Randomperson123324/enviroment-monitor/README.md

# ENV//MONITOR

**ระบบเฝ้าระวังสภาพแวดล้อมภายในอาคารและประเมินความจดจ่อด้วยเทคโนโลยี AIoT**

*An AIoT System for Indoor Environmental Monitoring and Attention Assessment*

---

## 1. ที่มาและความสำคัญ

การเรียนและการทำงานส่วนใหญ่เกิดขึ้น**ภายในอาคาร** ซึ่งเป็นพื้นที่ปิดที่สภาพแวดล้อมเบี่ยงเบนจาก
ธรรมชาติได้มาก — คาร์บอนไดออกไซด์สะสมจากลมหายใจ อุณหภูมิถูกควบคุมด้วยเครื่องปรับอากาศ
ฝุ่นละอองลอดเข้ามาจากภายนอก และเสียงรบกวนจากคนรอบข้าง

งานวิจัยในช่วงสองทศวรรษที่ผ่านมาแสดงให้เห็นว่าปัจจัยเหล่านี้**ไม่ได้ส่งผลแค่ความสบาย** แต่กระทบถึง
สมรรถนะการคิดและความสามารถในการจดจ่ออย่างวัดได้ อย่างไรก็ตาม งานวิจัยส่วนใหญ่**ศึกษาทีละปัจจัย
ในห้องปฏิบัติการ** ขณะที่สภาพจริงปัจจัยเหล่านี้เกิดขึ้นพร้อมกัน

## 2. แนวคิดของระบบ

โครงงานนี้จึงสร้างระบบที่วัดปัจจัยแวดล้อม **หลายตัวพร้อมกันแบบต่อเนื่อง** ควบคู่กับ
**ตัวชี้วัดพฤติกรรมความจดจ่อจากกล้อง** เพื่อให้เห็นความสัมพันธ์ในสภาพการใช้งานจริง
แล้วแปลผลให้ผู้ใช้ที่ไม่ใช่ผู้เชี่ยวชาญอ่านเข้าใจได้ด้วยปัญญาประดิษฐ์

จุดที่ต่างจากเครื่องวัดอากาศทั่วไปคือ ระบบไม่ได้ตอบแค่ *"อากาศตอนนี้เป็นอย่างไร"*
แต่ตอบว่า ***"ห้องนี้กำลังส่งผลกับคนที่อยู่ในนั้นอย่างไร"***

> ที่มาของเกณฑ์เตือนทุกค่า พร้อมรายการอ้างอิง 16 รายการ อยู่ใน
> [`docs/devices/research-basis.md`](docs/devices/research-basis.md) — ใช้เป็นบทที่ 2 ของเล่มรายงาน

## 3. สถาปัตยกรรม

```
  ┌──────────── อุปกรณ์ตรวจวัด ────────────┐
  │  ESP32-S3  (esp32s3-station-01)        │
  │    SCD40   CO₂ / อุณหภูมิ / ความชื้น    │
  │    SGP30   TVOC / eCO₂                 │        ┌─────────────────┐
  │    BH1750  ความสว่าง (lux)              │───────▶│  POST           │
  │    PMS7003 PM1 / PM2.5 / PM10          │  HTTPS │  /api/ingest    │
  ├────────────────────────────────────────┤        └────────┬────────┘
  │  Raspberry Pi + กล้อง (pi-vision)       │                 │
  │    จำนวนคน · การหันหน้า · การขยับ       │─────────────────┤
  └────────────────────────────────────────┘                 ▼
                                                    ┌─────────────────┐
                                                    │    Supabase     │
                                                    │  environment    │
                                                    │  focus          │
                                                    └────────┬────────┘
                                                             ▼
                                              ┌──────────────────────────┐
                                              │  Next.js (Vercel)        │
                                              │  แดชบอร์ด · คะแนนห้อง     │
                                              │  · ผู้ช่วย AI             │
                                              └──────────────────────────┘
```

ระบบแบ่งเป็นสี่ส่วนที่ทำงานแยกกันได้ ต่อกันด้วยสัญญาข้อมูลเดียว (`POST /api/ingest`)

| ส่วน | หน้าที่ | เทคโนโลยี |
|---|---|---|
| **สถานีตรวจวัด** | อ่านเซนเซอร์ตามรอบของแต่ละตัว แล้วส่ง JSON ขึ้นเว็บ | ESP32-S3 (Arduino C++) |
| **กล้องวัดความจดจ่อ** | ประมวลผลภาพ *ในเครื่อง* ส่งออกเฉพาะตัวเลขสรุป ไม่ส่งภาพ | Raspberry Pi · Python · MediaPipe |
| **ฐานข้อมูล** | เก็บอนุกรมเวลาของทั้งสองแหล่ง | Supabase (PostgreSQL) |
| **เว็บแดชบอร์ด** | แสดงผล · ให้คะแนน · สรุปด้วย AI | Next.js · React · Chart.js |

## 4. สิ่งที่วัด

| ค่า | เซนเซอร์ | หน่วย |
|---|---|---|
| อุณหภูมิ · ความชื้น | SCD40 | °C · %RH |
| คาร์บอนไดออกไซด์ | SCD40 | ppm |
| eCO₂ · TVOC | SGP30 | ppm · ppb |
| ฝุ่นละออง PM1 / PM2.5 / PM10 | PMS7003 | µg/m³ |
| ความสว่าง | BH1750 | lux |

ทุกค่าถูกตัดสินระดับตามเกณฑ์ใน [`config/sensors.js`](config/sensors.js) แล้วหักคะแนนรวมเป็น
**คะแนนสุขภาพห้อง 0–100**

เกณฑ์ฝุ่นตัดสินจาก**ค่าเฉลี่ยย้อนหลัง** ไม่ใช่ค่าวินาทีเดียว เพราะมาตรฐานฝุ่นเป็นค่าเฉลี่ยรายวัน —
ฝุ่นหนึ่งนาทีจึงไม่ควรพลิกสถานะทั้งห้อง

## 5. หน้าจอ

| หน้า | เนื้อหา |
|---|---|
| **สภาพแวดล้อม** | ค่าปัจจุบันทุกตัวเป็นการ์ดพร้อมกราฟย่อ · กราฟย้อนหลังเต็ม · มาตร AQI · ตารางสถิติ min/avg/max · คะแนนห้องพร้อมบทสรุปจาก AI |
| **การจดจ่อ** | ข้อมูลจากกล้อง — จำนวนคนในห้อง การหันหน้า และการขยับ |
| **สุขภาพ** | ความเสี่ยงโรคที่มาจากสภาพแวดล้อมในห้อง — อุณหภูมิ ความชื้น และฝุ่น PM2.5 |

รองรับสองภาษา (ไทย/อังกฤษ) และธีมสว่าง/มืด

## 6. ปัญญาประดิษฐ์

ระบบเรียกผู้ให้บริการตามลำดับที่ตั้งไว้ จนกว่าจะมีตัวใดตอบ ถ้าล้มทั้งหมดจะตกไปที่**กลไกกฎในเครื่อง**
ซึ่งตอบได้เสมอ — แดชบอร์ดจึงไม่เคยค้างรอ AI

| ผู้ให้บริการ | ทำงานที่ไหน |
|---|---|
| เครื่องตัวเอง (llama.cpp · LM Studio · Ollama) | เครื่อง/เครือข่ายของผู้ใช้ |
| Google Gemini | คลาวด์ |
| WebLLM | ในเบราว์เซอร์ของผู้ใช้เอง ผ่าน WebGPU |

ผู้ช่วยได้รับ **เครื่องมือ** สำหรับไปอ่านข้อมูลเอง (เซนเซอร์ · ประวัติ · ระดับน้ำ · ความเสี่ยงโรค ·
ข้อมูลกล้อง · ค้นเว็บ) แทนการยัดข้อมูลทั้งก้อนลงใน prompt

> **ข้อมูลจากกล้องถูกกันไว้เป็นพิเศษ** — โมเดลในเครื่องเห็นชื่อจริง ส่วนโมเดลบนคลาวด์
> เห็นเป็น**ตัวแปร** (`{{NAME_1}}`) ชื่อคนและรหัสอุปกรณ์ถูกสลับก่อนส่งออกและสลับกลับก่อนแสดงผล
> ผู้ใช้จึงอ่านชื่อจริงตลอด ส่วนผู้ให้บริการไม่เคยเห็นสักชื่อ — สิ่งที่ออกไปคือพฤติกรรม ไม่ใช่ตัวตน
> ปิดการปิดบังตัวตนเมื่อไร คลาวด์ก็หมดสิทธิ์แตะข้อมูลกล้องทันที (`AI_FOCUS_VIA_ALIAS`)

## 7. ขอบเขตและสถานะปัจจุบัน

| หัวข้อ | สถานะ |
|---|---|
| สถานีตรวจวัด ESP32-S3 · แดชบอร์ด · คะแนนห้อง · ผู้ช่วย AI | ใช้งานได้ |
| การเชื่อมข้อมูลน้ำและข้อมูลราชการ | ใช้งานได้ |
| กล้องวัดความจดจ่อ | ใช้งานได้ — ดูโหมดและการเชื่อมต่อใน [`pi-vision/README.md`](pi-vision/README.md) |
| ระดับเสียง (dBA) | ออกแบบไว้ใน [`docs/`](docs/) แล้ว ยังไม่ได้ต่อเข้าระบบ |
| การย้ายสถานีจาก ESP32-S3 ไป Raspberry Pi 5 | เป็นเอกสารออกแบบ ยังไม่ได้ลงมือ |

## 8. โครงสร้างโค้ด

| ที่อยู่ | เนื้อหา |
|---|---|
| `app/` | หน้าเว็บและ API routes (`ingest` · `dashboard` · `history` · `disease` · `ai/*` …) |
| `components/` | ส่วนประกอบหน้าจอทั้งหมด |
| `config/` | เกณฑ์เซนเซอร์ · ค่าตั้งต้นฝั่งไคลเอนต์ · ข้อความสองภาษา |
| `lib/` | ตัวช่วยฝั่งข้อมูล — วิเคราะห์ · กราฟ · Supabase · AI |
| `hooks/` | React hooks (ดึงข้อมูล · ตั้งค่า · ธีม · ภาษา) |
| `multi_sensor_esp32s3/` | เฟิร์มแวร์สถานีตรวจวัด |
| `pi-vision/` | โปรแกรมกล้องฝั่ง Raspberry Pi |
| `docs/` | เอกสารฮาร์ดแวร์ทั้งชุด |

## 9. การติดตั้ง

ต้องมี **Node.js 20** ขึ้นไป

```bash
npm install
cp .env.example .env.local     # ใส่ SUPABASE_URL และ SUPABASE_ANON_KEY
npm run dev                    # http://localhost:3000
```

จำเป็นแค่สองค่าแรกก็รันได้ ที่เหลือมีค่าตั้งต้นอยู่แล้ว — คำอธิบายทุกตัวอยู่ใน [`.env.example`](.env.example)

ระบบดีพลอยบน Vercel โดยคอมมิตที่เข้า `main` จะขึ้น production อัตโนมัติ

## 10. เอกสารเพิ่มเติม

| เอกสาร | เนื้อหา |
|---|---|
| [`docs/README.md`](docs/README.md) | สารบัญเอกสารฮาร์ดแวร์ทั้งชุด |
| [`docs/01-architecture.md`](docs/01-architecture.md) | สถาปัตยกรรมและตารางสรุปเซนเซอร์ |
| [`docs/02-wiring.md`](docs/02-wiring.md) | pinout · I2C address map · ผังต่อสาย |
| [`docs/03-power-budget.md`](docs/03-power-budget.md) | งบกระแสและการเลือกแหล่งจ่ายไฟ |
| [`docs/04-calibration.md`](docs/04-calibration.md) | ขั้นตอนสอบเทียบทุกตัว |
| [`docs/05-data-schema.md`](docs/05-data-schema.md) | คอลัมน์ในฐานข้อมูลและ ingest contract |
| [`docs/06-ai-providers.md`](docs/06-ai-providers.md) | การตั้งค่าผู้ให้บริการ AI |
| [`docs/devices/research-basis.md`](docs/devices/research-basis.md) | ทบทวนวรรณกรรมและที่มาของเกณฑ์ |
| [`pi-vision/README.md`](pi-vision/README.md) | โหมดกล้อง · การวัดความจดจ่อ · การต่อกับแดชบอร์ด |
