Randomperson123324/enviroment-monitor/docs/03-power-budget.md

# 03 — งบกำลังไฟ

[← กลับสารบัญ](README.md)

---

## 1. สรุปสั้น

| ราง | โหลดเฉลี่ย | โหลดสูงสุด (peak) | เพียงพอไหม |
|---|---|---|---|
| ราง | โหลดเฉลี่ย | โหลดสูงสุด (peak) | สถานะ |
|---|---|---|---|
| **3V3** (จากหัวต่อ GPIO) | ~78 mA | ~270 mA | ⚠️ ต้องมี bulk capacitor — ดู [§2](#2-งบกระแสราง-3v3) |
| **5V** (จากหัวต่อ GPIO) | 250 mA | 330 mA | ✅ สบาย |
| **USB** (ไมค์ + webcam) | ~150–400 mA | ~600 mA | ⚠️ ต้องใช้ PSU 5V/5A ไม่งั้นถูกจำกัดที่ 600 mA รวม |
| **Pi 5 เอง** | ~1.0–1.5 A @5V | ~2.5 A @5V | — |
| **รวมทั้งระบบ** | ~9.3 W | ~17.5 W | ✅ ใช้ PSU 27W ทางการ |

**สรุป: ใช้ Raspberry Pi 27W USB-C Power Supply (5.1V / 5A) ของทางการ ไม่มีข้อยกเว้น**

---

## 2. งบกระแสราง 3V3

ทุกตัวจ่ายไฟจากขา 3V3 ของหัวต่อ GPIO

| อุปกรณ์ | กระแสเฉลี่ย | กระแสสูงสุด | ที่มา |
|---|---|---|---|
| SCD40 | 15–18 mA (รอบวัด 5 วินาที) | **175–205 mA** (พัลส์ตอนวัด) | datasheet ตาราง 4, VDD = 3.3V |
| SGP30 breakout | ~50–60 mA | ~65 mA | ตัวชิป 48.2 mA @1.8V + LDO บน breakout |
| BH1750 | 0.12 mA | 0.19 mA | โหมดวัดต่อเนื่อง |
| ADS1115 | 0.15 mA | 0.2 mA | โหมดแปลงต่อเนื่อง |
| **รวม** | **~78 mA** | **~270 mA** | |

### ⚠️ Raspberry Pi ไม่เคยประกาศเพดานกระแสของขา 3V3

Raspberry Pi Ltd **ไม่ได้ระบุค่าสูงสุดของขา 3V3 บนหัวต่อ GPIO ไว้ในเอกสารทางการ** เพราะ
ค่าที่ใช้ได้จริงคือ "สิ่งที่ PMIC จ่ายได้ ลบด้วยสิ่งที่ SoC และวงจรอื่นบนบอร์ดใช้ไป"
ซึ่งเปลี่ยนตามภาระงานของบอร์ด — จึงไม่มีตัวเลขรับประกัน

**สิ่งที่พูดได้อย่างมั่นใจ:**

- กระแสเฉลี่ย ~78 mA เป็นภาระที่ต่ำมาก — แทบไม่มีความเสี่ยง
- **พัลส์ 270 mA ของ SCD40 คือส่วนที่ต้องจัดการ** ไม่ใช่เพราะปริมาณ แต่เพราะเป็นการกระชากเร็ว
  ที่ทำให้แรงดันตกชั่วขณะบนสายและกวนอุปกรณ์ I2C ตัวอื่น
- **bulk capacitor คือทางแก้** — มันจ่ายพลังงานให้พัลส์แทนที่จะดึงจากรางโดยตรง

**ถ้าต้องการความมั่นใจสูงสุด** (เช่น จะเพิ่มเซนเซอร์อีกในอนาคต) ให้จ่ายไฟ 3.3V
ให้กลุ่มเซนเซอร์จาก **LDO แยก** ที่รับ 5V จากหัวต่อ GPIO แทนการดึงจากขา 3V3 โดยตรง
เช่น AMS1117-3.3 หรือ MCP1700-3302 — ราคาไม่กี่บาทและตัดปัญหาทั้งหมดทิ้ง
(อย่าลืมต่อกราวด์ร่วมกับ Pi และคง capacitor ทั้งหมดไว้ตามเดิม)

### ทำไมต้องมี bulk capacitor

SCD40 กินกระแสเป็น**พัลส์** — ตอนยิงแหล่งกำเนิด IR จะกระชากถึง 205 mA ในช่วงสั้น ๆ ทุก 5 วินาที
ถ้าสายไฟยาวหรือบาง แรงดันจะตกชั่วขณะ (droop) และไปกวนอุปกรณ์ I2C ตัวอื่นบนบัสเดียวกัน

datasheet ระบุชัดว่า **ripple ของแหล่งจ่ายต้องไม่เกิน 30 mV peak-to-peak** ไม่งั้นค่า CO₂ จะไม่นิ่ง

**สิ่งที่ต้องทำ:**

```
3V3 ──┬── 100 µF อิเล็กโทรไลต์/แทนทาลัม ──┬── GND     ← วางใกล้ SCD40 ที่สุด
      └── 100 nF เซรามิก ─────────────────┘            ← คร่อม VDD-GND ของแต่ละบอร์ด
```

- **100 µF** วางที่ปลายสายฝั่งเซนเซอร์ (ไม่ใช่ฝั่ง Pi) รับพัลส์ของ SCD40
- **100 nF** หนึ่งตัวต่อหนึ่งบอร์ด คร่อมขา VDD–GND ให้ใกล้ที่สุด (SGP30 datasheet บังคับข้อนี้)
- ใช้สายเบอร์ใหญ่ขึ้น (AWG 24 แทน AWG 28) สำหรับราง 3V3 ถ้าสายยาวเกิน 20 cm

---

## 3. งบกระแสราง 5V

| อุปกรณ์ | กระแสเฉลี่ย | กระแสสูงสุด | ที่มา |
|---|---|---|---|
| PMS7003 (พัดลม + เลเซอร์) | ≤100 mA | ~150 mA ตอนสตาร์ทพัดลม | datasheet: active ≤100 mA · standby ≤200 µA |
| MQ-2 (ฮีตเตอร์) *ถ้าใช้* | ~150 mA | ~180 mA | ฮีตเตอร์ ~800 mW ต่อเนื่อง |
| **รวม** | **250 mA** | **330 mA** | |

### กระแสกระชากตอนสตาร์ทพัดลม PMS7003

มอเตอร์พัดลมกินกระแสสูงกว่าปกติในช่วง ~100 ms แรกตอนเริ่มหมุน ถ้าใช้โหมด sleep/wake บ่อย ๆ
(ผ่านขา SET) จะเกิดพัลส์แบบนี้ทุกครั้ง

**ทางแก้:** วาง capacitor **220 µF** คร่อม VCC–GND ที่ขั้วต่อ PMS7003 และ**อย่าใช้โหมด sleep/wake
ในการทำงานปกติ** — ปล่อยให้พัดลมหมุนต่อเนื่องนิ่งกว่า แถม datasheet ยังบอกว่าต้องรอ 30 วินาที
หลังตื่นถึงจะได้ค่าที่เชื่อถือได้ ซึ่งทำให้แทบไม่ประหยัดไฟเลยถ้ารอบอัปโหลดคือ 5 วินาที

> โหมด sleep มีประโยชน์เฉพาะกรณีใช้แบตเตอรี่และวัดแบบนาน ๆ ครั้ง (เช่นทุก 10 นาที) เท่านั้น

---

## 4. งบกระแส USB — ประเด็นสำคัญ

Raspberry Pi 5 **จำกัดกระแสรวมของพอร์ต USB ทั้งสี่ไว้ที่ 600 mA** เป็นค่าเริ่มต้น
และจะปลดล็อกเป็น **1.6 A ก็ต่อเมื่อตรวจพบ PSU ที่จ่าย 5V/5A ผ่าน USB Power Delivery**

| อุปกรณ์ USB | กระแส |
|---|---|
| USB microphone (UAC ธรรมดา) | ~50–100 mA |
| USB webcam 720p | ~150–250 mA |
| USB webcam 1080p (เช่น C920) | ~250–400 mA |

**สถานการณ์:**

| PSU ที่ใช้ | เพดาน USB | ไมค์อย่างเดียว | ไมค์ + webcam 1080p |
|---|---|---|---|
| อะแดปเตอร์ 5V/3A ทั่วไป | 600 mA | ✅ ผ่าน | ⚠️ เสี่ยงเกิน — ภาพกระตุก/หลุด |
| **Raspberry Pi 27W ทางการ (5V/5A)** | 1.6 A | ✅ ผ่าน | ✅ ผ่านสบาย |

> ถ้าจำเป็นต้องใช้ PSU ที่ไม่ใช่ตัวทางการ สามารถบังคับปลดล็อกได้ด้วย
> `usb_max_current_enable=1` ใน `/boot/firmware/config.txt`
> **แต่ต้องแน่ใจว่า PSU จ่ายได้จริง 5A** ไม่งั้นแรงดันจะตกจนบอร์ดรีบูตเอง หรือ SD card เสียหาย

**ทางเลือกที่ปลอดภัยกว่า** สำหรับกล้อง: ใช้ **Camera Module 3 ผ่าน CSI-2** แทน USB webcam
เพราะไม่กินโควตา USB เลย → ดู [devices/camera.md](devices/camera.md)

---

## 5. งบกำลังไฟรวมทั้งระบบ

| ส่วน | กำลัง (เฉลี่ย) | กำลัง (สูงสุด) |
|---|---|---|
| Raspberry Pi 5 (ไม่มีโหลด CPU หนัก) | ~5.0 W | ~9 W |
| Pi 5 ตอนประมวลผลภาพ (face detection) | +2.0 W | +4 W |
| เซนเซอร์ราง 3V3 | 0.26 W | 0.89 W |
| เซนเซอร์ราง 5V | 1.25 W | 1.65 W |
| USB (ไมค์ + webcam) | 0.75 W | 2.00 W |
| **รวม** | **~9.3 W** | **~17.5 W** |
| **PSU 27W ทางการ** | | **เหลือหัว ~35%** ✅ |

> ตัวเลข "สูงสุด" คือกรณีที่ทุกอย่างกินกระแสสูงสุดพร้อมกัน ซึ่งในทางปฏิบัติแทบไม่เกิดขึ้น
> (SCD40 กระชากเป็นพัลส์สั้น ๆ ทุก 5 วินาที ไม่ตรงกับจังหวะพัดลม PMS7003 สตาร์ท)
> จึงเป็นการประเมินแบบอนุรักษ์นิยม — ปลอดภัยสำหรับการเลือก PSU

---

## 6. Checklist ก่อนเสียบไฟครั้งแรก

- [ ] ใช้ Raspberry Pi 27W USB-C PSU ของทางการ (หรือ PSU ที่รับรอง 5V/5A จริง)
- [ ] SCD40 อยู่ราง **3V3** ไม่ใช่ 5V — ตรวจซ้ำด้วยมัลติมิเตอร์ก่อนเสียบไฟ
- [ ] PMS7003 อยู่ราง **5V** และต่อครบทั้งขา 1+2 (VCC) และ 3+4 (GND)
- [ ] มี 100 nF คร่อม VDD–GND ของทุกบอร์ด I2C
- [ ] มี 100 µF ที่ปลายสาย 3V3 ฝั่งเซนเซอร์
- [ ] มี 220 µF ที่ขั้ว VCC ของ PMS7003
- [ ] กราวด์ทุกตัวต่อร่วมกับ Pi
- [ ] สาย I2C ยาวไม่เกิน 30 cm
- [ ] ขา 6 และ 8 ของ PMS7003 (NC) ไม่ได้ต่ออะไร

## 7. อาการเมื่อไฟไม่พอ และวิธีวินิจฉัย

| อาการ | สาเหตุที่น่าจะเป็น | วิธีตรวจ |
|---|---|---|
| ค่า CO₂ กระโดดขึ้นลงเป็นฟันเลื่อย | ripple ราง 3V3 เกิน 30 mV | เพิ่ม bulk cap · ใช้สายหนาขึ้น · วัด ripple ด้วยออสซิลโลสโคป |
| `i2cdetect` เจออุปกรณ์ไม่ครบเป็นบางครั้ง | แรงดันตกตอน SCD40 ยิงพัลส์ | เพิ่ม 100 µF ใกล้ SCD40 |
| Pi รีบูตเองตอนพัดลม PMS7003 สตาร์ท | กระแสกระชากเกินที่ PSU จ่ายไหว | เพิ่ม 220 µF · เปลี่ยน PSU |
| ไอคอนสายฟ้าขึ้นบนหน้าจอ / `Undervoltage detected` ใน `dmesg` | PSU ไม่พอหรือสาย USB-C คุณภาพต่ำ | `vcgencmd get_throttled` — ควรได้ `0x0` |
| webcam หลุดเป็นระยะ | เกินโควตา USB 600 mA | ใช้ PSU 5A · หรือย้ายไปใช้ CSI camera |

ตรวจสถานะไฟด้วย:

```bash
vcgencmd get_throttled        # 0x0 = ปกติ · bit 0 = under-voltage ตอนนี้ · bit 16 = เคยเกิด
vcgencmd measure_volts core
dmesg | grep -iE 'voltage|usb.*current|over-?current'
```

---

[← ก่อนหน้า: การต่อสาย](02-wiring.md) · [ถัดไป: การ calibrate →](04-calibration.md)
