Randomperson123324/enviroment-monitor/docs/devices/scd40.md

# SCD40 — เซนเซอร์ CO₂ / อุณหภูมิ / ความชื้น

[← กลับสารบัญ](../README.md) · [ผู้ผลิต: Sensirion](https://sensirion.com/media/documents/48C4B7FB/67FE0194/CD_DS_SCD4x_Datasheet_D1.pdf)

> **บทบาทในระบบนี้:** SCD40 เป็น**แหล่งข้อมูลหลัก**ของทั้ง CO₂, อุณหภูมิ และความชื้น
> มาแทน DHT22 เดิมทั้งหมด — แม่นกว่า, มี CRC, และไม่มีปัญหา timing ที่ DHT มี

---

## 1. สเปกจาก datasheet (v1.7, เมษายน 2025)

### การวัด CO₂

| รายการ | ค่า |
|---|---|
| หลักการทำงาน | Photoacoustic NDIR |
| ช่วงค่าที่ส่งออก | 0–40,000 ppm |
| ความแม่นยำ | **±(50 ppm + 5% ของค่าที่อ่าน)** ที่ 400–2,000 ppm |
| ความสามารถทำซ้ำ | ±10 ppm |
| เวลาตอบสนอง (τ63%) | 60 วินาที (เปลี่ยนจาก 400 → 2,000 ppm) |
| การ drift หลังปีที่ 5 | ±(5 ppm + 0.5% ของค่าที่อ่าน) ต่อปี |

### การวัดความชื้น

| รายการ | ค่า |
|---|---|
| ช่วงวัด | 0–100 %RH |
| ความแม่นยำ | ±6 %RH (ที่ 15–35 °C, 20–65 %RH) · ±9 %RH (ที่ −10–60 °C, 0–100 %RH) |
| ความสามารถทำซ้ำ | ±0.4 %RH |
| เวลาตอบสนอง (τ63%) | 90 วินาที |
| การ drift | < 0.25 %RH/ปี |

### การวัดอุณหภูมิ

| รายการ | ค่า |
|---|---|
| ช่วงวัด | −10 ถึง 60 °C |
| ความแม่นยำ | ±0.8 °C (ที่ 15–35 °C) · ±1.5 °C (ที่ −10–60 °C) |
| ความสามารถทำซ้ำ | ±0.1 °C |
| เวลาตอบสนอง (τ63%) | 120 วินาที |
| การ drift | < 0.03 °C/ปี |

### ไฟฟ้า

| รายการ | ค่า |
|---|---|
| แรงดันไฟเลี้ยง | 2.4 – 5.5V (ปกติ 3.3V หรือ 5.0V) |
| **Ripple ที่ยอมรับได้** | **≤ 30 mV peak-to-peak** ⚠️ |
| กระแสสูงสุด (peak) | 175 mA ปกติ / **205 mA สูงสุด** ที่ VDD = 3.3V |
| กระแสเฉลี่ย (รอบ 5 วินาที) | 15 mA ปกติ / 18 mA สูงสุด ที่ VDD = 3.3V |
| กระแสเฉลี่ย (โหมดประหยัด รอบ 30 วินาที) | 3.2 mA ปกติ / 3.5 mA สูงสุด |
| แรงดัน input HIGH | ≥ 0.65 × VDD |
| แรงดัน input LOW | ≤ 0.3 × VDD |
| เวลาบูตหลังจ่ายไฟ | 30 ms |
| ความถี่ SCL | 0 – 400 kHz |
| ที่อยู่ I2C | **`0x62`** (ตายตัว เปลี่ยนไม่ได้) |
| อายุการใช้งาน | > 10 ปี |
| ความชื้นที่ทำงานได้ | 0–95 %RH (ไม่ควบแน่น) |

---

## 2. ⚠️ คำเตือนเรื่องแรงดัน

**SCD40 ในระบบนี้ต้องจ่ายไฟ 3.3V เท่านั้น**

datasheet ระบุว่ารับไฟได้ 2.4–5.5V ซึ่งถูกต้อง — แต่ระดับลอจิกของขา SDA/SCL **อ้างอิงกับ VDD**:

| VDD | V<sub>IH</sub> (ต้องการอย่างน้อย) | ระดับสัญญาณที่เซนเซอร์ปล่อยออกมาบนบัส |
|---|---|---|
| 3.3V | 2.15V | 0 – 3.3V ✅ ปลอดภัยกับ Pi |
| 5.0V | 3.25V | 0 – 5.0V ❌ **ทำ GPIO ของ Pi พัง** |

Raspberry Pi ทนได้สูงสุด 3.3V บนขา GPIO **การจ่ายไฟ 5V ให้ SCD40 จะทำให้ pull-up ภายในเซนเซอร์
ดึงบัส I2C ขึ้นไป 5V และทำลาย GPIO ของ Pi อย่างถาวร**

> ✅ ต่อ VDD ของ SCD40 เข้าขา 1 (3V3) ของ Pi
> ❌ **ห้าม**ต่อเข้าขา 2 หรือ 4 (5V) เด็ดขาด
> 🔍 วัดด้วยมัลติมิเตอร์ยืนยันก่อนเสียบไฟครั้งแรก

**ผลข้างเคียงที่ต้องยอมรับ:** ที่ 3.3V เซนเซอร์กินกระแส peak สูงกว่า (205 mA เทียบกับ 137 mA ที่ 5V)
จึงต้องมี bulk capacitor → ดู [03-power-budget.md](../03-power-budget.md#ทำไมต้องมี-bulk-capacitor)

---

## 3. การต่อสาย

| SCD40 | หน้าที่ | → Pi 5 (ขา) |
|---|---|---|
| VDD | ไฟเลี้ยง | **ขา 1 (3V3)** |
| VDDH | ไฟเลี้ยงแหล่ง IR | ต่อร่วมกับ VDD (บอร์ด breakout ต่อให้แล้ว) |
| GND | กราวด์ | ขา 20 (GND) |
| SDA | ข้อมูล I2C | ขา 3 (GPIO2) |
| SCL | นาฬิกา I2C | ขา 5 (GPIO3) |
| DNC | ห้ามต่อ | — |

พร้อม capacitor 100 nF คร่อม VDD–GND และ 100 µF ที่ปลายสายฝั่งเซนเซอร์

---

## 4. คำสั่ง I2C ที่ใช้

ทุกคำสั่งเป็นรหัส 16 บิต · ข้อมูลทุก word (2 ไบต์) ตามด้วย **CRC-8 หนึ่งไบต์**
(polynomial `0x31`, init `0xFF`, ไม่ reflect, final XOR `0x00` — เหมือนกับ SGP30)

| คำสั่ง | รหัส | ใช้ตอนไหน |
|---|---|---|
| `start_periodic_measurement` | `0x21B1` | เริ่มวัดต่อเนื่อง (อัปเดตทุก 5 วินาที) |
| `read_measurement` | `0xEC05` | อ่านค่า CO₂ + T + RH (9 ไบต์) |
| `stop_periodic_measurement` | `0x3F86` | หยุดก่อนส่งคำสั่งตั้งค่า |
| `set_temperature_offset` | `0x241D` | ชดเชยความร้อนจากบอร์ด 🔑 |
| `set_sensor_altitude` | `0x2427` | ตั้งความสูงจากระดับน้ำทะเล (เมตร) |
| `set_ambient_pressure` | `0xE000` | ตั้งความดันบรรยากาศ (Pa) — แม่นกว่า altitude |
| `perform_forced_recalibration` | `0x362F` | calibrate แบบบังคับ (FRC) |
| `set_automatic_self_calibration_enabled` | `0x2416` | เปิด/ปิด ASC |
| `get_data_ready_status` | `0xE4B8` | เช็คว่ามีค่าใหม่พร้อมหรือยัง |
| `get_serial_number` | `0x3682` | ตรวจว่าเซนเซอร์ตอบสนอง |
| `persist_settings` | `0x3615` | บันทึกค่าตั้งลง EEPROM ⚠️ ใช้ให้น้อยที่สุด |
| `reinit` | `0x3646` | โหลดค่าจาก EEPROM ใหม่ |

### รูปแบบข้อมูลที่อ่านได้ (`read_measurement`)

ตอบกลับ 9 ไบต์:

```
[CO2_MSB][CO2_LSB][CRC]  [T_MSB][T_LSB][CRC]  [RH_MSB][RH_LSB][CRC]
```

**สูตรแปลงค่า:**

```
CO₂ (ppm)  = ค่าดิบ                              (ใช้ได้ตรง ๆ)
T  (°C)    = −45 + 175 × (ค่าดิบ / 2¹⁶)
RH (%)     = 100 × (ค่าดิบ / 2¹⁶)
```

### ลำดับการทำงานที่ถูกต้อง

```
1. รอ 30 ms หลังจ่ายไฟ (power-up time)
2. stop_periodic_measurement      ← เผื่อค้างจากรอบก่อน · รอ 500 ms
3. get_serial_number              ← ยืนยันว่าเซนเซอร์ตอบสนอง
4. set_temperature_offset(ค่าจาก config)
5. set_sensor_altitude(ค่าจาก config)  หรือ  set_ambient_pressure()
6. set_automatic_self_calibration_enabled(ค่าจาก config)
7. start_periodic_measurement
8. วนลูป: ทุก 5 วินาที → get_data_ready_status → read_measurement
```

> ⚠️ **ระหว่างที่ periodic measurement ทำงานอยู่ ห้ามส่งคำสั่งอื่น**
> ยกเว้น `read_measurement`, `get_data_ready_status`, `stop_periodic_measurement`
> และ `set_ambient_pressure` เท่านั้น

> ⚠️ **`persist_settings` เขียน EEPROM ซึ่งมีจำนวนรอบจำกัด**
> เรียกเฉพาะตอนตั้งค่าครั้งแรกหรือหลัง calibrate เท่านั้น **ห้ามเรียกทุกครั้งที่บูต**

---

## 5. ไลบรารี Python

```bash
pip install sensirion-i2c-scd4x sensirion-i2c-driver
# หรือ
pip install adafruit-circuitpython-scd4x
```

| ไลบรารี | ข้อดี | ข้อเสีย |
|---|---|---|
| `sensirion-i2c-scd4x` | ทางการจากผู้ผลิต · ครบทุกคำสั่ง | เอกสารน้อยกว่า |
| `adafruit-circuitpython-scd4x` | ใช้ง่าย · ตัวอย่างเยอะ | ต้องพึ่ง Blinka |

> **แนะนำ `sensirion-i2c-scd4x`** เพราะเป็นของผู้ผลิตโดยตรง จึงตามการเปลี่ยนแปลงของ datasheet ทัน
> และรองรับคำสั่ง FRC/ASC ครบถ้วนซึ่งจำเป็นสำหรับโปรเจกต์นี้

---

## 6. 🔑 Temperature offset — ขั้นตอนที่สำคัญที่สุด

SCD40 วัดอุณหภูมิที่ตัวชิปเอง ซึ่ง**ร้อนกว่าอากาศจริงเสมอ** เพราะ:

1. ความร้อนที่ตัวเซนเซอร์สร้างเอง (self-heating)
2. ความร้อนจาก SoC ของ Pi 5 ที่แผ่มาตามแผ่น PCB และอากาศ

**ค่านี้ไม่กระทบแค่อุณหภูมิ** — เซนเซอร์ใช้ค่าอุณหภูมิไปคำนวณความชื้นสัมพัทธ์ด้วย
ดังนั้น offset ที่ผิดจะทำให้ **RH ผิดตามไปด้วย** และ datasheet ระบุว่า
ค่าความแม่นยำที่โฆษณาไว้ทั้งหมดจะเป็นจริง**ก็ต่อเมื่อตั้ง temperature offset ถูกต้อง**

**ค่าเริ่มต้นจากโรงงานคือ 4 °C** ซึ่งเหมาะกับการติดตั้งบน PCB เล็ก ๆ ไม่ใช่กรณีนี้

### วิธีหาค่า offset ที่ถูกต้อง

```
1. ประกอบระบบให้เสร็จสมบูรณ์ในกล่อง/ตำแหน่งจริงที่จะใช้งาน
2. เปิดระบบทิ้งไว้ให้อุณหภูมิเข้าสู่สมดุล  ≥ 30 นาที  (ไม่ใช่ 5 นาที)
3. วางเทอร์โมมิเตอร์อ้างอิงที่แม่นยำไว้ข้าง ๆ ตัวเซนเซอร์
4. offset ใหม่ = offset ปัจจุบัน + (T ที่ SCD40 อ่าน − T อ้างอิง)
5. set_temperature_offset(offset ใหม่)
6. persist_settings()      ← เรียกครั้งเดียวเท่านั้น
7. รออีก 30 นาที แล้วตรวจซ้ำ
```

ค่าที่พบบ่อยเมื่อวางใกล้ Pi 5: **6–10 °C** (สูงกว่าค่าเริ่มต้น 4 °C มาก)

> **วิธีที่ดีกว่าการปรับ offset สูง ๆ คือย้ายเซนเซอร์ให้ห่างจากแหล่งความร้อน**
> ต่อ SCD40 ผ่านสาย I2C ยาว 10–20 cm ออกไปนอกกล่อง แล้ว offset จะเหลือแค่ 1–3 °C
> ซึ่งแม่นยำกว่ามาก เพราะการชดเชยด้วยตัวเลขคงที่จะไม่แม่นเมื่อโหลด CPU เปลี่ยน

---

## 7. การชดเชยความดันบรรยากาศ

การวัด CO₂ แบบ NDIR ขึ้นกับความหนาแน่นของอากาศ จึงต้องบอกความสูงหรือความดันให้เซนเซอร์ทราบ

| วิธี | คำสั่ง | ความแม่นยำ | หมายเหตุ |
|---|---|---|---|
| ตั้งความสูง (คงที่) | `set_sensor_altitude` (เมตร) | พอใช้ | ตั้งครั้งเดียว · ต้อง persist |
| ตั้งความดัน (แบบไดนามิก) | `set_ambient_pressure` (Pa) | **แม่นกว่า** | ส่งใหม่ได้ตลอดขณะวัด · ไม่ต้อง persist |

ค่าความสูงคร่าว ๆ ในไทย: กรุงเทพฯ ~2 m · เชียงใหม่ ~310 m · เชียงราย ~400 m · นครราชสีมา ~180 m

> ที่ระดับความสูงต่ำอย่างกรุงเทพฯ ผลกระทบแทบไม่มีนัยสำคัญ (< 1%)
> แต่ควรตั้งไว้เพื่อความถูกต้อง และ**จำเป็น**ถ้าติดตั้งบนภาคเหนือ

**ทางเลือกขั้นสูง:** ถ้าอยากส่งค่าความดันจริงเข้า `set_ambient_pressure` แบบไดนามิก
ต้องหาแหล่งข้อมูลความกดอากาศเอง — โปรเจกต์นี้เคยดึงฟีดกรมอุตุฯ (TMD) ผ่าน `lib/gov.js`
แต่ถอดออกแล้ว เหลือเฉพาะข้อมูลน้ำ (ThaiWater · กรมชลประทาน) — และเป็นงาน optimization
ที่ทำทีหลังได้ ไม่ต้องรีบ

---

## 8. การ calibrate CO₂ — ASC เทียบกับ FRC

รายละเอียดเต็มอยู่ใน [04-calibration.md](../04-calibration.md#scd40--co₂) — สรุปตรงนี้:

| | **ASC** (Automatic Self-Calibration) | **FRC** (Forced Recalibration) |
|---|---|---|
| หลักการ | สมมติว่าค่าต่ำสุดที่เจอในรอบ ~7 วันคืออากาศบริสุทธิ์ (400 ppm) | บอกเซนเซอร์ตรง ๆ ว่าตอนนี้คือกี่ ppm |
| ต้องการอะไร | ต้องได้สัมผัสอากาศ ~400 ppm **สัปดาห์ละครั้ง** | ต้องพาไปที่อากาศบริสุทธิ์ครั้งเดียว |
| ข้อดี | ตั้งแล้วลืมได้ | แม่นทันที ควบคุมได้ |
| ข้อเสีย | **ห้องที่ปิดตลอดจะทำให้ค่าเพี้ยนสะสม** | ต้องทำเอง |
| ค่าเริ่มต้น | เปิดอยู่ | — |

### ⚠️ ประเด็นสำคัญสำหรับห้องปรับอากาศในไทย

ห้องแอร์ที่ปิดตลอดเวลามักไม่เคยลงถึง 400 ppm เลย (มักอยู่ที่ 600–1,200 ppm)
ASC จะเข้าใจผิดว่าค่าต่ำสุดที่เจอ (เช่น 650 ppm) คือ 400 ppm แล้ว**ลบทุกค่าลงไป 250 ppm**
ทำให้ค่าที่แสดงต่ำกว่าความจริงอย่างเป็นระบบ

**แนวทางที่แนะนำ:**

| สถานการณ์ | ทำอย่างไร |
|---|---|
| ห้องเปิดหน้าต่าง/ระบายอากาศทุกสัปดาห์ | เปิด ASC ไว้ (ค่าเริ่มต้น) |
| **ห้องแอร์ปิดตลอด** | **ปิด ASC** แล้วทำ FRC ทุก 6–12 เดือน |
| ไม่แน่ใจ | ปิด ASC + ทำ FRC — ปลอดภัยกว่า |

> datasheet ระบุว่าควรทำ FRC **หลังประกอบเสร็จอย่างน้อย 5 วัน** ไม่ใช่ทันที
> เพราะสารระเหยจากบัดกรีและกาวยังรบกวนค่าอยู่

---

## 9. เกณฑ์ค่า CO₂ ที่แนะนำสำหรับแดชบอร์ด

| ระดับ | ช่วง (ppm) | ความหมาย |
|---|---|---|
| อากาศภายนอก | 400–450 | ค่าอ้างอิงอากาศบริสุทธิ์ |
| ดี | < 800 | การระบายอากาศเพียงพอ |
| ปานกลาง | 800–1,000 | เริ่มควรระบายอากาศ |
| แย่ | 1,000–1,500 | เริ่มมีผลต่อสมาธิและความง่วง |
| แย่มาก | 1,500–2,500 | ปวดหัว เหนื่อย สมาธิลดลงชัดเจน |
| อันตราย | > 2,500 | ต้องระบายอากาศทันที |

> 1,000 ppm เป็นเกณฑ์ที่ใช้กันแพร่หลายในมาตรฐานคุณภาพอากาศภายในอาคาร
> และเหมาะกับโปรเจกต์นี้เป็นพิเศษเพราะเชื่อมโยงโดยตรงกับ **Focus feature** —
> CO₂ สูงสัมพันธ์กับสมาธิที่ลดลงและความง่วง ซึ่งเป็นสิ่งที่ webcam EAR detection วัดอยู่แล้ว

ค่าเหล่านี้ต้องอยู่ใน `config/sensors.js → THRESHOLDS.co2` เท่านั้น

---

## 10. การแก้ปัญหา

| อาการ | สาเหตุที่น่าจะเป็น | วิธีแก้ |
|---|---|---|
| `i2cdetect` ไม่เจอ `0x62` | ไฟไม่ถึง · SDA/SCL สลับ · กราวด์ไม่ร่วม | ตรวจ 3.3V ที่ VDD · ตรวจสาย |
| อุณหภูมิสูงกว่าจริง 5–10 °C | temperature offset ผิด | ทำตาม [§6](#6--temperature-offset--ขั้นตอนที่สำคัญที่สุด) |
| ความชื้นต่ำกว่าจริงตลอด | เป็นผลพวงจาก offset ผิด | แก้ offset แล้ว RH จะถูกตาม |
| CO₂ กระโดดเป็นฟันเลื่อย | ripple ราง 3V3 เกิน 30 mV | เพิ่ม bulk capacitor 100 µF |
| CO₂ ต่ำกว่าจริง ~200–300 ppm | ASC เพี้ยนเพราะห้องปิดตลอด | ปิด ASC + ทำ FRC |
| CO₂ ค้างที่ค่าเดิม | อ่านเร็วกว่ารอบ 5 วินาที | เช็ค `get_data_ready_status` ก่อนอ่าน |
| CO₂ กระโดดขึ้นเป็นพัน ๆ เป็นครั้งคราว | มีคนหายใจใส่เซนเซอร์โดยตรง | ย้ายตำแหน่งติดตั้ง |
| CRC ผิดบ่อย | บัส I2C ไม่นิ่ง | ลดความเร็วเป็น 50 kHz · สายสั้นลง |
| คำสั่งตั้งค่าไม่มีผล | ยังอยู่ใน periodic measurement mode | `stop_periodic_measurement` ก่อน แล้วรอ 500 ms |

---

[← กลับสารบัญ](../README.md)
