Randomperson123324/enviroment-monitor/docs/devices/bh1750.md

# BH1750 — เซนเซอร์วัดความสว่าง (lux)

[← กลับสารบัญ](../README.md) · [ผู้ผลิต: ROHM](https://www.handsontec.com/dataspecs/sensor/BH1750%20Light%20Sensor.pdf)

> **ทำไมถึงเลือกตัวนี้แทน LDR:** BH1750 ส่งค่าเป็น **lux โดยตรง** ไม่ต้องแปลงจากแรงดัน
> ไม่ต้องใช้ ADC (ซึ่ง Pi 5 ไม่มี) และการตอบสนองต่อสเปกตรัมใกล้เคียงสายตามนุษย์
> LDR ให้แค่ความต้านทานที่ไม่เป็นเชิงเส้น ต้องปรับเทียบเอง และเพี้ยนตามอุณหภูมิ

---

## 1. สเปกจาก datasheet

| รายการ | ค่า |
|---|---|
| ชื่อชิปเต็ม | BH1750FVI |
| ช่วงวัด | **1 – 65,535 lx** |
| ความแม่นยำ | ±20% ทั่วไป (ค่าสัมประสิทธิ์การวัด 0.96 – 1.44) |
| การตอบสนองสเปกตรัม | ใกล้เคียงการมองเห็นของมนุษย์ (peak ~560 nm) |
| อิทธิพลจากแสงอินฟราเรด | ต่ำมาก |
| แรงดันไฟเลี้ยง (ตัวชิป) | 2.4 – 3.6V |
| แรงดันไฟเลี้ยง (โมดูล GY-302) | 3.3 – 5V (มี regulator บนบอร์ด) |
| กระแสตอนทำงาน | ~120 µA ทั่วไป |
| กระแสตอน power-down | ~0.01 µA |
| **แรงดันสูงสุดของขา ADDR** | **3.6V** ⚠️ |
| ที่อยู่ I2C | **`0x23`** (ค่าเริ่มต้น) หรือ `0x5C` |
| ความถี่ SCL | สูงสุด 400 kHz |
| อุณหภูมิใช้งาน | −40 ถึง +85 °C |

---

## 2. ที่อยู่ I2C

| สถานะขา ADDR | ที่อยู่ |
|---|---|
| ต่อลง GND หรือ **ปล่อยลอย** | **`0x23`** ← ใช้ตัวนี้ |
| ดึงขึ้น HIGH (> 0.7 × VCC) | `0x5C` |

โมดูล GY-302 ส่วนใหญ่มี pull-down บนขา ADDR อยู่แล้ว **ปล่อยลอยได้เลย ไม่ต้องต่ออะไร**

> ⚠️ ถ้าจะดึง ADDR ขึ้น HIGH ต้องใช้ **3.3V ไม่ใช่ 5V** เพราะขานี้ทนได้สูงสุด 3.6V

---

## 3. การต่อสาย

| BH1750 / GY-302 | → Pi 5 (ขา) |
|---|---|
| VCC | ขา 1 (3V3) |
| GND | ขา 14 (GND) |
| SDA | ขา 3 (GPIO2) |
| SCL | ขา 5 (GPIO3) |
| ADDR | ปล่อยลอย |

> แม้โมดูลจะรับ 5V ได้ แต่**ให้ใช้ 3.3V** เพื่อให้ระดับลอจิกบนบัสตรงกับอุปกรณ์ตัวอื่นทั้งหมด
> และลดโอกาสที่ level shifter บนบอร์ดจะทำงานผิดพลาด

---

## 4. คำสั่งและโหมดการวัด

| คำสั่ง | รหัส | ความละเอียด | เวลาวัด |
|---|---|---|---|
| Power Down | `0x00` | — | — |
| Power On | `0x01` | — | — |
| Reset | `0x07` | — | — |
| **Continuous High Res Mode** | `0x10` | **1 lx** | **120 ms** ← แนะนำ |
| Continuous High Res Mode 2 | `0x11` | 0.5 lx | 120 ms |
| Continuous Low Res Mode | `0x13` | 4 lx | 16 ms |
| One Time High Res Mode | `0x20` | 1 lx | 120 ms |
| One Time High Res Mode 2 | `0x21` | 0.5 lx | 120 ms |
| One Time Low Res Mode | `0x23` | 4 lx | 16 ms |

### โหมดที่แนะนำ: Continuous High Resolution Mode (`0x10`)

| เหตุผล | รายละเอียด |
|---|---|
| ความละเอียด 1 lx เพียงพอ | ห้องทำงานทั่วไปอยู่ที่ 300–750 lx — ความละเอียด 0.5 lx ไม่ได้ให้ประโยชน์เพิ่ม |
| ไม่ต้องส่งคำสั่งซ้ำ | ต่างจาก One Time mode ที่เซนเซอร์กลับไป power-down หลังวัดเสร็จ |
| กระแสที่ใช้ต่างกันน้อยมาก | 120 µA เทียบกับ ~0 µA — ไม่คุ้มกับความซับซ้อนที่เพิ่มขึ้น |

> **High Res Mode 2 (`0x11`) มีประโยชน์เฉพาะกรณีวัดแสงสลัวมาก** (< 10 lx) เช่นตรวจว่าไฟในห้องปิดหรือยัง
> ถ้าโปรเจกต์ต้องการแยกแยะระดับแสงกลางคืนละเอียด ๆ ค่อยพิจารณาสลับโหมด

### การอ่านค่า

เซนเซอร์คืน **2 ไบต์ big-endian** แปลงด้วย:

```
lux = ค่าดิบ / 1.2
```

ตัวหาร 1.2 คือค่าคงที่จาก datasheet (measurement accuracy typ.) **ไม่ใช่ค่าที่ตั้งเอง**
สำหรับ High Res Mode 2 ต้องหารเพิ่มอีก 2 (รวมเป็น `/2.4`)

**ลำดับที่ถูกต้อง:**

```
1. เขียน 0x01 (Power On)
2. เขียน 0x10 (Continuous High Res Mode)
3. รอ ≥ 180 ms  ← เผื่อจากเวลาวัด 120 ms
4. วนลูป: อ่าน 2 ไบต์ → หาร 1.2 → ได้ lux
```

---

## 5. ไลบรารี Python

```bash
pip install smbus2
```

โปรโตคอลง่ายมาก (เขียนคำสั่ง 1 ไบต์ · อ่าน 2 ไบต์) **ไม่ต้องใช้ไลบรารีเฉพาะทาง**
เขียนเองด้วย `smbus2` ราว 20 บรรทัดก็ครบ และควบคุมโหมดกับ timing ได้ชัดเจนกว่า

ถ้าต้องการไลบรารีสำเร็จรูป: `pip install adafruit-circuitpython-bh1750`

---

## 6. การ calibrate

BH1750 ปรับเทียบมาจากโรงงานแล้ว **สิ่งที่ต้อง calibrate คือการชดเชยฝาครอบ ไม่ใช่ตัวเซนเซอร์**

### ปัจจัยการส่งผ่านแสงของฝาครอบ (transmission factor)

ถ้าติดตั้งหลังกระจก อะคริลิก หรือฝาครอบใด ๆ แสงจะถูกลดทอนลง:

| วัสดุ | การส่งผ่านโดยประมาณ |
|---|---|
| ไม่มีฝาครอบ | 1.00 |
| อะคริลิกใส 2–3 mm | 0.90 – 0.92 |
| กระจกใส | 0.88 – 0.92 |
| อะคริลิกฝ้า | 0.40 – 0.70 |
| ฟิล์มกรองแสง | 0.20 – 0.50 |

**วิธีหาค่าจริง:**

```
1. วัด lux โดยไม่มีฝาครอบ ในแสงคงที่          → L_open
2. ใส่ฝาครอบ วัดซ้ำในแสงเดิม                  → L_covered
3. transmission = L_covered / L_open
4. lux ที่ถูกต้อง = ค่าที่อ่านได้ / transmission
```

**หรือถ้ามีเครื่องวัดแสงอ้างอิง** (หรือแอปวัดแสงบนมือถือที่แม่นพอสมควร):

```
factor = lux อ้างอิง / lux ที่ BH1750 อ่านได้
```

> ค่า `transmission` หรือ `factor` นี้ **ต้องอยู่ในไฟล์ config** ไม่ใช่คูณตรง ๆ ในโค้ด
> เช่น `BH1750_TRANSMISSION_FACTOR=0.91`

### สิ่งที่ต้องระวังตอนวัด

- อย่าให้เงาของสาย ฝาครอบ หรือชิ้นส่วนอื่นทับหน้าเซนเซอร์
- อย่าวางหันหน้าเข้าหาหลอดไฟโดยตรง — จะได้ค่าที่ไม่ได้สะท้อนแสงในห้องจริง
- ถ้าใช้หลอด LED ที่มี PWM dimming ค่าอาจกระพริบ → ใช้ค่าเฉลี่ยเคลื่อนที่ 3–5 ตัวอย่าง

---

## 7. เกณฑ์ค่าความสว่างที่แนะนำ

อ้างอิงแนวทางความสว่างสำหรับพื้นที่ทำงาน (มาตรฐานสากลด้านการส่องสว่างในสำนักงานอยู่ที่ 300–500 lx)

| ระดับ | lux | สภาพ | เหมาะกับ |
|---|---|---|---|
| มืด | < 50 | มืดมาก | นอนหลับ |
| สลัว | 50–150 | ไฟห้องนอนตอนกลางคืน | พักผ่อน · ดูหนัง |
| **พอดี** | **300–500** | **ไฟห้องทำงาน/ห้องเรียน** | **อ่านหนังสือ · ทำงาน** ✅ |
| สว่าง | 500–1,000 | ห้องที่แสงธรรมชาติเข้าเยอะ | งานที่ต้องการรายละเอียด |
| สว่างมาก | > 1,000 | ใกล้หน้าต่างตอนกลางวัน | อาจแสบตาถ้าจ้องจอ |

**ค่าอ้างอิงเพิ่มเติม:** แสงเทียน ~10 lx · ห้องนั่งเล่นตอนกลางคืน ~150 lx ·
วันมีเมฆกลางแจ้ง ~1,000–10,000 lx · แดดจัดกลางแจ้ง ~100,000 lx (**เกินช่วงวัดของ BH1750**)

> 💡 **เชื่อมโยงกับ Focus feature:** แสงต่ำกว่า 300 lx สัมพันธ์กับความล้าของสายตาและความง่วง
> ซึ่งเป็นสิ่งที่ EAR detection จากกล้องวัดอยู่แล้ว
> การมีทั้งสองค่าทำให้แดชบอร์ดบอกได้ว่า "ง่วงเพราะแสงน้อย" ไม่ใช่แค่ "ง่วง"

---

## 8. การแก้ปัญหา

| อาการ | สาเหตุที่น่าจะเป็น | วิธีแก้ |
|---|---|---|
| `i2cdetect` ไม่เจอ `0x23` | ไฟไม่ถึง · ADDR ถูกดึง HIGH โดยไม่ตั้งใจ | ลองสแกนหา `0x5C` ด้วย · วัดแรงดัน VCC |
| อ่านได้ `0` ตลอด | ยังไม่ได้ส่งคำสั่ง Power On + เลือกโหมด | ส่ง `0x01` แล้วตามด้วย `0x10` |
| อ่านได้ `65535` ตลอด | ค่าล้นช่วงวัด (แสงจ้าเกิน) | ย้ายออกจากแสงแดดตรง |
| ค่าเปลี่ยนกระตุกตลอดเวลา | หลอด LED มี PWM dimming | ใช้ค่าเฉลี่ยเคลื่อนที่ 3–5 ตัวอย่าง |
| ค่าต่ำกว่าที่ควรเป็นเสมอ | ฝาครอบลดทอนแสง · หน้าเซนเซอร์สกปรก | ตั้ง transmission factor · เช็ดหน้าเซนเซอร์ |
| ค่าอ่านได้ช้า/ค้าง | อ่านถี่กว่าเวลาวัด 120 ms | เว้นช่วงอย่างน้อย 180 ms ระหว่างการอ่าน |

---

[← กลับสารบัญ](../README.md)
