Randomperson123324/enviroment-monitor/docs/devices/budget.md

# งบประมาณ

> **สำคัญ: ตัวเลขในหน้านี้ใช้อ้างอิงเพื่อวางแผนเท่านั้น ไม่ใช่ใบเสนอราคา**
> ราคาชิ้นส่วนอิเล็กทรอนิกส์เปลี่ยนบ่อยมาก **ต้องเช็คราคาจริงก่อนสั่งซื้อทุกครั้ง**
> ราคาที่ทำเครื่องหมาย **[ยืนยันแล้ว]** ตรวจสอบจากหน้าเว็บร้านเมื่อ 31 กรกฎาคม 2569
> ที่เหลือเป็น **[ประมาณการ]** จากช่วงราคาตลาดทั่วไป — อาจคลาดเคลื่อนได้มาก

---

## 1. ขอบเขตของงบนี้

**ชุด Raspberry Pi 5 มีอยู่แล้ว — ไม่นับรวมในงบ**

| มีอยู่แล้ว (ไม่ต้องซื้อ) | มูลค่าโดยประมาณ |
|---|---|
| Raspberry Pi 5 Model B · PSU 27W · Active Cooler · microSD · เคส | ~6,200–7,000 บาท |

งบในหน้านี้จึงครอบคลุมเฉพาะ **เซนเซอร์ · กล้อง · อุปกรณ์ประกอบ** ที่ยังต้องซื้อเพิ่ม

> 📝 มูลค่าชุดที่มีอยู่แล้วยังมีประโยชน์ตอนทำรายงานโครงงาน — ใช้ระบุ "มูลค่ารวมของระบบ"
> ได้ที่ราว **9,600–12,500 บาท** แม้จ่ายจริงน้อยกว่านั้นมาก

### ⚠️ ปัจจัยที่ทำให้ราคาแกว่งมากที่สุด

**ของแท้เทียบกับโมดูลจีน** — SCD40 และ SGP30 ต่างกันได้เกินเท่าตัว

| | โมดูลจีน (AliExpress/Shopee) | ของแท้ (Adafruit / Sparkfun / Seeed) |
|---|---|---|
| ราคา | ปลายล่างของช่วงในตาราง | ปลายบนของช่วง |
| ความเสี่ยง | ⚠️ **SGP30 บางล็อตไม่มี LDO** ต่อ 3.3V แล้วชิปพังทันที | มีวงจรครบตามที่ระบุ |
| เอกสาร | มักไม่มี · schematic ไม่เปิด | มี schematic + ไลบรารีที่ดูแลต่อเนื่อง |
| คุ้มไหม | คุ้มสำหรับ BH1750 (วงจรง่าย) | **คุ้มสำหรับ SGP30** เพราะพังแล้วกู้ไม่ได้ |

**ข้อสรุป:** ประหยัดได้กับ BH1750 และ PMS7003 · **อย่าเสี่ยงกับ SGP30**
ถ้าจะซื้อโมดูลจีน ต้องวัดแรงดันที่ขา VDD ของชิปให้ได้ ~1.8V ก่อนเสียบใช้จริง

---

## 2. รายการที่ต้องซื้อ

### 2.1 เซนเซอร์

| รายการ | จำเป็น | ราคา (บาท) | สถานะราคา | หมายเหตุ |
|---|---|---|---|---|
| PMS7003 (PM1.0/2.5/10) | ✅ | **706** | **[ยืนยันแล้ว]** ArtronShop | ราคารวม VAT · ควรได้ adapter board มาด้วย |
| SCD40 breakout (CO₂/T/RH) | ✅ | ~700–1,300 | [ประมาณการ] | แทน DHT22 ทั้งหมด — วัดได้ 3 ค่าในตัวเดียว |
| SGP30 breakout (TVOC/eCO₂) | ✅ | ~350–650 | [ประมาณการ] | **ต้องเป็น breakout ที่มี LDO** ไม่ใช่ชิปเปล่า |
| BH1750 GY-302 (lux) | ✅ | **74** | **[ยืนยันแล้ว]** ArtronShop | ถูกที่สุดในชุด |
| ไมโครโฟน USB (mini, UAC) | ✅ | ~150–400 | [ประมาณการ] | ต้องปิด AGC ได้ · แบบเสียบตรงเพียงพอ |
| **รวมหมวดนี้** | | **~1,980–3,130** | | |

### 2.2 กล้อง (Focus feature)

| รายการ | ราคา (บาท) | สถานะราคา | หมายเหตุ |
|---|---|---|---|
| **Camera Module 3 (Standard)** ← แนะนำ | ~1,000–1,500 | [ประมาณการ] | **ไม่กินโควตากระแส USB** |
| สายแปลง CSI 15→22 ขา | ~100–250 | [ประมาณการ] | **Pi 5 ใช้ขั้ว 22 ขา — สายที่แถมมากับกล้องเป็น 15 ขา** |
| *ทางเลือก:* Logitech C270 (USB, 720p) | ~700–900 | [ประมาณการ] | ถูกกว่า แต่กินโควตา USB และทำให้เลข ALSA ของไมค์เปลี่ยน |
| *ทางเลือก:* Logitech C920 (USB, 1080p) | ~2,000–2,800 | [ประมาณการ] | เกินความจำเป็นสำหรับงานนี้ |
| **รวมหมวดนี้ (Camera Module 3)** | **~1,100–1,750** | | |

> ⚠️ **อย่าลืมสายแปลง 15→22 ขา** — เป็นของที่คนลืมสั่งบ่อยที่สุด
> กล้องมาถึงแล้วเสียบกับ Pi 5 ไม่ได้ ต้องรออีกรอบ

### 2.3 อุปกรณ์ประกอบ

| รายการ | ราคา (บาท) | หมายเหตุ |
|---|---|---|
| สายจัมเปอร์ female-female | ~60–120 | สำหรับ I2C และ UART |
| ตัวเก็บประจุ 100 nF × 5 · 100 µF × 1 · 220 µF × 1 | ~50–100 | **จำเป็น** ไม่ใช่ของเสริม — SCD40 กระชากถึง 205 mA เป็นพัลส์ |
| แผ่นปริ้นอเนกประสงค์ / เบรดบอร์ด | ~60–150 | |
| สาย I2C ยาว (สำหรับย้าย SCD40 ออกห่าง Pi) | ~50–150 | ทำให้ temperature offset เหลือ 1–3 °C แทน 6–10 °C |
| น็อต/standoff | ~50–100 | **ห้ามใช้กาวซิลิโคน** ใกล้ SGP30 — ทำให้เซนเซอร์เสื่อมถาวร |
| **รวมหมวดนี้** | **~270–620** | |

---

## 3. สรุปงบตามชุดที่เลือก

| ชุด | องค์ประกอบ | ช่วงราคา (บาท) |
|---|---|---|
| **A — ประหยัด** | เซนเซอร์โมดูลจีน · USB webcam C270 แทน CSI | **~2,950–4,650** |
| **B — แนะนำ** | เซนเซอร์ · **Camera Module 3** + สายแปลง | **~3,350–5,500** |
| **+ อัปเกรดภายหลัง** | NVMe SSD 256GB + M.2 HAT | +1,300–2,100 |

**ทำไมชุด B ถึงแนะนำ:** ต่างจากชุด A แค่ราว 400–850 บาท แต่ได้กล้อง CSI ที่**ไม่กินโควตากระแส USB**
Pi 5 จำกัดพอร์ต USB ทั้งสี่รวมกันไว้ที่ 1.6 A (เมื่อใช้ PSU 5A) — เมื่อมีไมค์ USB อยู่แล้ว
การเพิ่ม USB webcam เข้าไปทำให้เบียดโควตาและอาจหลุดเป็นระยะ

**NVMe คุ้มเมื่อไหร่:** ถ้าจะรันต่อเนื่อง 24/7 เป็นปี ๆ — microSD จะเสื่อมจากการเขียนซ้ำ
(baseline ของ SGP30 เขียนทุกชั่วโมง + log ระบบ) ถ้าเป็นโปรเจกต์ระยะสั้น **ไม่จำเป็น**

---

## 4. สิ่งที่ตัดออกไปแล้วและประหยัดได้

| รายการที่ตัด | ประหยัด (บาท) | เหตุผล |
|---|---|---|
| MQ-2 | ~80–150 | PMS7003 + SGP30 ครอบคลุมกว่าและแม่นกว่า |
| ADS1115 | ~150–350 | ไม่ต้องใช้แล้วเมื่อไม่มีเซนเซอร์ analog |
| ตัวต้านทาน 1% สำหรับ voltage divider | ~20–50 | ไม่ต้องใช้แล้ว |
| DHT22 | ~150–250 | SCD40 วัดอุณหภูมิและความชื้นได้แม่นกว่า |
| **รวมที่ประหยัดได้** | **~400–800** | และลดกระแสราง 5V ลง 150 mA · ลดความร้อนในกล่อง |

---

## 5. ค่าใช้จ่ายต่อเนื่อง

| รายการ | ค่าใช้จ่าย | หมายเหตุ |
|---|---|---|
| **ค่าไฟ** | ~26 บาท/เดือน | ที่ ~9 W ต่อเนื่อง 24/7 · คิดที่ ~4 บาท/kWh |
| Supabase | 0 บาท | Free tier เพียงพอสำหรับข้อมูลทุก 5 วินาที จาก 1 อุปกรณ์ |
| Vercel | 0 บาท | Hobby plan |
| Gemini API | 0 บาท | Free tier มีโควตาจำกัดต่อวัน — พอสำหรับใช้ส่วนตัว |
| **เปลี่ยน PMS7003** | ~706 บาท / 3 ปี | MTTF ตาม datasheet คือ ≥3 ปี |
| **เปลี่ยน microSD** | ~300 บาท / 1–2 ปี | ถ้าไม่ได้บูตจาก NVMe |

**คำนวณค่าไฟ:** 9 W × 24 ชม. × 30 วัน = 6.48 kWh/เดือน → ที่ 4 บาท/kWh ≈ **26 บาท/เดือน**
(ค่าไฟจริงขึ้นกับอัตราก้าวหน้าของการไฟฟ้าและปริมาณใช้รวมของบ้าน — ตัวเลขนี้เป็นการประมาณคร่าว ๆ)

---

## 6. ร้านค้าที่ตรวจสอบราคา

| ร้าน | เว็บไซต์ | หมายเหตุ |
|---|---|---|
| ArtronShop | artronshop.co.th | ราคาที่แสดงรวม VAT แล้ว · มีสินค้าที่ยืนยันราคาในหน้านี้ 2 รายการ |
| Arduitronics | arduitronics.com | |
| ThaiEasyElec | thaieasyelec.com | |
| Cytron Thailand | th.cytron.io | |
| Global Byte | globalbyteshop.com | |

> 💡 **เทียบราคาก่อนซื้อ:** BigGo (biggo.co.th) และ Priceza (priceza.com) รวบรวมราคาจากหลายร้าน
> · โมดูล SCD40/SGP30 ถูกกว่ามากบน Lazada/Shopee แต่ต้องยอมรับความเสี่ยงเรื่องคุณภาพ
> ตามที่อธิบายในหัวข้อ 1

---

## 7. ลำดับการซื้อที่แนะนำ

ไม่ต้องซื้อทุกอย่างพร้อมกัน — ระบบออกแบบให้เพิ่มเซนเซอร์ทีละตัวได้
โค้ดฝั่ง Pi เพิ่มเซนเซอร์ = สร้างไฟล์ใหม่ใน `sensors/` แล้วลงทะเบียนใน config ไม่ต้องรื้อของเดิม

| ลำดับ | ซื้ออะไร | ทำอะไรได้ | งบก้อนนี้ |
|---|---|---|---|
| **1** | SCD40 + BH1750 + สายจัมเปอร์ + คาปาซิเตอร์ | ได้ CO₂ · อุณหภูมิ · ความชื้น · แสง — **ครบพอให้แดชบอร์ดมีความหมายแล้ว** | ~880–1,600 |
| **2** | PMS7003 | เพิ่ม PM1.0/2.5/10 — สำคัญมากในไทยช่วงฤดูฝุ่น | ~706 |
| **3** | กล้อง + สายแปลง 15→22 ขา | เปิดใช้ Focus feature (ตรวจจับใบหน้า/สมาธิ) | ~1,100–1,750 |
| **4** | SGP30 + ไมโครโฟน USB | เพิ่ม TVOC และระดับเสียง | ~500–1,050 |

> **เริ่มจากขั้นที่ 1 ก่อน** ด้วยงบไม่ถึง 1,600 บาท ก็ได้ระบบที่ใช้งานได้จริงแล้ว
> เพราะ SCD40 ตัวเดียวให้ทั้ง CO₂ อุณหภูมิ และความชื้น ซึ่งเป็นสามค่าหลักของแดชบอร์ด
>
> ขั้นที่ 1 + 2 รวม **~1,590–2,300 บาท** ได้ครบทุกค่าด้านคุณภาพอากาศ
