Randomperson123324/enviroment-monitor/docs/devices/camera.md

# กล้อง — สำหรับ Focus feature (face / EAR / motion)

[← กลับสารบัญ](../README.md)

> **บทบาทในระบบนี้:** ป้อนข้อมูลให้ `webcam_json` ในตาราง `environment` และแท็บ Focus บนแดชบอร์ด
> โดยตรวจจับใบหน้า, คำนวณ Eye Aspect Ratio (EAR) เพื่อดูความง่วง, และนับการขยับตัว
> เกณฑ์ที่ใช้อยู่แล้วในโปรเจกต์: `WEBCAM.drowsyEarBelow = 0.18` และ `blinkNormal = [8, 21]` ครั้ง/นาที
> (ดู `config/sensors.js`)

---

## 1. สรุปคำแนะนำ

| อันดับ | ตัวเลือก | ราคาโดยประมาณ | เหมาะกับ |
|---|---|---|---|
| 🥇 | **Raspberry Pi Camera Module 3 (Standard)** | ~1,000–1,300 บาท | ✅ **ตัวเลือกที่ดีที่สุดสำหรับโปรเจกต์นี้** |
| 🥈 | Raspberry Pi Camera Module 3 **Wide** | ~1,200–1,500 บาท | ถ้ากล้องต้องอยู่ใกล้หน้า (< 40 cm) |
| 🥉 | Logitech C270 (USB, 720p) | ~700–900 บาท | ถ้าต้องการวางกล้องห่างจาก Pi มาก |
| — | Logitech C920 (USB, 1080p) | ~2,000–2,800 บาท | เกินความจำเป็นสำหรับงานนี้ |
| ⚠️ | Camera Module 3 **NoIR** | ~1,000–1,300 บาท | เฉพาะกรณีต้องทำงานในความมืดสนิท (ต้องมีไฟ IR เพิ่ม) |

---

## 2. ทำไม Camera Module 3 ถึงเหมาะกว่า USB webcam

| ประเด็น | Camera Module 3 (CSI-2) | USB webcam |
|---|---|---|
| **โควตากระแส USB** | ✅ **ไม่กินเลย** — ใช้ขั้วต่อ CSI แยก | ❌ กิน 150–400 mA จากเพดาน 600 mA / 1.6 A |
| ความเข้ากันได้กับไมค์ USB | ✅ ไม่แย่งอะไรกัน | ⚠️ มีการ์ดเสียงในตัว ทำให้เลข ALSA card ของไมค์เปลี่ยน |
| Autofocus | ✅ Phase Detection AF (เร็ว) | C270 ไม่มี · C920 มี AF แบบ contrast (ช้ากว่า) |
| ประสิทธิภาพในแสงน้อย | ✅ ดี — พิกเซล 1.4 µm · F1.8 · back-illuminated | ปานกลาง |
| การควบคุมจากซอฟต์แวร์ | ✅ `libcamera` / `picamera2` ควบคุม exposure/AF ได้ละเอียด | จำกัดตามที่ V4L2 เปิดให้ |
| ภาระ CPU | ✅ ต่ำกว่า — ISP ในตัว Pi 5 ช่วยประมวลผล | ต้อง decode MJPEG ด้วย CPU |
| ความยาวสายที่ทำได้ | สาย FPC 200 mm (ต่อยาวได้แต่มีข้อจำกัด) | สาย USB ยาวได้ 3–5 m |
| ราคา | ปานกลาง | C270 ถูกกว่า |

> 🔑 **เหตุผลชี้ขาดคือโควตา USB** — โปรเจกต์นี้มีไมค์ USB อยู่แล้ว
> ถ้าเพิ่ม USB webcam 1080p เข้าไปด้วย จะใช้ไปราว 500 mA ซึ่งเกินเพดาน 600 mA
> ของ PSU ที่ไม่ใช่ 5A ทำให้ภาพกระตุกหรืออุปกรณ์หลุด
> การใช้ CSI camera ทำให้ปัญหานี้หายไปทั้งหมด

---

## 3. สเปก Raspberry Pi Camera Module 3

จาก [product brief ทางการ (มิถุนายน 2024)](https://datasheets.raspberrypi.com/camera/camera-module-3-product-brief.pdf)

| รายการ | ค่า |
|---|---|
| เซนเซอร์ | Sony IMX708 (back-illuminated, stacked CMOS) |
| ความละเอียด | 11.9 ล้านพิกเซล (4608 × 2592) |
| ขนาดพิกเซล | 1.4 × 1.4 µm |
| ขนาดเซนเซอร์ | เส้นทแยงมุม 7.4 mm |
| โหมดวิดีโอที่ใช้บ่อย | 1080p50 · 720p100 · 480p120 |
| ระบบโฟกัส | **Phase Detection Autofocus (PDAF)** |
| HDR | รองรับ (สูงสุด 3 ล้านพิกเซล) |
| อินเทอร์เฟซ | CSI-2 (Pi 5 ใช้ขั้วต่อ 22 ขา) |
| ความยาวสายริบบอน | 200 mm |
| อุณหภูมิใช้งาน | 0 – 50 °C |
| ผลิตถึงอย่างน้อย | มกราคม 2030 |

### เปรียบเทียบรุ่นย่อย

| | Standard | Wide | NoIR | Wide NoIR |
|---|---|---|---|---|
| ระยะโฟกัส | 10 cm – ∞ | **5 cm – ∞** | 10 cm – ∞ | 5 cm – ∞ |
| ความยาวโฟกัส | 4.74 mm | 2.75 mm | 4.74 mm | 2.75 mm |
| มุมรับภาพ (แนวนอน) | **66°** | **102°** | 66° | 102° |
| มุมรับภาพ (แนวทแยง) | 75° | 120° | 75° | 120° |
| รูรับแสง | **F1.8** | F2.2 | F1.8 | F2.2 |
| ฟิลเตอร์ตัด IR | ✅ มี | ✅ มี | ❌ ไม่มี | ❌ ไม่มี |
| ขนาด | 25 × 24 × 11.5 mm | 25 × 24 × 12.4 mm | เท่ากัน | เท่ากัน |

### เลือกรุ่นไหนดี

| ระยะจากกล้องถึงใบหน้า | รุ่นที่แนะนำ | เหตุผล |
|---|---|---|
| 50 cm – 1.5 m (บนโต๊ะทำงานทั่วไป) | **Standard** ✅ | มุม 66° ครอบคลุมพอ · F1.8 รับแสงได้ดีกว่า |
| 30 – 50 cm (ติดขอบจอ) | **Wide** | มุม 102° เก็บใบหน้าได้ครบแม้อยู่ใกล้ |
| ต้องทำงานในห้องมืดสนิท | NoIR + ไฟ IR 850nm | ⚠️ ดูข้อควรระวังด้านล่าง |

> ⚠️ **NoIR ไม่ใช่ "กล้องมองกลางคืน" ในตัวเอง** — มันแค่ไม่มีฟิลเตอร์ตัด IR
> จึงต้องมี**ไฟ IR ส่องเพิ่ม**ถึงจะเห็นภาพในความมืด และเมื่อใช้ในเวลากลางวันสีจะเพี้ยน
> สำหรับโปรเจกต์นี้ที่วัด **แสง (BH1750) ควบคู่ไปด้วย** การใช้ NoIR จะทำให้ตีความยากขึ้น
> **แนะนำ Standard** แล้วให้ระบบรายงานว่า "แสงน้อยเกินไปสำหรับการตรวจจับ" แทน

---

## 4. การติดตั้ง Camera Module 3

### การต่อสาย

Raspberry Pi 5 ใช้ขั้วต่อ **CSI 22 ขา** (เล็กกว่า Pi รุ่นก่อนที่ใช้ 15 ขา)
Camera Module 3 มาพร้อมสาย 15 ขา → **ต้องซื้อสายแปลง 15-to-22 pin เพิ่ม**
(Pi 5 บางชุดแถมมาให้แล้ว — ตรวจในกล่องก่อนสั่งซื้อ)

Pi 5 มีขั้วต่อ CSI/DSI สองช่อง (`CAM/DISP 0` และ `CAM/DISP 1`) ใช้ช่องไหนก็ได้

```
⚠️ ปิดเครื่องและถอดสายไฟก่อนเสียบสายกล้องทุกครั้ง
   ดึงตัวล็อกขึ้น → เสียบสายให้หน้าสัมผัสโลหะหันถูกด้าน → กดตัวล็อกลง
```

### ตรวจสอบ

```bash
rpicam-hello --list-cameras          # ต้องเห็น imx708
rpicam-hello -t 5000                 # แสดงภาพพรีวิว 5 วินาที
```

> Pi 5 กับ Raspberry Pi OS Bookworm ขึ้นไป **ตรวจจับกล้องอัตโนมัติ**
> ไม่ต้องใส่ `dtoverlay` หรือเปิดอะไรใน `raspi-config` เหมือนรุ่นเก่า

---

## 5. ซอฟต์แวร์

### ไลบรารีที่แนะนำ

```bash
sudo apt install -y python3-picamera2      # ✅ ทางการ · มากับ Raspberry Pi OS อยู่แล้ว
pip install opencv-python mediapipe        # ประมวลผลภาพ
```

| ไลบรารี | ใช้ทำอะไร |
|---|---|
| **picamera2** | เข้าถึงกล้อง CSI · ควบคุม AF/exposure · ดึงเฟรมเป็น numpy array |
| **OpenCV** | แปลงสี · ปรับขนาด · วาดผลลัพธ์ |
| **MediaPipe Face Mesh** | หา landmark 468 จุดบนใบหน้า → คำนวณ EAR |

> ถ้าใช้ USB webcam แทน ให้ใช้ `cv2.VideoCapture()` ธรรมดา — โค้ดส่วนประมวลผลเหมือนกันทั้งหมด
> **ออกแบบให้สลับแหล่งภาพได้ผ่าน config** (`CAMERA_SOURCE=csi` หรือ `usb`) จะดีที่สุด

### การคำนวณ EAR (Eye Aspect Ratio)

```
        p2      p3
         •      •
    p1 •          • p4          EAR = (|p2−p6| + |p3−p5|) / (2 × |p1−p4|)
         •      •
        p6      p5
```

- ตาเปิดปกติ: EAR ≈ 0.25 – 0.35
- **ตาปิด/ง่วง: EAR < 0.18** ← ตรงกับ `WEBCAM.drowsyEarBelow` ใน `config/sensors.js`
- นับการกะพริบ: EAR ตกลงต่ำกว่าเกณฑ์แล้วกลับขึ้นภายใน ~100–400 ms
- อัตราการกะพริบปกติ: **8–21 ครั้ง/นาที** ← ตรงกับ `WEBCAM.blinkNormal`

> ค่าเกณฑ์เหล่านี้**มีอยู่ใน `config/sensors.js` แล้ว** — โค้ดฝั่ง Pi ต้องอ่านค่าจาก config ของตัวเอง
> ที่ตั้งให้ตรงกัน **ห้ามเขียนตัวเลข 0.18 ซ้ำในโค้ด**

### การตั้งค่าที่แนะนำ

| พารามิเตอร์ | ค่าที่แนะนำ | เหตุผล |
|---|---|---|
| ความละเอียดที่ประมวลผล | **640 × 480** | MediaPipe ไม่ต้องการภาพใหญ่ · ประหยัด CPU มาก |
| เฟรมเรต | **10 – 15 fps** | เพียงพอสำหรับนับการกะพริบ (การกะพริบกินเวลา ~100–400 ms) |
| Autofocus | `Continuous` หรือ ล็อกไว้ที่ระยะโต๊ะทำงาน | ถ้าคนนั่งอยู่กับที่ ล็อกไว้จะนิ่งกว่าและประหยัด CPU |
| รอบส่งสรุปขึ้น API | ทุก 5 วินาที (พร้อมข้อมูลเซนเซอร์อื่น) | ไม่ต้องส่งทุกเฟรม — สรุปเป็นค่าเฉลี่ยในหน้าต่างนั้น |

> ⚠️ **อย่าประมวลผลที่ 1080p 30fps** — จะกิน CPU ของ Pi 5 เกือบเต็ม ทำให้ thread ของ SGP30
> พลาดจังหวะ 1 Hz และค่า TVOC เพี้ยน (ดู [sgp30.md § 5](sgp30.md#5--ข้อบังคับ-ต้องอ่านทุก-1-วินาทีเป๊ะ-ๆ))

---

## 6. 🔒 ความเป็นส่วนตัว — สำคัญมาก

โปรเจกต์นี้ติดกล้องในพื้นที่ส่วนตัว จึงต้องออกแบบให้ปลอดภัยตั้งแต่แรก

| หลักการ | ปฏิบัติอย่างไร |
|---|---|
| **ห้ามส่งภาพออกนอกเครื่อง** | ประมวลผลบน Pi ทั้งหมด · ส่งขึ้น API เฉพาะ**ตัวเลขสรุป** (EAR, จำนวนกะพริบ, มี/ไม่มีคน) |
| **ห้ามบันทึกภาพลงดิสก์** | ไม่เขียนไฟล์ภาพหรือวิดีโอเลย นอกจากตอน debug ที่เปิดด้วย flag ชัดเจน |
| **ห้ามเก็บ face embedding** | ใช้ landmark เพื่อคำนวณ EAR แล้วทิ้งทันที ไม่เก็บข้อมูลที่ระบุตัวตนได้ |
| **มีสวิตช์ปิดกล้อง** | ให้ปิดกล้องได้จาก config หรือสวิตช์จริง โดยระบบส่วนอื่นยังทำงานต่อ |
| **มีไฟแสดงสถานะ** | LED ที่บอกชัดเจนว่ากล้องกำลังทำงาน |
| **แจ้งทุกคนในพื้นที่** | บอกให้ทุกคนที่เข้ามาในห้องทราบว่ามีกล้อง |

> ⚖️ **ถ้าติดตั้งในพื้นที่ที่มีคนอื่นนอกจากตัวเอง** (ห้องเรียน · ออฟฟิศ · พื้นที่ส่วนกลาง)
> ควรขอความยินยอมจากทุกคนก่อน — และในหลายบริบทถือเป็นข้อกำหนดทางกฎหมาย
> ไม่ใช่แค่มารยาท ประเทศไทยมี พ.ร.บ. คุ้มครองข้อมูลส่วนบุคคล (PDPA) ที่ครอบคลุมข้อมูลชีวมิติ
> **หากเป็นโครงการที่ใช้จริงกับผู้อื่น ควรปรึกษาผู้รู้ด้านกฎหมายก่อน** — เอกสารนี้ไม่ใช่คำแนะนำทางกฎหมาย

---

## 7. ผลกระทบต่องบไฟและ CPU

| | Camera Module 3 | USB webcam 1080p |
|---|---|---|
| กระแส | ~250 mA @3.3V (จากบอร์ด ไม่ใช่โควตา USB) | 250–400 mA จากโควตา USB |
| CPU ตอนประมวลผล 640×480 @15fps | ~25–35% ของหนึ่งคอร์ | ~35–45% (ต้อง decode MJPEG เพิ่ม) |
| กำลังไฟรวมที่เพิ่ม | ~2 W | ~2.5 W |

ทั้งสองแบบอยู่ในงบของ PSU 27W → ดู [03-power-budget.md](../03-power-budget.md)

---

## 8. การแก้ปัญหา

| อาการ | สาเหตุที่น่าจะเป็น | วิธีแก้ |
|---|---|---|
| `--list-cameras` ไม่เจอกล้อง | สายเสียบกลับด้าน · ใช้สาย 15 ขากับ Pi 5 โดยไม่มีตัวแปลง | ตรวจทิศหน้าสัมผัส · ใช้สายแปลง 15→22 ขา |
| ภาพเบลอตลอด | AF ล็อกไว้ผิดระยะ | ตั้งเป็น continuous AF หรือล็อกใหม่ที่ระยะโต๊ะ |
| ตรวจจับใบหน้าไม่เจอในที่แสงน้อย | แสงต่ำกว่า ~100 lx | ใช้ค่าจาก BH1750 เตือนผู้ใช้ให้เปิดไฟ |
| เฟรมเรตตก / ระบบหน่วง | ประมวลผลความละเอียดสูงเกินไป | ลดเป็น 640×480 · ลดเป็น 10 fps |
| ค่า TVOC เริ่มเพี้ยนหลังเปิดกล้อง | CPU เต็มจน thread SGP30 พลาดจังหวะ 1 Hz | ลดภาระกล้อง · เพิ่ม priority ให้ thread SGP30 |
| USB webcam ทำให้ไมค์หาย | เลข ALSA card เปลี่ยน | ตั้ง udev rule ([microphone-usb.md § 3](microphone-usb.md#-ทำให้ชื่ออุปกรณ์คงที่)) |
| USB webcam หลุดเป็นระยะ | เกินโควตากระแส USB | ใช้ PSU 5A · หรือเปลี่ยนไปใช้ CSI camera |
| กล้องร้อนจนภาพมี noise | อยู่ในกล่องปิดใกล้ Pi | ระบายอากาศ · ย้ายออกห่างจากบอร์ด |

---

[← กลับสารบัญ](../README.md)
