Randomperson123324/enviroment-monitor/docs/devices/microphone-usb.md

# ไมโครโฟน USB — วัดระดับเสียง (dBA)

[← กลับสารบัญ](../README.md)

> **ยืนยันแล้ว: ใช้ไมค์ USB ร่วมกับ BH1750 ได้ ไม่มีปัญหาใด ๆ**
> ทั้งสองใช้บัสคนละเส้นโดยสิ้นเชิง — ไมค์อยู่บน USB, BH1750 อยู่บน I2C
> ไม่แย่งขา GPIO ไม่แย่งที่อยู่ I2C และไม่แย่ง bandwidth กัน

---

## 1. ทำไมเลือก USB แทน I2S หรือ analog

| ทางเลือก | ข้อดี | ข้อเสีย | สรุป |
|---|---|---|---|
| **USB (UAC)** | เสียบใช้ได้ทันที · ไม่กิน GPIO · ALSA รองรับในตัว · หาซื้อง่าย | กินโควตากระแส USB · latency สูงกว่าเล็กน้อย (ไม่สำคัญกับงานนี้) | ✅ **เลือกตัวนี้** |
| I2S (เช่น INMP441) | คุณภาพดี · กินไฟน้อย · ไม่กินโควตา USB | ต้องใช้ GPIO 3 ขา · ต้องตั้ง device tree overlay · ต่อสายยุ่งกว่า | ทางเลือกสำรอง |
| Analog (เช่น MAX9814) | ถูกที่สุด | **Pi 5 ไม่มี ADC** ต้องเพิ่ม ADS1115 · ADS1115 เร็วสุด 860 SPS ซึ่ง**ช้าเกินไปสำหรับเสียง** | ❌ ไม่แนะนำ |

> **เหตุผลหลักที่ตัด analog ออก:** การวัด dB ที่ถูกต้องต้องสุ่มสัญญาณเสียงที่ ≥8 kHz
> ADS1115 ทำได้แค่ 860 ตัวอย่างต่อวินาที ซึ่งวัดได้แค่ "แรงดันเฉลี่ยของ envelope" ไม่ใช่ระดับเสียงจริง
> ผลคือค่าที่ได้จะบอกได้แค่ "ดัง/เบา" คร่าว ๆ ไม่ใช่ dBA ที่มีความหมาย

---

## 2. การเลือกไมโครโฟน

**ข้อกำหนดขั้นต่ำ:**

| รายการ | ค่าที่ต้องการ |
|---|---|
| มาตรฐาน | **USB Audio Class 1.0 หรือ 2.0 (UAC)** — ต้องไม่ต้องลงไดรเวอร์ |
| Sample rate | รองรับ 44.1 kHz หรือ 48 kHz |
| ความละเอียด | 16 บิตขึ้นไป |
| กระแส | ≤ 100 mA |
| ทิศทางรับเสียง | Omnidirectional (รอบทิศ) — เพราะวัดเสียงห้อง ไม่ใช่บันทึกเสียงพูด |

**ประเภทที่แนะนำ:**

| แบบ | เหมาะกับ | หมายเหตุ |
|---|---|---|
| **Mini USB mic (แบบเสียบตรง)** | ✅ แนะนำสำหรับโปรเจกต์นี้ | ราคาถูก · เล็ก · omnidirectional · เพียงพอสำหรับวัดระดับเสียง |
| USB conference mic | ห้องใหญ่ | แพงกว่าโดยไม่จำเป็น |
| USB sound card + ไมค์ 3.5mm | ต้องการเลือกไมค์เอง | ยืดหยุ่นแต่ยุ่งกว่า |
| USB condenser mic (ขาตั้ง) | ❌ ไม่แนะนำ | ออกแบบมาสำหรับบันทึกเสียง มักมี AGC ที่ทำให้วัดระดับไม่ได้ |

### ⚠️ AGC — ศัตรูตัวจริงของการวัดระดับเสียง

**AGC (Automatic Gain Control)** ปรับความดังขึ้นเองอัตโนมัติเมื่อเสียงเบา
ซึ่งทำให้ค่าที่วัดได้**ไร้ความหมายโดยสิ้นเชิง** — ห้องเงียบก็จะถูกขยายจนดูเหมือนดัง

ไมค์สำหรับประชุม/สตรีมมักเปิด AGC มาเป็นค่าเริ่มต้น **ต้องปิดให้ได้**

```bash
# ตรวจว่ามี control อะไรบ้าง
amixer -c 1 scontrols

# ปิด AGC / auto gain ถ้ามี
amixer -c 1 sset 'Auto Gain Control' off

# ตั้ง capture gain ให้คงที่แล้วจดค่าไว้ (ห้ามเปลี่ยนอีกหลัง calibrate)
amixer -c 1 sset 'Mic' 50%
```

> 🔑 **หลัง calibrate เสร็จแล้ว ห้ามเปลี่ยนค่า gain อีกเด็ดขาด** — ค่า dB offset ที่หาไว้จะใช้ไม่ได้ทันที
> ค่า gain ที่ตั้งไว้ควรบันทึกไว้ในไฟล์ config และตั้งกลับอัตโนมัติทุกครั้งที่บูต

---

## 3. การตั้งค่าบน Raspberry Pi OS

```bash
# ตรวจว่าระบบเห็นไมค์
arecord -l
# ตัวอย่างผลลัพธ์:
#   card 1: Device [USB PnP Sound Device], device 0: USB Audio [USB Audio]

lsusb                     # ยืนยันว่าเป็น UAC device

# ทดสอบอัดเสียง 5 วินาที
arecord -D plughw:1,0 -f S16_LE -r 48000 -c 1 -d 5 /tmp/test.wav
aplay /tmp/test.wav       # ถ้ามีลำโพงต่ออยู่
```

**สิ่งที่ต้องบันทึกไว้ใน config:**

| ค่า | ตัวอย่าง | หมายเหตุ |
|---|---|---|
| ชื่ออุปกรณ์ | `plughw:1,0` | ⚠️ หมายเลข card **เปลี่ยนได้**เมื่อเสียบ USB ต่างพอร์ต |
| Sample rate | `48000` | |
| จำนวนช่อง | `1` (mono) | |
| รูปแบบ | `S16_LE` | |
| ขนาดหน้าต่าง RMS | `1.0` วินาที | |

### 🔑 ทำให้ชื่ออุปกรณ์คงที่

หมายเลข card ของ ALSA เปลี่ยนได้ตามลำดับการ enumerate ของ USB ทำให้ `plughw:1,0` กลายเป็น `plughw:2,0`
หลังรีบูตหรือเสียบ webcam เพิ่ม (เพราะ webcam ก็มีอุปกรณ์เสียงในตัว)

**วิธีแก้ที่ถูกต้อง — ผูกชื่อกับ USB ID:**

```bash
# หา vendor:product id
lsusb        # เช่น  Bus 001 Device 005: ID 0d8c:0134 C-Media ...
```

สร้าง `/etc/udev/rules.d/85-env-monitor-mic.rules`:

```
SUBSYSTEM=="sound", ATTRS{idVendor}=="0d8c", ATTRS{idProduct}=="0134", ATTR{id}="envmic"
```

จากนั้นอ้างถึงด้วย `plughw:CARD=envmic,DEV=0` ซึ่งจะคงที่เสมอ

> วิธีนี้จำเป็นมากถ้าใช้ USB webcam ร่วมด้วย เพราะจะมีการ์ดเสียงสองใบในระบบ

---

## 4. การคำนวณ dB

### สูตรพื้นฐาน

```
dB = 20 × log₁₀(RMS / REF) + OFFSET
```

โดย:

- **RMS** = รากที่สองของค่าเฉลี่ยกำลังสองของตัวอย่างเสียงในหน้าต่าง 1 วินาที
- **REF** = ค่าอ้างอิง full-scale (สำหรับ 16 บิต = 32768)
- **OFFSET** = ค่าคงที่จากการ calibrate เทียบกับเครื่องวัดจริง (**ต้องอยู่ใน config**)

### ขั้นตอนการคำนวณ

```
1. อ่านบล็อกเสียงจาก ALSA  (48000 ตัวอย่าง = 1 วินาที)
2. แปลงเป็น float แล้วหารด้วย 32768   → ช่วง -1.0 ถึง 1.0
3. ลบค่า DC offset ออก  (ลบค่าเฉลี่ยของบล็อก)
4. (ทางเลือก) กรอง A-weighting
5. RMS = sqrt(mean(x²))
6. dB = 20 × log10(max(RMS, ค่าเล็กสุดกันหาร 0)) + OFFSET
7. จำกัดค่าให้อยู่ในช่วงที่สมเหตุสมผล (เช่น 25–120 dB)
```

**สิ่งที่ต้องระวังในโค้ด:**

| ประเด็น | ทำอย่างไร |
|---|---|
| RMS = 0 (ห้องเงียบสนิท) | ใช้ `max(rms, 1e-10)` กัน `log10(0)` = −∞ |
| DC offset | ไมค์ราคาถูกมักมี DC bias — ต้องลบค่าเฉลี่ยออกก่อนคำนวณ RMS |
| Buffer overrun | ถ้า thread อื่นทำงานหนัก ALSA อาจ drop ข้อมูล — จับ error แล้ว restart stream |
| ค่าคงที่ทั้งหมด | `REF`, `OFFSET`, ช่วง clamp, ขนาดหน้าต่าง — **ทุกตัวต้องมาจาก config** |

### A-weighting — จำเป็นแค่ไหน

**A-weighting** คือฟิลเตอร์ที่ลดน้ำหนักความถี่ต่ำและสูงมาก ให้ใกล้เคียงกับการได้ยินของมนุษย์
เป็นสิ่งที่ทำให้ตัวเลขเรียกว่า "dBA" ได้อย่างถูกต้อง

| แนวทาง | ความแม่นยำ | ความซับซ้อน | เหมาะกับ |
|---|---|---|---|
| **ไม่กรองเลย (dBFS + offset)** | พอใช้ — เปรียบเทียบกันเองได้ | ต่ำมาก | ✅ **เริ่มด้วยแบบนี้** |
| A-weighting ด้วย IIR filter | ดี | ปานกลาง — `scipy.signal` | ถ้าต้องการเรียกว่า dBA จริง ๆ |
| ใช้เครื่องวัด SPL แยกต่างหาก | แม่นที่สุด | สูง (ค่าอุปกรณ์) | งานที่ต้องอ้างอิงมาตรฐาน |

> **คำแนะนำ:** เริ่มจากแบบไม่กรองก่อน ทำให้ระบบทำงานได้ครบวงจร แล้วค่อยเพิ่ม A-weighting ทีหลัง
> ถ้ายังไม่ได้กรอง A-weighting **ควรกำกับบนแดชบอร์ดว่าเป็น "ระดับเสียงสัมพัทธ์" ไม่ใช่ "dBA"**
> เพื่อไม่ให้เข้าใจผิดว่าเป็นค่าที่เทียบกับมาตรฐานได้

---

## 5. การ calibrate

รายละเอียดเต็มอยู่ใน [04-calibration.md](../04-calibration.md#ไมโครโฟน-usb) — สรุปตรงนี้:

```
1. ติดตั้งไมค์ในตำแหน่งจริง ตั้ง gain แล้วจดค่าไว้
2. หาเครื่องอ้างอิง — เครื่องวัด SPL หรือแอปวัดเสียงบนมือถือ (แม่นราว ±3 dB)
3. วางเครื่องอ้างอิงข้างไมค์ ห่างไม่เกิน 10 cm
4. สร้างเสียงคงที่ระดับปานกลาง (เช่น เปิดเพลง หรือ white noise)
5. อ่านค่าพร้อมกันทั้งสองตัว
6. OFFSET = dB จากเครื่องอ้างอิง − dB ที่คำนวณได้จากไมค์
7. ตรวจซ้ำที่ระดับเสียงอื่นอีก 2 ระดับ (เงียบ / ดัง)
8. บันทึก OFFSET ลงไฟล์ config
```

**ข้อจำกัดที่ต้องยอมรับ:** ไมค์ USB ราคาถูกไม่ใช่เครื่องมือวัดมาตรฐาน

- การตอบสนองความถี่ไม่แบน (โดยเฉพาะความถี่ต่ำ)
- ช่วงที่เป็นเชิงเส้นจำกัด — ค่าจะเพี้ยนที่ระดับเงียบมากหรือดังมาก
- ความแม่นยำที่คาดหวังตามจริง: **±5 dB** ในช่วงกลาง (40–85 dB)

> ✅ **ค่านี้เหมาะกับการดูแนวโน้มและเปรียบเทียบกับตัวเอง** — "วันนี้เสียงดังกว่าเมื่อวาน" ใช้ได้
> ❌ **ไม่เหมาะกับการอ้างอิงทางกฎหมายหรือมาตรฐานความปลอดภัย**
> ควรระบุข้อจำกัดนี้ไว้บนแดชบอร์ดด้วย

---

## 6. เกณฑ์ระดับเสียงที่แนะนำ

อ้างอิงแนวทางระดับเสียงในสภาพแวดล้อมทั่วไป

| ระดับ | dBA | เทียบเคียง | ผลต่อสมาธิ |
|---|---|---|---|
| เงียบมาก | < 30 | ห้องสมุดตอนกลางคืน | — |
| **เงียบ** | **30–45** | **ห้องนอน · ห้องทำงานเงียบ** | ✅ เหมาะกับงานที่ต้องใช้สมาธิสูง |
| **ปกติ** | **45–60** | **สำนักงานทั่วไป · การสนทนา** | ✅ ยอมรับได้ |
| ดัง | 60–75 | ร้านอาหาร · การจราจร | ⚠️ เริ่มรบกวนสมาธิ |
| ดังมาก | 75–85 | ถนนพลุกพล่าน · เครื่องดูดฝุ่น | ⚠️ รบกวนชัดเจน |
| อันตราย | > 85 | เสี่ยงต่อการได้ยินถ้าสัมผัสนาน | 🔴 ควรใส่อุปกรณ์ป้องกัน |

> 💡 **เชื่อมโยงกับ Focus feature:** เสียงเกิน 60 dBA สัมพันธ์กับสมาธิที่ลดลง
> เมื่อรวมกับข้อมูล EAR/blink จากกล้อง แดชบอร์ดจะอธิบายได้ว่า
> "สมาธิลดลงเพราะเสียงรบกวน" ไม่ใช่แค่รายงานว่าสมาธิลด

---

## 7. ผลกระทบต่องบไฟและ USB

| รายการ | ค่า |
|---|---|
| กระแสที่ไมค์ใช้ | ~50–100 mA |
| เพดาน USB รวมของ Pi 5 (PSU ธรรมดา) | 600 mA |
| เพดาน USB รวมของ Pi 5 (PSU 5V/5A) | 1.6 A |

**ไมค์อย่างเดียวไม่มีปัญหาแน่นอน** แต่ถ้าจะเพิ่ม USB webcam ด้วย ต้องดู
[03-power-budget.md § งบกระแส USB](../03-power-budget.md#4-งบกระแส-usb--ประเด็นสำคัญ)

---

## 8. การแก้ปัญหา

| อาการ | สาเหตุที่น่าจะเป็น | วิธีแก้ |
|---|---|---|
| `arecord -l` ไม่เจออุปกรณ์ | ไมค์ไม่ใช่ UAC · พอร์ต USB มีปัญหา | `lsusb` ตรวจว่าระบบเห็นไหม · ลองพอร์ตอื่น |
| `Permission denied` | ผู้ใช้ไม่อยู่ในกลุ่ม `audio` | `sudo usermod -aG audio $USER` แล้ว logout/login |
| ค่า dB นิ่งไม่เปลี่ยนเลย | AGC ทำงานอยู่ | ปิด AGC ด้วย `amixer` |
| ค่า dB สูงตลอดแม้ห้องเงียบ | gain สูงเกิน · พัดลม PMS7003/Pi อยู่ใกล้ | ลด gain แล้ว calibrate ใหม่ · ย้ายไมค์ห่างพัดลม ≥30 cm |
| ค่ากระโดดขึ้นลงรุนแรง | หน้าต่าง RMS สั้นเกินไป | เพิ่มเป็น 1 วินาที · เพิ่ม smoothing |
| ค่าเปลี่ยนไปเฉย ๆ หลังรีบูต | หมายเลข card ของ ALSA เปลี่ยน | ตั้ง udev rule ผูกชื่อกับ USB ID |
| `Device or resource busy` | มีโปรเซสอื่นถือไมค์อยู่ | `fuser -v /dev/snd/*` หาตัวที่ถืออยู่ |
| เสียง drop เป็นระยะ (overrun) | CPU ถูกใช้หนักจาก thread อื่น | เพิ่มขนาด ALSA buffer · ลดความสำคัญของงานอื่น |

---

[← กลับสารบัญ](../README.md)
