Randomperson123324/enviroment-monitor/docs/devices/pms7003.md

# PMS7003 — เซนเซอร์ฝุ่นละออง PM1.0 / PM2.5 / PM10

[← กลับสารบัญ](../README.md) · [ผู้ผลิต: Plantower](https://download.kamami.pl/p564008-PMS7003%20series%20data%20manua_English_V2.5.pdf)

---

## 1. สเปกจาก datasheet (V2.5, 2016-06-01)

| รายการ | ค่า |
|---|---|
| หลักการทำงาน | Laser scattering (MIE theory) |
| ขนาดอนุภาคเล็กสุดที่แยกแยะได้ | 0.3 µm |
| ช่วงวัด (PM2.5 มาตรฐาน) | 0–500 µg/m³ (สูงสุด ≥1000 µg/m³) |
| ความละเอียด | 1 µg/m³ |
| ประสิทธิภาพการนับ | 50% @ 0.3 µm · 98% @ ≥0.5 µm |
| ความคลาดเคลื่อนสูงสุด | ±10 µg/m³ @ 0–100 · ±10% @ 100–500 µg/m³ |
| ปริมาตรมาตรฐาน | 0.1 ลิตร |
| เวลาตอบสนอง (ครั้งเดียว) | < 1 วินาที |
| เวลาตอบสนองรวม | ≤ 10 วินาที |
| ไฟเลี้ยง | 5.0V (ต่ำสุด 4.5V · สูงสุด 5.5V) |
| กระแสตอนทำงาน | ≤ 100 mA |
| กระแสตอน standby | ≤ 200 µA |
| ระดับลอจิก | **3.3V** (L < 0.8V · H > 2.7V) |
| อุณหภูมิใช้งาน | −10 ถึง +60 °C |
| ความชื้นใช้งาน | 0–99 %RH |
| MTTF | ≥ 3 ปี |
| ขนาด | 48 × 37 × 12 mm |

---

## 2. ขาสัญญาณ

| ขา | ชื่อ | หน้าที่ | ต่อไปที่ Pi 5 |
|---|---|---|---|
| 1 | VCC | +5V | ขา 4 (5V) |
| 2 | VCC | +5V | ขา 4 (5V) — **ต่อทั้งสองขา** |
| 3 | GND | กราวด์ | ขา 9 (GND) |
| 4 | GND | กราวด์ | ขา 9 (GND) — **ต่อทั้งสองขา** |
| 5 | RESET | รีเซ็ตโมดูล (active low, 3.3V) | GPIO27 (ขา 13) — *ทางเลือก* |
| 6 | NC | — | ❌ **ห้ามต่อ** |
| 7 | RX | รับข้อมูล (3.3V) | GPIO14 / TXD (ขา 8) |
| 8 | NC | — | ❌ **ห้ามต่อ** |
| 9 | TX | ส่งข้อมูล (3.3V) | GPIO15 / RXD (ขา 10) |
| 10 | SET | HIGH/ลอย = ทำงาน · LOW = sleep | GPIO17 (ขา 11) — *ทางเลือก* |

> ขา RESET และ SET มี pull-up ภายในอยู่แล้ว **ถ้าไม่ใช้ให้ปล่อยลอยไว้ ห้ามต่อลง GND**

### ทำไมไม่ต้องใช้ level shifter

ลอจิกของ PMS7003 คือ 3.3V ตรงกับ Pi พอดี:

- Pi TXD ส่งออก 3.3V → PMS7003 ต้องการ H > 2.7V ✅
- PMS7003 TX ส่งออก 3.3V → Pi รับได้สูงสุด 3.3V ✅

datasheet ระบุว่า level shifter จำเป็น**เฉพาะเมื่อ MCU ฝั่งโฮสต์ใช้ไฟ 5V** ซึ่งไม่ใช่กรณีของ Pi 5

---

## 3. โปรโตคอล UART

**พารามิเตอร์พอร์ต:** 9600 bps · 8 data bits · **ไม่มี parity** · 1 stop bit · ไม่มี flow control

### โหมดการทำงาน

| โหมด | พฤติกรรม | ค่าเริ่มต้น |
|---|---|---|
| **Active** | เซนเซอร์ push เฟรมออกมาเอง ไม่ต้องร้องขอ | ✅ ค่าเริ่มต้นหลังจ่ายไฟ |
| Passive | ต้องส่งคำสั่ง `0xE2` ถึงจะตอบกลับ | ต้องสั่งเปลี่ยนโหมดเอง |

โหมด Active แบ่งย่อยอีกสองแบบ ซึ่งเซนเซอร์สลับให้เอง:

- **Stable** — ค่าเปลี่ยนแปลงน้อย → ส่งเฟรมทุก **2.3 วินาที**
- **Fast** — ค่าเปลี่ยนแปลงมาก → ส่งเฟรมทุก **200–800 ms** (ยิ่งฝุ่นเยอะยิ่งถี่)

> **แนะนำให้ใช้โหมด Active ตามค่าเริ่มต้น** อ่านแบบ event-driven จาก UART buffer
> ไม่ต้องเขียนโค้ดสลับโหมดเอง เรียบง่ายและตรงกับที่ผู้ผลิตออกแบบมา

### โครงสร้างเฟรม 32 ไบต์

```
byte:  0    1    2  3    4  5    6  7    8  9   ...  28 29   30 31
      +----+----+-----+-----+-----+-----+-----+-----+-----+--------+
      |0x42|0x4D| len |Data1|Data2|Data3|Data4|Data5| ... |checksum|
      +----+----+-----+-----+-----+-----+-----+-----+-----+--------+
       header     28   PM1.0 PM2.5 PM10  PM1.0 PM2.5       sum of
                       (CF=1)(CF=1)(CF=1)(atmospheric)     byte 0-29
```

| ตำแหน่ง | ฟิลด์ | ความหมาย | ใช้ไหม |
|---|---|---|---|
| 0–1 | หัวเฟรม | `0x42 0x4D` คงที่ | ใช้หาจุดเริ่มเฟรม |
| 2–3 | ความยาว | = 28 (`2×13 + 2`) | ตรวจความถูกต้อง |
| 4–5 | Data1 | PM1.0 (CF=1, particle มาตรฐาน) | ❌ |
| 6–7 | Data2 | PM2.5 (CF=1, particle มาตรฐาน) | ❌ |
| 8–9 | Data3 | PM10 (CF=1, particle มาตรฐาน) | ❌ |
| 10–11 | **Data4** | **PM1.0 (สภาพบรรยากาศ)** | ✅ **ใช้ตัวนี้** |
| 12–13 | **Data5** | **PM2.5 (สภาพบรรยากาศ)** | ✅ **ใช้ตัวนี้** |
| 14–15 | **Data6** | **PM10 (สภาพบรรยากาศ)** | ✅ **ใช้ตัวนี้** |
| 16–17 | Data7 | จำนวนอนุภาค > 0.3 µm ต่อ 0.1 L | ทางเลือก |
| 18–19 | Data8 | จำนวนอนุภาค > 0.5 µm ต่อ 0.1 L | ทางเลือก |
| 20–21 | Data9 | จำนวนอนุภาค > 1.0 µm ต่อ 0.1 L | ทางเลือก |
| 22–23 | Data10 | จำนวนอนุภาค > 2.5 µm ต่อ 0.1 L | ทางเลือก |
| 24–25 | Data11 | จำนวนอนุภาค > 5.0 µm ต่อ 0.1 L | ทางเลือก |
| 26–27 | Data12 | จำนวนอนุภาค > 10 µm ต่อ 0.1 L | ทางเลือก |
| 28–29 | Data13 | สงวนไว้ | ❌ |
| 30–31 | Checksum | ผลรวมของไบต์ 0–29 | ✅ **ต้องตรวจทุกเฟรม** |

ทุกค่าเป็น **unsigned 16-bit big-endian** (ไบต์สูงมาก่อน)

### 🔑 CF=1 กับ "สภาพบรรยากาศ" ต่างกันอย่างไร

- **CF=1 (Data1–3)** — ค่าที่คำนวณโดยใช้ค่าคงที่ปรับเทียบสำหรับ**ฝุ่นในโรงงาน** datasheet ระบุตรง ๆ ว่า
  *"CF=1 should be used in the factory environment"*
- **สภาพบรรยากาศ (Data4–6)** — ค่าที่ปรับเทียบสำหรับ**อากาศทั่วไป** ซึ่งเป็นกรณีใช้งานของโปรเจกต์นี้

> ❗ **ใช้ Data4/5/6 เท่านั้น** เป็นข้อผิดพลาดที่พบบ่อยมากที่ไลบรารีสำเร็จรูปหลายตัวอ่าน Data1–3 มาให้
> ที่ความเข้มข้นต่ำสองชุดนี้มักให้ค่าใกล้เคียงกัน แต่จะแยกออกจากกันชัดเจนเมื่อฝุ่นสูง

### การตรวจ checksum

```
checksum = ผลรวมของไบต์ที่ 0 ถึง 29 (รวมหัวเฟรม 0x42 และ 0x4D ด้วย)
```

เทียบกับค่า 16-bit ที่ไบต์ 30–31 **ถ้าไม่ตรงให้ทิ้งเฟรมนั้นทั้งเฟรม** แล้วหาหัวเฟรมใหม่
อย่าพยายามซ่อมข้อมูล — เฟรมถัดไปมาในไม่กี่วินาทีอยู่แล้ว

### คำสั่งโหมด Passive (ถ้าจำเป็นต้องใช้)

โครงสร้าง 7 ไบต์: `0x42 0x4D <CMD> <DATAH> <DATAL> <LRCH> <LRCL>`

| CMD | DATAL | ความหมาย |
|---|---|---|
| `0xE2` | — | อ่านค่าครั้งเดียว (ตอบกลับ 32 ไบต์เหมือนโหมด active) |
| `0xE1` | `0x00` / `0x01` | เปลี่ยนโหมด: passive / active |
| `0xE4` | `0x00` / `0x01` | sleep / wake |

Verify bytes = ผลรวมของทุกไบต์ยกเว้นสองไบต์สุดท้าย

---

## 4. การอ่านค่าใน Python

ไลบรารีที่แนะนำ: **ไม่ต้องใช้เลย** — โปรโตคอลง่ายพอที่จะเขียนเองด้วย `pyserial`
ซึ่งดีกว่าเพราะควบคุมการตรวจ checksum และการเลือก Data4–6 ได้เอง

```bash
pip install pyserial
```

**โครงสร้าง parser ที่ถูกต้อง** (pseudo-code — ค่าคงที่ทุกตัวต้องมาจาก config):

```
1. เปิดพอร์ตด้วย timeout สั้น ๆ
2. อ่านทีละไบต์จนเจอ 0x42 ตามด้วย 0x4D          ← sync หาหัวเฟรม
3. อ่านอีก 30 ไบต์
4. ตรวจว่า frame_length == 28                     ← ถ้าไม่ใช่ กลับไปข้อ 2
5. คำนวณ checksum ของ 30 ไบต์แรก เทียบกับไบต์ 30-31
6. ถ้าไม่ตรง → ทิ้ง กลับไปข้อ 2
7. แกะ Data4, Data5, Data6 เป็น big-endian uint16
8. ถ้ายังไม่ครบ 30 วินาทีนับจากเปิดพัดลม → ทำเครื่องหมายว่ายัง warming up
```

**สิ่งที่ต้องระวังในโค้ด:**

- **ล้าง input buffer ก่อนอ่าน** ถ้าเว้นช่วงนาน — ไม่งั้นจะได้เฟรมเก่าค้างในบัฟเฟอร์
- **ตั้ง timeout เสมอ** ไม่งั้น thread ค้างถาวรเมื่อสายหลุด
- อย่าเปิด/ปิดพอร์ตซ้ำ ๆ ทุกครั้งที่อ่าน — เปิดครั้งเดียวตอนเริ่ม thread

---

## 5. การ calibrate

**ไม่มีขั้นตอน calibrate สำหรับผู้ใช้** — PMS7003 ปรับเทียบมาจากโรงงานและ datasheet ระบุชัดว่า
*"the sensor should not be checked with any third party equipment"*

สิ่งที่ต้องทำมีแค่:

| รายการ | รายละเอียด |
|---|---|
| **Warm-up** | รอ **30 วินาที** หลังจ่ายไฟหรือปลุกจาก sleep ก่อนเชื่อค่าใด ๆ |
| **ทำความสะอาด** | เป่าลมแรงดันต่ำผ่านช่องลมทุก 6–12 เดือน · **ห้ามใช้ของเหลว** |
| **อายุการใช้งาน** | MTTF ≥ 3 ปี — หลังจากนั้นค่าจะ drift และควรเปลี่ยนตัวใหม่ |

---

## 6. ข้อจำกัดการใช้งานตาม datasheet

datasheet ระบุว่าเซนเซอร์นี้ออกแบบมาสำหรับ**สภาพในร่มทั่วไป** และต้องเพิ่มการป้องกันถ้าใช้ใน:

- สภาพที่ความเข้มข้น ≥300 µg/m³ นานเกิน 50% ของปี หรือ ≥500 µg/m³ นานเกิน 20% ของปี
- **ห้องครัว** (ไอมันเคลือบเลนส์)
- **ห้องน้ำ / ที่มีละอองน้ำ** (ควบแน่นบนออปติก)
- **กลางแจ้ง**

> ⚠️ ในบริบทประเทศไทย ช่วงฤดูฝุ่น (ธ.ค.–มี.ค.) ค่า PM2.5 กลางแจ้งอาจเกิน 300 µg/m³ ได้
> ถ้าติดตั้งในห้องที่ไม่มีเครื่องฟอกอากาศและเปิดหน้าต่าง อายุเซนเซอร์จะสั้นกว่าที่ระบุ

### ข้อกำหนดการติดตั้ง

1. ติดตั้งให้ระนาบช่องลมเข้า-ออกแนบกับผนังเครื่อง หรือมีแผงกั้นระหว่างช่องเข้ากับช่องออก **เพื่อไม่ให้อากาศวนกลับ**
2. ช่องเจาะบนฝาครอบต้อง**ไม่เล็กกว่า**ช่องลมเข้าของเซนเซอร์
3. ติดตั้ง**สูงจากพื้นอย่างน้อย 20 cm** เพื่อไม่ให้ฝุ่นหยาบและขนสัตว์อุดตัน
4. **ห้ามวางในทางลมของเครื่องฟอกอากาศ** — ต้องมีโครงสร้างกำบัง
5. เปลือกโลหะต่อกับ GND — ระวังไม่ให้ไปแตะวงจรส่วนอื่น
6. **ห้ามแกะเซนเซอร์**

---

## 7. เกณฑ์ค่าที่แนะนำสำหรับแดชบอร์ด

อ้างอิงมาตรฐานฝุ่น PM2.5 ในบรรยากาศทั่วไปของไทย (ประกาศคณะกรรมการสิ่งแวดล้อมแห่งชาติ
มีผลบังคับใช้ 1 มิถุนายน 2566) และแนวทางองค์การอนามัยโลก (WHO AQG 2021)

### PM2.5 (µg/m³)

| ระดับ | ช่วง | ที่มา |
|---|---|---|
| ดีมาก | 0–15 | WHO AQG 2021 ค่าเฉลี่ย 24 ชม. |
| ดี | 15–25 | WHO interim target 4 |
| ปานกลาง | 25–37.5 | **37.5 = มาตรฐานไทย 24 ชม. (พ.ศ. 2566)** |
| เริ่มมีผลต่อสุขภาพ | 37.5–75 | WHO interim target 1 |
| มีผลต่อสุขภาพ | > 75 | |

### PM10 (µg/m³)

| ระดับ | ช่วง |
|---|---|
| ดี | 0–45 |
| ปานกลาง | 45–120 |
| เริ่มมีผลต่อสุขภาพ | 120–180 |
| มีผลต่อสุขภาพ | > 180 |

> ⚠️ มาตรฐานเหล่านี้เป็น**ค่าเฉลี่ย 24 ชั่วโมงในบรรยากาศทั่วไป** ไม่ใช่ค่าชั่วขณะในอาคาร
> การเอาค่าอ่านทุก 5 วินาทีมาเทียบตรง ๆ จะทำให้เตือนบ่อยเกินจริง
> **แนะนำ:** แสดงค่าปัจจุบันบนแดชบอร์ด แต่ใช้ค่าเฉลี่ยเคลื่อนที่ (rolling average) 1 ชั่วโมงในการตัดสินระดับเตือน

ค่าเกณฑ์เหล่านี้ต้องไปอยู่ใน `config/sensors.js → THRESHOLDS` เท่านั้น
ห้ามเขียนตัวเลขซ้ำในคอมโพเนนต์ UI → ดู [05-data-schema.md](../05-data-schema.md)

---

## 8. การแก้ปัญหา

| อาการ | สาเหตุที่น่าจะเป็น | วิธีแก้ |
|---|---|---|
| อ่านได้แต่ค่าเป็นขยะ | baud rate ผิด หรือ TX/RX ไม่ได้ไขว้ | ยืนยัน 9600 8N1 · สลับสาย TX ↔ RX |
| ไม่มีข้อมูลเลย | serial console ยังยึด `/dev/ttyAMA0` อยู่ | `sudo raspi-config nonint do_serial_cons 1` แล้วรีบูต |
| ไม่มีข้อมูลเลย + พัดลมไม่หมุน | ไฟไม่ถึง 5V หรือขา SET ถูกดึงลง LOW | วัดแรงดันที่ขา 1 · ปล่อยขา SET ลอย |
| ค่า PM ต่ำผิดปกติเสมอ (~0) | ยังไม่ครบ warm-up 30 วินาที · ช่องลมถูกบัง | รอให้ครบ · ตรวจสิ่งกีดขวางช่องลม |
| checksum ผิดบ่อย | สายยาวเกินไป หรือกราวด์ไม่ร่วม | สายสั้นลง · ตรวจ GND · ลอง `dtoverlay=disable-bt` |
| ค่าสูงผิดปกติต่อเนื่อง | ควันบุหรี่/ธูป/การทำอาหารใกล้เคียง หรือเลนส์สกปรก | ย้ายตำแหน่ง · เป่าลมทำความสะอาด |
| พัดลมมีเสียงครวญ | ตลับลูกปืนเสื่อม (ใกล้หมดอายุ) | เตรียมเปลี่ยนตัวใหม่ |

---

[← กลับสารบัญ](../README.md)
