Randomperson123324/enviroment-monitor/docs/devices/sgp30.md

# SGP30 — เซนเซอร์ TVOC / eCO₂

[← กลับสารบัญ](../README.md) · [ผู้ผลิต: Sensirion](https://files.seeedstudio.com/wiki/Grove-VOC_and_eCO2_Gas_Sensor-SGP30/res/Sensirion_Gas_Sensors_SGP30_Datasheet_EN.pdf)

> **บทบาทในระบบนี้:** ตรวจจับสารอินทรีย์ระเหยง่าย (VOC) — กลิ่น น้ำยาทำความสะอาด สี ควัน
> **ไม่ใช่**เซนเซอร์ CO₂ แม้จะมีค่า "eCO₂" ให้ก็ตาม → ใช้ SCD40 สำหรับ CO₂ จริง

---

## 1. สเปกจาก datasheet (v0.9, สิงหาคม 2017)

### สัญญาณคุณภาพอากาศ

| รายการ | TVOC | eCO₂ (CO₂eq) |
|---|---|---|
| ช่วงค่าที่ส่งออก | 0 – 60,000 ppb | 400 – 60,000 ppm |
| ความละเอียด | 1 ppb (0–2,008) · 6 ppb (2,008–11,110) · 32 ppb (11,110–60,000) | 1 ppm (400–1,479) · 3 ppm (1,479–5,144) · 9 ppm (5,144–17,597) · 31 ppm (17,597–60,000) |
| **อัตราการสุ่ม** | **1 Hz** 🔴 | **1 Hz** 🔴 |

### สัญญาณดิบ (ที่มาของค่าข้างบน)

| รายการ | ค่า |
|---|---|
| สัญญาณ Ethanol | 0–1,000 ppm (ระบุสเปกที่ 0.3–30 ppm) · ความแม่นยำ ~15% ของค่าที่วัด |
| สัญญาณ H₂ | 0–1,000 ppm (ระบุสเปกที่ 0.5–10 ppm) · ความแม่นยำ ~10% ของค่าที่วัด |
| การ drift ระยะยาว | ~1.3% ของค่าที่วัด ต่อปี |

### ไฟฟ้า

| รายการ | ค่า |
|---|---|
| **แรงดันไฟเลี้ยง (ตัวชิป)** | **1.62 – 1.98V (ปกติ 1.8V)** ⚠️ |
| กระแสตอนวัด | 48.2 mA |
| กระแสตอน sleep | 2 µA (สูงสุด 10 µA) |
| เวลาบูตหลังจ่ายไฟ | 0.4 ms (สูงสุด 0.6 ms) |
| ความถี่ SCL | 0 – 400 kHz (รองรับ I2C fast mode) |
| ที่อยู่ I2C | **`0x58`** (ตายตัว เปลี่ยนไม่ได้) |
| ช่วงอุณหภูมิที่แนะนำ | 5 – 55 °C |
| ความชื้นสัมบูรณ์ที่แนะนำ | 4 – 20 g/m³ |
| ขนาด | 2.45 × 2.45 × 0.9 mm (DFN 6 ขา) |

---

## 2. ⚠️ คำเตือนเรื่องแรงดัน

**ตัวชิป SGP30 ทำงานที่ 1.8V เท่านั้น — แรงดันสูงสุดที่ทนได้คือ 2.16V**

หมายความว่า **การต่อชิปเปล่าเข้ากับราง 3.3V ของ Pi จะทำให้ชิปพังทันที**

> ✅ **ต้องซื้อเป็นบอร์ด breakout** ที่มี LDO regulator ลด 3.3V/5V → 1.8V
> พร้อม level shifter สำหรับบัส I2C มาให้เรียบร้อย

บอร์ดที่ใช้ได้และตรวจสอบแล้วว่ามีวงจรครบ:

| บอร์ด | ไฟเข้า | หมายเหตุ |
|---|---|---|
| Adafruit SGP30 Breakout (#3709) | 3.3V หรือ 5V | มี STEMMA QT/Qwiic · เอกสารดีที่สุด |
| Grove VOC and eCO2 Gas Sensor (Seeed) | 3.3V หรือ 5V | ใช้สาย Grove |
| โมดูล SGP30 ทั่วไปจากจีน | มักระบุ 3.3–5V | ⚠️ **ต้องตรวจว่ามี LDO จริง**ก่อนต่อไฟ |

**วิธีตรวจโมดูลที่ไม่แน่ใจ:** มองหาชิป 5–6 ขาขนาดเล็กใกล้ขา VIN (คือ LDO)
ถ้าเห็นแค่ตัวชิป SGP30 กับตัวต้านทานสองสามตัว **อย่าเสี่ยง** — วัดแรงดันที่ขา VDD ของชิป
ด้วยมัลติมิเตอร์ขณะจ่ายไฟ 3.3V เข้า VIN ต้องอ่านได้ ~1.8V

---

## 3. การต่อสาย

| SGP30 breakout | → Pi 5 (ขา) |
|---|---|
| VIN / VCC | ขา 2 (5V) หรือ ขา 1 (3V3) — บอร์ดจัดการเอง |
| GND | ขา 14 (GND) |
| SDA | ขา 3 (GPIO2) |
| SCL | ขา 5 (GPIO3) |

พร้อม capacitor **100 nF** คร่อม VDD–GND ให้ใกล้ที่สุด (datasheet บังคับข้อนี้)

---

## 4. คำสั่ง I2C

| คำสั่ง | รหัส | พารามิเตอร์ (ไบต์) | ตอบกลับ (ไบต์) | เวลาปกติ / สูงสุด (ms) |
|---|---|---|---|---|
| `Init_air_quality` | `0x2003` | — | — | 2 / 10 |
| `Measure_air_quality` | `0x2008` | — | 6 | 10 / 12 |
| `Get_baseline` | `0x2015` | — | 6 | 10 / 10 |
| `Set_baseline` | `0x201E` | 6 | — | 10 / 10 |
| `Set_humidity` | `0x2061` | 3 | — | 1 / 10 |
| `Measure_test` | `0x2032` | — | 3 | 200 / 220 |
| `Get_feature_set_version` | `0x202F` | — | 3 | 1 / 2 |
| `Measure_raw_signals` | `0x2050` | — | 6 | 20 / 25 |
| `Get_Serial_ID` | `0x3682` | — | 9 | — |
| Soft reset (General Call) | `0x0006` | — | — | 0.4 / 0.6 |

**CRC-8:** polynomial `0x31` (x⁸+x⁵+x⁴+1) · init `0xFF` · ไม่ reflect · final XOR `0x00`
ตัวอย่าง: `CRC(0xBEEF) = 0x92`

### รูปแบบข้อมูล `Measure_air_quality`

ตอบกลับ 6 ไบต์ **เรียงลำดับ eCO₂ ก่อน TVOC**:

```
[eCO2_MSB][eCO2_LSB][CRC]  [TVOC_MSB][TVOC_LSB][CRC]
```

ค่าใช้ได้ตรง ๆ ไม่ต้องแปลง (eCO₂ = ppm · TVOC = ppb)

> ⚠️ **แต่ `Set_baseline` รับพารามิเตอร์เรียงกลับกัน คือ (TVOC, eCO₂)**
> ขณะที่ `Get_baseline` คืนค่าเรียง (eCO₂, TVOC) — datasheet ระบุไว้ชัดเจน
> **นี่คือจุดที่โค้ดมักผิดโดยไม่รู้ตัว** เพราะไม่มี error ให้เห็น แค่ค่า drift เพี้ยนไปเรื่อย ๆ

### ⚠️ ห้ามใช้ `Measure_test` ในการทำงานปกติ

datasheet ระบุว่าคำสั่งนี้มีไว้สำหรับ**ทดสอบสายการผลิตเท่านั้น** และ
**ห้ามเรียกหลังจากส่ง `Init_air_quality` ไปแล้ว** เพราะจะทำให้เซนเซอร์กลับไป sleep mode
และ baseline ที่สะสมมาหายไป

---

## 5. 🔴 ข้อบังคับ: ต้องอ่านทุก 1 วินาทีเป๊ะ ๆ

datasheet ระบุไว้ชัด:

> *"After the 'Init_air_quality' command, a 'Measure_air_quality' command has to be sent
> in regular intervals of 1s to ensure proper operation of the dynamic baseline compensation algorithm."*

อัลกอริทึม baseline ภายในชิปถูกปรับจูนมาสำหรับ **1 Hz เท่านั้น** ถ้ารอบไม่สม่ำเสมอ:

- baseline จะ drift ผิดทิศ
- ค่า TVOC จะสูงหรือต่ำเกินจริงอย่างเป็นระบบ
- **ไม่มี error หรือสัญญาณเตือนใด ๆ ให้เห็น** — ค่ายังคงออกมาดูสมเหตุสมผล

**การเขียนโค้ดที่ถูกต้อง:**

- ใช้ thread แยกที่วนลูปด้วยตัวจับเวลาแบบ absolute (คำนวณเวลาถัดไปจากเวลาเริ่ม)
  **ไม่ใช่** `sleep(1)` ต่อท้ายงาน เพราะเวลาที่ใช้อ่านค่าจะสะสมเป็น drift
- อย่าเอา SGP30 ไปวนลูปรวมกับเซนเซอร์อื่นที่มีรอบต่างกัน
- ถ้าอ่านพลาดหนึ่งรอบ ให้ข้ามไปรอบถัดไปตามตาราง **ไม่ใช่**อ่านทันทีเพื่อชดเชย

```python
# แนวคิด — ค่าคงที่ต้องมาจาก config
next_at = time.monotonic()
while running:
    next_at += config["sgp30"]["interval_s"]   # ไม่สะสม drift
    read_and_store()
    time.sleep(max(0, next_at - time.monotonic()))
```

---

## 6. Baseline — สิ่งที่ต้องทำให้ถูก ไม่งั้นค่าไร้ความหมาย

SGP30 ใช้ **dynamic baseline compensation** คือเรียนรู้ว่า "อากาศปกติของที่นี่" เป็นอย่างไร
แล้วรายงานส่วนที่เบี่ยงเบนจากนั้น

### ช่วงเริ่มต้น

| ช่วงเวลา | สิ่งที่เกิดขึ้น |
|---|---|
| 0–15 วินาที หลัง `Init_air_quality` | คืนค่าคงที่ **400 ppm / 0 ppb** — **ต้องทิ้ง อย่าส่งขึ้นแดชบอร์ด** |
| 15 วินาที – 12 ชั่วโมง (ครั้งแรกที่ติดตั้ง) | baseline ยังสร้างไม่เสร็จ ค่าเชื่อถือได้บางส่วน |
| หลัง 12 ชั่วโมง | baseline ใช้ได้ — **เริ่มบันทึกลงไฟล์ได้** |

### วงจรบันทึกและกู้คืน baseline

| ขั้น | ทำอะไร | เงื่อนไข / หมายเหตุ |
|---|---|---|
| 1 | เริ่มระบบ | — |
| 2 | `Init_air_quality` | ต้องเรียกทุกครั้งหลังจ่ายไฟหรือ soft reset |
| 3 | ตรวจไฟล์ `baseline.json` | อายุน้อยกว่า 7 วันหรือไม่ |
| 3ก | **มี** → `Set_baseline(tvoc, eco2)` | ⚠️ **สลับลำดับ!** ไม่ใช่ `(eco2, tvoc)` |
| 3ข | **ไม่มี** → ข้ามไป | ปล่อยให้เรียนรู้ baseline ใหม่ 12 ชั่วโมง |
| 4 | ทิ้งค่า 15 วินาทีแรก | เซนเซอร์คืนค่าคงที่ 400 ppm / 0 ppb |
| 5 | วนลูปอ่านทุก 1.000 วินาที | ต้องเป๊ะ — ดูหัวข้อ 5 |
| 6 | ทุก 1 ชั่วโมง: `Get_baseline()` → เขียนไฟล์ | เริ่มบันทึกหลังผ่าน 12 ชั่วโมงแรกแล้วเท่านั้น |

**กฎที่ต้องยึด:**

| กฎ | เหตุผล |
|---|---|
| บันทึกทุก **1 ชั่วโมง** ไม่ใช่ทุกนาที | ถนอม SD card |
| baseline ที่เก่ากว่า **7 วัน ให้ทิ้ง** | datasheet แนะนำ — ค่าเก่าเกินไปแย่กว่าไม่มีเลย |
| เก็บ path ของไฟล์ไว้ใน config | ไม่ hardcode |
| อย่าบันทึกก่อนครบ 12 ชั่วโมงแรก | จะบันทึก baseline ที่ยังไม่สมบูรณ์ |
| เขียนไฟล์แบบ atomic (เขียนไฟล์ชั่วคราวแล้ว rename) | กันไฟล์เสียตอนไฟดับ |

---

## 7. Humidity compensation

SGP30 มีวงจรชดเชยความชื้นในตัว แต่ต้อง**ป้อนค่าความชื้นสัมบูรณ์จากภายนอกให้**
ซึ่งในระบบนี้เอามาจาก SCD40 ได้เลย

### สูตรแปลง RH + T → ความชื้นสัมบูรณ์ (g/m³)

```
AH = 216.7 × [ (RH/100) × 6.112 × exp(17.62 × T / (243.12 + T)) ] / (273.15 + T)
```

โดย `T` = °C และ `RH` = %

### รูปแบบข้อมูลที่ส่งให้ `Set_humidity`

เป็น **fixed-point 8.8 bit** (8 บิตบนคือจำนวนเต็ม · 8 บิตล่างคือเศษส่วน):

```
ค่าที่ส่ง = round(AH × 256)
```

| ตัวอย่าง | ค่า hex | ความหมาย |
|---|---|---|
| 16.50 g/m³ | `0x0F80` | 16 + 128/256 |
| 11.57 g/m³ | `0x0B92` | ค่าเริ่มต้นจากโรงงาน |
| ต่ำสุด | `0x0001` | 1/256 g/m³ |
| **ปิดการชดเชย** | `0x0000` | 0 g/m³ |

**ความถี่ในการอัปเดต:** ทุก 1–5 นาทีก็เพียงพอ ความชื้นในห้องไม่เปลี่ยนเร็วขนาดนั้น
ค่าที่ตั้งจะถูกใช้ต่อเนื่องจนกว่าจะส่งค่าใหม่

> ⚠️ ค่าจะรีเซ็ตกลับเป็น `0x0B92` ทุกครั้งที่จ่ายไฟใหม่หรือ soft reset
> **ต้องส่ง `Set_humidity` ใหม่ทุกครั้งหลังบูต**

**ลำดับที่ถูกต้อง:** อ่าน RH+T จาก SCD40 → คำนวณ AH → `Set_humidity` → แล้วค่อยอ่าน `Measure_air_quality`

---

## 8. ⚠️ สารที่ทำให้เซนเซอร์เสื่อมถาวร

SGP30 เป็นเซนเซอร์แบบ metal-oxide ซึ่ง**เสียหายถาวร**เมื่อสัมผัสสารบางชนิด — ไม่สามารถซ่อมหรือ calibrate กลับได้

| กลุ่ม | ตัวอย่าง |
|---|---|
| **ซิลิโคน** ⚠️ อันตรายที่สุด | กาวซิลิโคน · ซิลิโคนหล่อลื่น · sealant · ยางซิลิโคนบางชนิด |
| ตัวทำละลาย | ทินเนอร์ · อะซิโตน · น้ำยาล้างเล็บ · แอลกอฮอล์เข้มข้น |
| น้ำหอม | สเปรย์ปรับอากาศ · น้ำหอมปรับผ้านุ่ม · เทียนหอม · น้ำมันหอมระเหย |
| สารเคมีอื่น | ฟอร์มาลดีไฮด์เข้มข้น · ไอกรด |

**ข้อปฏิบัติ:**

- ประกอบด้วยสกรูและ standoff **ห้ามใช้กาวซิลิโคนหรือ hot glue ใกล้เซนเซอร์**
- เก็บในถุงกันไฟฟ้าสถิตที่ปิดสนิทก่อนติดตั้ง
- ห้ามล้างบอร์ดด้วยตัวทำละลายหลังบัดกรี
- ถ้าติดตั้งในกล่อง ให้ระบายอากาศได้ — อย่าใช้กล่องที่ปล่อยไอพลาสติก

---

## 9. ไลบรารี Python

```bash
pip install adafruit-circuitpython-sgp30
```

หรือเขียนเองด้วย `smbus2` ซึ่งไม่ยากเพราะคำสั่งมีไม่กี่ตัว — ข้อดีคือควบคุมจังหวะ 1 Hz
และการจัดการ baseline ได้เต็มที่ ซึ่งเป็นสองเรื่องที่สำคัญที่สุดของเซนเซอร์ตัวนี้

> Sensirion ไม่มีไลบรารี Python ทางการสำหรับ SGP30 (มีสำหรับ SGP40/41 รุ่นใหม่กว่า)
> ไลบรารีของ Adafruit จึงเป็นตัวเลือกที่ดูแลดีที่สุดที่มีอยู่

---

## 10. เกณฑ์ค่า TVOC ที่แนะนำ

อิงตามแนวทางของหน่วยงานสิ่งแวดล้อมเยอรมนี (UBA) ซึ่งเป็นเกณฑ์ TVOC ที่อ้างอิงกันแพร่หลายที่สุด

| ระดับ | TVOC (ppb) | ความหมาย | คำแนะนำ |
|---|---|---|---|
| ดีเยี่ยม | 0–65 | อากาศสะอาด | — |
| ดี | 65–220 | ปกติ | — |
| ปานกลาง | 220–660 | เริ่มมีกลิ่น/สารระเหย | ระบายอากาศ |
| แย่ | 660–2,200 | ไม่ควรอยู่นาน | ระบายอากาศทันที |
| แย่มาก | > 2,200 | ไม่เหมาะกับการอยู่อาศัย | ออกจากพื้นที่ · หาต้นตอ |

> **eCO₂ ไม่ควรใช้ตั้งเกณฑ์เตือนเลย** เพราะเป็นค่าที่คำนวณจากสัญญาณ VOC ไม่ได้วัด CO₂
> ในระบบนี้เรามี SCD40 ที่วัด CO₂ จริงอยู่แล้ว
> ถ้าจะแสดง eCO₂ บนแดชบอร์ด ควรกำกับให้ชัดว่าเป็นค่าประมาณจาก VOC

---

## 11. การแก้ปัญหา

| อาการ | สาเหตุที่น่าจะเป็น | วิธีแก้ |
|---|---|---|
| ค่าค้างที่ 400 ppm / 0 ppb ตลอด | ยังอยู่ในช่วง init 15 วินาที · หรือลืมส่ง `Init_air_quality` | รอให้ครบ · ตรวจว่าส่ง init แล้ว |
| TVOC สูงผิดปกติเสมอ | baseline ยังไม่สร้างเสร็จ · หรือโดนสารทำลาย | รอ 12 ชั่วโมง · ถ้ายังไม่ดีขึ้นแปลว่าเซนเซอร์เสีย |
| TVOC เป็น 0 ตลอดทั้งวัน | baseline ปรับตัวตามอากาศที่นิ่งเกินไป | เป็นพฤติกรรมปกติ · ค่าจะขึ้นเมื่อมีการเปลี่ยนแปลงจริง |
| ค่า drift เรื่อย ๆ วันต่อวัน | รอบการอ่านไม่ใช่ 1 Hz เป๊ะ | ตรวจ timing ของ thread ให้ใช้ absolute timer |
| Set_baseline แล้วค่าแย่ลง | สลับลำดับ (TVOC, eCO₂) ผิด | ตรวจลำดับพารามิเตอร์ให้เป็น TVOC ก่อน |
| `i2cdetect` ไม่เจอ `0x58` | โมดูลไม่มี LDO และชิปพังไปแล้ว | วัดแรงดันที่ขา VDD ของชิป ต้องได้ 1.8V |
| ค่าเพี้ยนหลังย้ายห้อง | baseline ผูกกับสภาพแวดล้อมเดิม | ลบ baseline.json แล้วให้เรียนรู้ใหม่ 12 ชั่วโมง |
| ค่าไม่ตอบสนองต่อกลิ่นเลย | เซนเซอร์เสื่อมจากซิลิโคน/ตัวทำละลาย | เปลี่ยนตัวใหม่ — กู้ไม่ได้ |

---

[← กลับสารบัญ](../README.md)
