Randomperson123324/enviroment-monitor/docs/devices/summary.md

# สรุปอุปกรณ์ทั้งหมด

## ตารางเปรียบเทียบ

| อุปกรณ์ | วัดค่า (หน่วย) | อินเทอร์เฟซ | ไฟเลี้ยง | กระแส เฉลี่ย / พีค | รอบอ่าน | Warm-up |
|---|---|---|---|---|---|---|
| **PMS7003** | PM1.0 · PM2.5 · PM10 (µg/m³) | UART 9600 8N1 · `/dev/ttyAMA0` | **5V** (ลอจิก 3.3V) | 100 / 150 mA | ~2.3 s (push เอง) | **30 วิ** |
| **SCD40** | CO₂ (ppm) · T (°C) · RH (%) | I2C `0x62` | **3.3V เท่านั้น** | 18 / **205** mA | 5 s | ~5 วิ |
| **SGP30** | TVOC (ppb) · eCO₂ (ppm) | I2C `0x58` | 3.3–5V (ผ่าน breakout) | 60 / 65 mA | **1.000 s เป๊ะ** | 15 วิ · **12 ชม.** |
| **BH1750** | ความสว่าง (lx) | I2C `0x23` | 3.3V | 0.12 / 0.19 mA | 120 ms | ~1 วิ |
| **USB mic** | ระดับเสียง (dB) | USB Audio Class | จาก USB bus | 50–100 mA | หน้าต่าง RMS 1 s | ทันที |
| **กล้อง** | ใบหน้า · EAR · การขยับ | CSI-2 (แนะนำ) หรือ USB | จากบอร์ด / USB | ~250 mA | 10–15 fps | ทันที |

## แผนที่ทรัพยากรบน Raspberry Pi 5

| ทรัพยากร | ขา | ใช้โดย |
|---|---|---|
| I2C-1 @ 100 kHz | 3 (SDA) · 5 (SCL) | SCD40 `0x62` · SGP30 `0x58` · BH1750 `0x23` — **ไม่มีที่อยู่ชนกัน** |
| UART0 @ 9600 | 8 (TXD) · 10 (RXD) | PMS7003 — Pi TXD→เซนเซอร์ RX, Pi RXD→เซนเซอร์ TX (**ไขว้กัน**) · SET/RESET *(ทางเลือก)* ที่ขา 11 · 13 |
| ราง 3V3 · 5V | 1 · 17 · 2 · 4 | 3V3 → SCD40 · BH1750 (+ SGP30 breakout) · 5V → PMS7003 (ต่อ VCC ทั้งขา 1+2 และ GND ทั้งขา 3+4) |
| USB · CSI-2 | พอร์ต USB · ขั้ว CAM/DISP | ไมโครโฟน (+ webcam ถ้าไม่ใช้ CSI) · Camera Module 3 **ต้องมีสายแปลง 15→22 ขา** |

**ขาที่ห้ามใช้:** 27–28 (HAT EEPROM) · 12 (สำรองไว้ให้ I2S) · 19/21/23 (SPI0)

## งบกำลังไฟ

| ราง | 3V3 | 5V | USB | Pi 5 | **รวม** |
|---|---|---|---|---|---|
| เฉลี่ย | ~78 mA (0.26 W) | 100 mA (0.50 W) | 150–350 mA | ~7 W | **~9 W** |
| พีค | ~270 mA (0.89 W) | 150 mA (0.75 W) | ~500 mA | ~13 W | **~16 W** |

พีคของราง 3V3 มาจากพัลส์ IR ของ SCD40 ทุก 5 วินาที · USB มีเพดาน 600 mA และปลดเป็น 1.6 A เมื่อเจอ PSU 5A · **ใช้ PSU 27W (5.1V/5A) ทางการ**
**ตัวเก็บประจุที่ต้องมี:** 100 nF คร่อม VDD–GND ของทุกบอร์ด I2C · 100 µF ที่ปลายสาย 3V3 ฝั่งเซนเซอร์ · 220 µF ที่ขั้ว VCC ของ PMS7003

## คำเตือนที่ทำให้ของพังหรือข้อมูลผิด

| # | เรื่อง | ผลถ้าทำผิด |
|---|---|---|
| 1 | **SCD40 ต้องจ่าย 3.3V เท่านั้น** — ระดับลอจิก I2C อ้างอิงกับ VDD | จ่าย 5V แล้วบัสเป็น 5V → **GPIO ของ Pi พังถาวร** |
| 2 | **SGP30 ตัวชิปใช้ 1.8V** ทนสูงสุด 2.16V — ต้องเป็น breakout ที่มี LDO | ต่อ 3.3V เข้าชิปตรง ๆ → **ชิปพังทันที** |
| 3 | **PMS7003 อ่าน Data4/5/6** (สภาพบรรยากาศ) ไม่ใช่ Data1/2/3 (CF=1 สำหรับโรงงาน) | ค่า PM ผิดเมื่อฝุ่นสูง · ไลบรารีสำเร็จรูปหลายตัวหยิบผิด |
| 4 | **SGP30 ต้องอ่านทุก 1 วินาทีเป๊ะ** และ `Set_baseline` รับ **(TVOC, eCO₂)** สลับกับที่ `Get_baseline` คืนมา | baseline drift · **ไม่มี error ให้เห็น** ค่ายังดูสมเหตุสมผล |
| 5 | **SCD40 ต้องตั้ง temperature offset** หลังประกอบเสร็จในตำแหน่งจริง | อุณหภูมิสูงเกินจริง 5–10 °C **และ RH ผิดตามไปด้วย** |
| 6 | **pull-up I2C รวมกันเหลือ ~1.05 kΩ (3.1 mA)** เกินเงื่อนไขทดสอบของ SGP30 (2 mA) | บัสไม่นิ่งเมื่อสายยาว → ถอด pull-up ออกจากบอร์ด 1–2 ตัว |

## การ calibrate

| อุปกรณ์ | ต้องทำไหม | ทำอะไร · เก็บผลที่ไหน | ความถี่ |
|---|---|---|---|
| **SCD40** | **ต้องทำ** | temperature offset (เทียบเทอร์โมมิเตอร์หลังอุ่น 30 นาที) → EEPROM · แล้ว FRC ที่อากาศบริสุทธิ์ 420 ppm — **ห้องแอร์ปิดตลอดควรปิด ASC** | offset ครั้งเดียว · FRC ทุก 6–12 เดือน |
| **SGP30** | **ต้องทำ** | บันทึก/กู้คืน baseline อัตโนมัติ → `calibration/baseline.json` · ทิ้งเมื่อเก่าเกิน 7 วัน | ทุก 1 ชม. |
| **USB mic** | **ต้องทำ** | หา dB offset เทียบเครื่องวัด → ไฟล์ config · **ห้ามเปลี่ยน gain หลังจากนั้น** | ครั้งเดียว |
| BH1750 | ถ้ามีฝาครอบ | transmission factor (อะคริลิกใส ~0.91) → ไฟล์ config | ครั้งเดียว |
| กล้อง | ทางเลือก | ปรับ EAR threshold ให้เข้ากับรูปตาแต่ละคน → `config/sensors.js` | ครั้งเดียวต่อคน |
| PMS7003 | **ไม่ต้อง** | ปรับเทียบจากโรงงาน — แค่เป่าลมทำความสะอาดทุก 6–12 เดือน | — |

## ค่าที่ส่งเข้า `POST /api/ingest`

`pm1` · `pm25` · `pm10` (µg/m³ — PMS7003) · `co2` (ppm) · `temperature` (°C) · `humidity` (% — ทั้งสามจาก SCD40) ·
`tvoc` (ppb) · `eco2` (ppm — SGP30) · `lux` (lx — BH1750) · `sound_db` (dB — USB mic) · `webcam_json` (jsonb — กล้อง)

**กฎสำคัญ:** อ่านค่าไม่ได้หรือยัง warm-up อยู่ → ส่ง `null` **ห้ามส่ง `0`** เพราะฝั่งเซิร์ฟเวอร์ใช้ `Number.isFinite()` กรอง ถ้าส่ง 0 จะถูกนับเป็นค่าจริงและทำให้คะแนนสุขภาพห้องเพี้ยน · อัปโหลดทุก 5 วินาทีให้ตรงกับ `CLIENT_POLL_MS_DEFAULT`
