Randomperson123324/enviroment-monitor/pi-vision/faces/README.txt

วางรูปใบหน้าที่นี่ ตั้งชื่อไฟล์เป็นชื่อคน เช่น somchai.jpg
ใส่หลายรูปต่อคนได้โดยสร้างโฟลเดอร์ชื่อคนแล้วใส่รูปข้างใน — แม่นกว่ารูปเดียว
หนึ่งรูปควรมีใบหน้าเดียว หันตรง เห็นชัด
โฟลเดอร์ว่าง = ระบบใช้หมายเลขแทนชื่อเหมือนเดิม

── หรือถ่ายจากกล้องสดเลย (ง่ายกว่าและได้รูปที่ตรงกว่า) ──────
กด n ขณะโปรแกรมทำงาน → พิมพ์ชื่อ → ยืนใกล้กล้องที่สุด → เคาะ space ถ่าย → Esc จบ
รูปจะมาโผล่เป็น <ชื่อ>/cam_<วันเวลา>.jpg และถูกอ่านทันทีโดยไม่ต้องรีสตาร์ต
โปรแกรมครอปรอบใบหน้าให้เอง ตัดคนอื่นที่ยืนอยู่ในเฟรมออก และคุมอัตราส่วนให้ตรงกับกล้อง
— ทั้งสามอย่างนี้คือสิ่งที่รูปจากมือถือมักทำพลาด (ดูหัวข้อ "ตัดรูปแค่ไหน" ข้างล่าง)

ระบบตั้งเกณฑ์ความเหมือนเองจากรูปพวกนี้ (ดูบรรทัด 'เกณฑ์ความเหมือน' ตอนเปิดโปรแกรม)
จึงควรมีอย่างน้อย 2 รูปต่อคน — รูปใบเดียวไม่บอกว่ารูปของคนคนนั้นต่างกันได้แค่ไหน

── ตัดรูปแค่ไหน? ────────────────────────────────────────────
ไม่ต้องตัดชิดใบหน้า ระบบตัดให้เองแล้ว · จากการวัดจริง รูปที่ตัดชิดหน้ากับรูปครึ่งตัว
ให้ลายเซ็นห่างกันแค่ 0.014 ซึ่งไม่มีผลอะไร (เกณฑ์อยู่ราว 0.045)

สิ่งที่เคยมีผลมากคือ **อัตราส่วนของรูป** ไม่ใช่ระยะที่ตัด — รูปแนวตั้งกับแนวนอน
ของคนคนเดียวกันเคยห่างกันถึง 0.077 คือเกินเกณฑ์ ระบบจะตัดสินว่าเป็นคนละคน
เพราะลายเซ็นมีสัดส่วน "ความสูงหน้า ÷ ความกว้างหน้า" อยู่ด้วย ซึ่งคิดจากพิกัดที่
หารด้วยขนาดภาพคนละแกน · ตอนนี้โปรแกรมตัดรูปให้เป็นอัตราส่วนเดียวกับกล้องก่อน
ถอดลายเซ็นแล้ว จึงวางรูปแนวไหนก็ได้

สิ่งที่ยังมีผลจริง ๆ:
  - หน้าต้องใหญ่พอให้เห็นชัด (รูปที่หาใบหน้าไม่เจอจะถูกข้าม และมีบอกตอนเปิดโปรแกรม)
  - ควรหันหน้าตรง — รูปที่หันข้างใช้เป็นจุดอ้างอิงท่านิ่งไม่ได้ (โปรแกรมจะบอกให้รู้)
  - ถ่ายด้วยมุมกล้องใกล้เคียงกับกล้องตัวที่จะใช้จริง ถ้าเป็นไปได้
