Randomperson123324/enviroment-monitor/docs/devices/research-basis.md

# ทบทวนวรรณกรรม — สภาพแวดล้อมภายในอาคารกับสมาธิและสมรรถนะการคิด

> **บทนี้ทำหน้าที่เป็นบทที่ 2 ของรายงานโครงงาน** — อธิบายว่าเกณฑ์เตือนทุกค่าใน
> `config/sensors.js` มาจากไหน มีหลักฐานอะไรรองรับ หลักฐานแข็งแค่ไหน และมีข้อโต้แย้งอะไรบ้าง
>
> รูปแบบการอ้างอิง: **APA 7** · การอ้างอิงในเนื้อหาเป็น (ชื่อผู้แต่ง, ปี)

---

## 2.1 ที่มาและความสำคัญ

การเรียนและการทำงานส่วนใหญ่เกิดขึ้น**ภายในอาคาร** ซึ่งเป็นพื้นที่ปิดที่สภาพแวดล้อม
เบี่ยงเบนจากธรรมชาติได้มาก — คาร์บอนไดออกไซด์สะสมจากลมหายใจ อุณหภูมิถูกควบคุมด้วย
เครื่องปรับอากาศ ฝุ่นละอองลอดเข้ามาจากภายนอก และเสียงรบกวนจากคนรอบข้าง

งานวิจัยในช่วงสองทศวรรษที่ผ่านมาแสดงให้เห็นว่าปัจจัยเหล่านี้**ไม่ได้ส่งผลแค่ความสบาย**
แต่กระทบถึงสมรรถนะการคิดและความสามารถในการจดจ่ออย่างวัดได้ อย่างไรก็ตาม
งานวิจัยส่วนใหญ่**ศึกษาทีละปัจจัยในห้องปฏิบัติการ** ขณะที่สภาพจริงปัจจัยเหล่านี้เกิดขึ้นพร้อมกัน

โครงงานนี้จึงสร้างระบบที่วัดปัจจัยแวดล้อมหลายตัวพร้อมกันแบบต่อเนื่อง ควบคู่กับตัวชี้วัด
พฤติกรรมความจดจ่อจากกล้อง เพื่อให้เห็นความสัมพันธ์ในสภาพการใช้งานจริง

---

## 2.2 วิธีสืบค้นวรรณกรรม

การทบทวนนี้**ไม่ใช่การทบทวนอย่างเป็นระบบตามระเบียบวิธี PRISMA** แต่เป็นการสืบค้น
แบบมีเกณฑ์เพื่อหาหลักฐานที่ใช้กำหนดเกณฑ์เตือนของระบบ

| หัวข้อ | รายละเอียด |
|---|---|
| **คำค้น** | CO₂ / temperature / PM2.5 / noise / illuminance / TVOC **×** cognitive performance / concentration / office / classroom |
| **แหล่ง** | วารสารที่มีการทบทวนโดยผู้ทรงคุณวุฒิ — *Environmental Health Perspectives*, *Indoor Air*, *Building and Environment*, *Applied Acoustics*, *Environmental Research Letters*, *Scientific Reports* · รายงานจาก Lawrence Berkeley National Laboratory |
| **เกณฑ์คัดเข้า** | มีตัววัดสมรรถนะเชิงวัตถุวิสัย · ระบุระดับความเข้มข้น/ระดับที่ทดสอบชัดเจน · ให้ผลเชิงปริมาณที่นำมากำหนดเกณฑ์ได้ |
| **เกณฑ์คัดออก** | ใช้เฉพาะการประเมินตนเอง · ไม่ระบุระดับที่ทดสอบ · เป็นบทความทั่วไปที่ไม่มีข้อมูลปฐมภูมิ |
| **ให้น้ำหนักพิเศษ** | การทบทวนอย่างเป็นระบบและ meta-analysis · งานที่มีทั้งฝ่ายสนับสนุนและโต้แย้ง |

> **ข้อจำกัดที่ต้องระบุ:** การสืบค้นทำผ่านเครื่องมือค้นหาทั่วไป ไม่ได้ใช้ฐานข้อมูลเฉพาะทาง
> เช่น Scopus หรือ Web of Science จึงอาจมีงานวิจัยสำคัญที่ตกหล่น

---

## 2.3 ตารางสังเคราะห์งานวิจัย

| ตัวแปร | เซนเซอร์ | งานวิจัยหลัก | ระดับที่ทดสอบ | ผลที่พบ | ความแข็งของหลักฐาน |
|---|---|---|---|---|---|
| **CO₂** | SCD40 | Satish et al. (2012) | 600 · 1,000 · 2,500 ppm | ที่ 1,000 ppm แย่ลง 6/9 ด้าน · ที่ 2,500 ppm แย่ลง 7/9 ด้าน | 🟠 ปานกลาง — มีข้อโต้แย้ง |
| **CO₂ + การระบายอากาศ** | SCD40 | Allen et al. (2016) | Conventional vs Green vs Green+ | คะแนนสูงกว่า 61% และ 101% ตามลำดับ | 🟠 ปานกลาง |
| **อุณหภูมิ** | SCD40 | Seppänen et al. (2006) | 15–35 °C (รวม 24 งานวิจัย) | จุดสูงสุด 21.75 °C · ที่ 30 °C เหลือ 91.1% | 🟢 **แข็ง** |
| **PM2.5** | PMS7003 | Cedeño-Laurent et al. (2021) | 3.7 vs 18.0 µg/m³ | Stroop ช้าลง · throughput ลดลง | 🟢 **แข็ง** |
| **PM2.5** | PMS7003 | Shehab & Pope (2019) | เทียบก่อน-หลังสัมผัสฝุ่น | MMSE ลดลง · ความสนใจแบบเลือกเฟ้นช้าลง | 🟢 แข็ง |
| **เสียง** | ไมโครโฟน USB | Jahncke et al. (2011) | 39 vs 51 dB(A) | จำคำได้น้อยลง · เหนื่อยขึ้น · แรงจูงใจลดลง | 🟢 **แข็ง** |
| **แสง** | BH1750 | EN 12464-1 | มาตรฐาน 500 lx | เกณฑ์ความสว่างพื้นที่ทำงาน | 🟡 ปานกลาง (คนละหน่วยกับงานวิจัยล่าสุด) |
| **TVOC** | SGP30 | Mølhave (1987) · Nakaoka et al. (2014) | — | สัมพันธ์กับอาการ SBS รวมถึงปัญหาด้านการรับรู้ | 🟡 ปานกลาง |

---

## 2.4 คาร์บอนไดออกไซด์ (CO₂)

### 2.4.1 หลักฐานที่พบผลกระทบ

การศึกษาที่ถูกอ้างอิงมากที่สุดคือ Satish et al. (2012) ซึ่งดำเนินการที่ Lawrence Berkeley
National Laboratory ผู้เข้าร่วม 24 คนอยู่ในห้องจำลองสำนักงานครั้งละ 2.5 ชั่วโมง
ภายใต้ความเข้มข้น CO₂ สามระดับคือ 600, 1,000 และ 2,500 ppm วัดผลด้วยแบบทดสอบ
Strategic Management Simulation (SMS) ซึ่งประเมินการตัดสินใจ 9 ด้าน

ผลการศึกษาพบว่าที่ 1,000 ppm คะแนนลดลงอย่างมีนัยสำคัญใน 6 จาก 9 ด้าน และที่ 2,500 ppm
ลดลงมากใน 7 จาก 9 ด้าน โดยด้านที่ได้รับผลกระทบรุนแรงที่สุดคือ **การริเริ่ม (initiative)**
และ **การคิดเชิงกลยุทธ์ (strategic thinking)** ซึ่งถูกจัดอยู่ในระดับที่ผู้วิจัยเรียกว่า
"dysfunctional" (Satish et al., 2012)

Allen et al. (2016) ศึกษาต่อยอดในโครงการ COGfx โดยให้พนักงานออฟฟิศทำงานภายใต้
สภาพอาคารสามแบบ พบว่าคะแนนการทำงานของสมองในวัน Green สูงกว่าวัน Conventional
ร้อยละ 61 และในวัน Green+ ซึ่งเพิ่มอัตราการระบายอากาศ สูงกว่าถึงร้อยละ 101
(Allen et al., 2016)

ในสภาพการทำงานจริง Cedeño-Laurent et al. (2021) ติดตามพนักงานออฟฟิศหลายประเทศ
และพบว่าระดับ CO₂ และ PM2.5 ภายในอาคารที่สูงขึ้นสัมพันธ์กับสมรรถนะที่ลดลงในแบบทดสอบ
Stroop และ ADD ซึ่งเป็นหลักฐานจากสภาพแวดล้อมจริงไม่ใช่ห้องปฏิบัติการ

### 2.4.2 ⚠️ หลักฐานที่โต้แย้ง

Zhang et al. (2017) ออกแบบการทดลองแยกอิทธิพลของ **CO₂ บริสุทธิ์** ออกจาก **bioeffluents**
(สารที่ร่างกายมนุษย์ปล่อยออกมา) โดยเติม CO₂ บริสุทธิ์ให้ถึง 1,000 และ 3,000 ppm
เปรียบเทียบกับการลดอัตราระบายอากาศจนกระทั่ง CO₂ จาก bioeffluents ถึงระดับเดียวกัน
ผลชี้ว่าผลกระทบส่วนใหญ่อาจมาจาก bioeffluents ไม่ใช่ตัว CO₂ เอง

Du et al. (2020) ทบทวนวรรณกรรมอย่างวิพากษ์และสรุปว่าผลการศึกษาที่ผ่านมา
**ไม่สอดคล้องกัน** และหลายงานมีข้อจำกัดด้านระเบียบวิธี เช่น ขนาดกลุ่มตัวอย่างเล็ก
และการควบคุมตัวแปรแทรกซ้อนที่ไม่เพียงพอ

การทบทวนอย่างเป็นระบบและ meta-analysis (2023) ซึ่งรวม 15 งานวิจัยที่เข้าเกณฑ์
เปรียบเทียบกลุ่มควบคุม (< 1,000 ppm) กับสามช่วงความเข้มข้น สรุปว่า **CO₂ ที่ระดับต่ำกว่า
5,000 ppm ส่งผลต่อสมรรถนะการคิดจริง** โดย **งานที่ซับซ้อนได้รับผลกระทบมากกว่างานง่าย**
อย่างมีนัยสำคัญ

### 2.4.3 การตีความที่ใช้ในโครงงานนี้

โครงงานนี้ใช้ CO₂ เป็น **ตัวบ่งชี้คุณภาพการระบายอากาศ (ventilation proxy)**
มากกว่าจะถือว่าเป็นสารพิษโดยตรง เหตุผลคือเมื่อ CO₂ สะสมสูง แปลว่า bioeffluents
และมลพิษอื่นที่เกิดจากคนในห้องก็สะสมสูงตามไปด้วย การใช้ CO₂ กระตุ้นให้ระบายอากาศ
จึงสมเหตุสมผลไม่ว่ากลไกที่แท้จริงจะเป็นอย่างไร

**เกณฑ์ที่ใช้:**

| ระดับ | ppm | ที่มา |
|---|---|---|
| ดี | < 800 | ต่ำกว่าระดับที่ Satish et al. (2012) เริ่มพบผล |
| ปานกลาง | 800–1,000 | เข้าใกล้เกณฑ์วิกฤต |
| แย่ | 1,000–1,500 | Satish et al. (2012) พบผลชัดเจนที่ 1,000 ppm |
| แย่มาก | 1,500–2,500 | ช่วงที่ meta-analysis (2023) พบผลต่อเนื่อง |
| อันตราย | > 2,500 | Satish et al. (2012) — ระดับ "dysfunctional" |

---

## 2.5 อุณหภูมิ

Seppänen et al. (2006) รวบรวมและวิเคราะห์ 24 งานวิจัย (ภาคสนาม 11 งาน · ห้องปฏิบัติการ 9 งาน)
ที่ใช้ตัววัดสมรรถนะเชิงวัตถุวิสัย เช่น การประมวลผลข้อความ การคำนวณอย่างง่าย
และเวลาที่ใช้ต่อสายในศูนย์บริการลูกค้า จากนั้นคำนวณอัตราการเปลี่ยนแปลงสมรรถนะต่อองศา
และทำ regression ถ่วงน้ำหนักด้วยขนาดกลุ่มตัวอย่างและความเกี่ยวข้องของงาน

**ผลการศึกษา:**

- สมรรถนะเพิ่มขึ้นตามอุณหภูมิจนถึง **21–22 °C**
- สมรรถนะลดลงเมื่อเกิน **23–24 °C**
- จุดที่เส้นโค้งตัดแกนนอน (สมรรถนะสูงสุด) อยู่ที่ **21.75 °C**
- ที่ **30 °C** สมรรถนะเหลือ **ร้อยละ 91.1** ของค่าสูงสุด (ลดลงร้อยละ 8.9)
- การทบทวนก่อนหน้าพบว่าสมรรถนะลดลงราว **ร้อยละ 2 ต่อองศา** ในช่วง 25–32 °C

สมการความสัมพันธ์ที่ได้จากการถ่วงน้ำหนักแบบผสม:

```
P = 0.1647524·T − 0.0058274·T² + 0.0000623·T³ − 0.4685328

โดย  P = สมรรถนะเทียบกับค่าสูงสุด · T = อุณหภูมิห้อง (°C)
```

### ⚠️ ประเด็นที่ต้องยอมรับตรงไปตรงมา

เกณฑ์ "สบาย" ที่โครงงานนี้ใช้ (`THRESHOLDS.temp.okLo = 20`, `okHi = 28`)
**กว้างกว่าช่วงที่ให้สมรรถนะสูงสุดตามงานวิจัยอย่างมาก** — เมื่อแทน T = 28 ลงในสมการข้างต้น
จะพบว่าสมรรถนะลดลงไปแล้วราวร้อยละ 3–5

**เหตุผลที่ยังคงเกณฑ์เดิมไว้:**

1. ในบริบทภูมิอากาศไทย การตั้งเกณฑ์แคบที่ 21–24 °C จะทำให้ระบบแจ้งเตือนเกือบตลอดเวลา
   จนผู้ใช้เพิกเฉย (alarm fatigue)
2. การรักษาอุณหภูมิห้องที่ 22 °C ตลอดเวลามีต้นทุนพลังงานสูงมาก

**ข้อเสนอสำหรับการพัฒนาต่อ:** แยกการแสดงผลเป็นสองระดับ — "ช่วงสบาย" (กว้าง)
และ "ช่วงสมรรถนะสูงสุด" (21–24 °C) แล้วแสดงทั้งสองค่าบนแดชบอร์ดพร้อมกัน

---

## 2.6 ฝุ่นละอองขนาดเล็ก (PM2.5)

Cedeño-Laurent et al. (2021) ศึกษาพนักงานออฟฟิศหลายประเทศแบบติดตามระยะยาว
ในสถานที่ทำงานจริง พบว่าระดับ PM2.5 ภายในอาคารที่สูงขึ้นสัมพันธ์กับเวลาตอบสนอง
ในแบบทดสอบ Stroop ที่ช้าลงและ throughput ที่ลดลง ที่สำคัญคือเมื่อใช้เครื่องฟอกอากาศ
ลด PM2.5 จาก **18.0 µg/m³ เหลือ 3.7 µg/m³** สมรรถนะบางด้านดีขึ้นอย่างมีนัยสำคัญ

Shehab และ Pope (2019) ใช้การทดลองแบบ double cross-over พบว่าหลังสัมผัสฝุ่น
จากการจุดเทียนและจากการเดินทางกลางแจ้ง คะแนน MMSE ลดลงอย่างมีนัยสำคัญทางสถิติ
และความเร็วในการตรวจจับอัตโนมัติจากแบบทดสอบ Ruff 2 & 7 ซึ่งวัดความสนใจแบบเลือกเฟ้น
ลดลงเช่นกัน

> 🔑 **ข้อค้นพบที่สำคัญที่สุดสำหรับโครงงานนี้:** ตัวเลข 3.7 เทียบกับ 18.0 µg/m³
> แสดงว่าผลกระทบเกิดขึ้นที่ระดับ**ต่ำกว่ามาตรฐานของประเทศไทย (37.5 µg/m³) มาก**
> กล่าวคือไม่จำเป็นต้องรอให้ถึงระดับที่ประกาศว่า "มีผลต่อสุขภาพ" จึงจะเห็นผลต่อสมรรถนะ

**เกณฑ์ที่ใช้:**

| ระดับ | µg/m³ | ที่มา |
|---|---|---|
| ดีมาก | 0–15 | WHO Air Quality Guideline (2021), ค่าเฉลี่ย 24 ชั่วโมง |
| ดี | 15–25 | WHO interim target 4 |
| ปานกลาง | 25–37.5 | มาตรฐานประเทศไทย 24 ชั่วโมง (บังคับใช้ 1 มิถุนายน 2566) |
| เริ่มมีผลต่อสุขภาพ | 37.5–75 | WHO interim target 1 |

> ⚠️ **ข้อควรระวังเชิงระเบียบวิธี:** มาตรฐานเหล่านี้เป็นค่าเฉลี่ย 24 ชั่วโมงในบรรยากาศทั่วไป
> ไม่ใช่ค่าชั่วขณะภายในอาคาร ระบบนี้จึงใช้**ค่าเฉลี่ยเคลื่อนที่ 1 ชั่วโมง**ในการตัดสินระดับเตือน
> เพื่อไม่ให้แจ้งเตือนบ่อยเกินจริงจากค่าที่กระโดดชั่วขณะ เช่น ตอนจุดธูปหรือทำอาหาร

---

## 2.7 เสียงรบกวน

Jahncke et al. (2011) ให้ผู้เข้าร่วมทำงานเป็นเวลา 2 ชั่วโมงในสำนักงานแบบเปิดจำลอง
ภายใต้เสียงรบกวนสองระดับคือ 39 และ 51 dB(A) พบว่าเมื่ออยู่ในสภาพเสียงสูง ผู้เข้าร่วม
**จำคำได้น้อยลง ประเมินตนเองว่าเหนื่อยมากขึ้น และมีแรงจูงใจในการทำงานน้อยลง**
โดยสมรรถนะลดลงทั้งในงานที่ใช้ความจำและงานที่ไม่ใช้ความจำ

Jahncke et al. (2013) ศึกษาต่อและพบว่างานที่อาศัยความจำระยะสั้นแบบ episodic
และการทวนซ้ำข้อมูลมีความไวต่อการรบกวนจากเสียงพูดมากกว่างานประเภทอื่น

### กลไก: Irrelevant Speech Effect

เสียงพูดที่ไม่เกี่ยวข้องกับงานถูกสมองประมวลผลความหมาย**โดยอัตโนมัติและห้ามไม่ได้**
กระบวนการนี้ไปแย่งทรัพยากรที่ใช้ในการทวนซ้ำข้อมูลในความจำใช้งาน (working memory)
จึงทำให้สมรรถนะลดลงแม้ระดับเสียงจะไม่สูงมาก

> **51 dB(A) ไม่ถือว่าเป็นเสียงดัง** — เป็นระดับของสำนักงานทั่วไป
> แต่ก็เพียงพอที่จะลดสมรรถนะได้แล้ว เกณฑ์ 60 dB ที่โครงงานนี้ใช้จึงเป็นเกณฑ์ที่**ผ่อนปรน**
> กว่าระดับที่งานวิจัยพบผลเสียเสียอีก

**ข้อจำกัดของการวัดในโครงงานนี้:** ไมโครโฟน USB วัดได้เพียงระดับความดัง
แต่**แยกไม่ได้ว่าเป็นเสียงพูดหรือเสียงคงที่** ทั้งที่งานวิจัยชี้ชัดว่าเสียงพูดรบกวน
มากกว่าเสียงคงที่ที่ระดับความดังเท่ากัน

---

## 2.8 แสงสว่าง

มาตรฐาน EN 12464-1 กำหนดความสว่างบนพื้นที่ทำงานสำหรับงานอ่าน เขียน พิมพ์
และประมวลผลข้อมูลไว้ที่ **500 lx** และสูงถึง 750 lx สำหรับงานเขียนแบบเทคนิค

อย่างไรก็ตาม งานวิจัยด้านความตื่นตัวและนาฬิกาชีวภาพในระยะหลังใช้หน่วย
**melanopic Equivalent Daylight Illuminance (mel-EDI)** แทน photopic lux
เนื่องจากเซลล์รับแสงชนิด melanopsin ในจอตาซึ่งควบคุมความตื่นตัวตอบสนองต่อสเปกตรัมแสง
ต่างจากเซลล์ที่ใช้ในการมองเห็น คำแนะนำปัจจุบันคือควรได้รับแสงอย่างน้อย
**250 lx mel-EDI** ในเวลากลางวัน

### ⚠️ ข้อจำกัดเชิงหน่วยวัด

**BH1750 วัดได้เฉพาะ photopic lux** และไม่สามารถแปลงเป็น mel-EDI ได้
เพราะการแปลงต้องทราบสเปกตรัมของแหล่งกำเนิดแสง หลอด LED สีขาวเย็น (6500 K)
กับสีขาวอุ่น (2700 K) ที่ให้ค่า lux เท่ากันอาจมีค่า mel-EDI ต่างกันได้เกินเท่าตัว

> **ขอบเขตที่ระบบนี้ตอบได้:** "แสงเพียงพอต่อการมองเห็นตามมาตรฐานหรือไม่"
> **ขอบเขตที่ตอบไม่ได้:** "แสงเหมาะสมต่อการกระตุ้นความตื่นตัวหรือไม่"
> การพัฒนาต่อควรใช้เซนเซอร์ที่วัดสเปกตรัมได้ เช่น AS7341 หรือ TCS34725

**เกณฑ์ที่ใช้:**

| ระดับ | lux | ที่มา |
|---|---|---|
| พอดี | 300–500 | EN 12464-1 — งานอ่าน เขียน พิมพ์ |
| สลัว | 150–300 | ต่ำกว่ามาตรฐานงานสำนักงาน |
| มืด | < 150 | ต่ำกว่า ~100 lx ระบบตรวจจับใบหน้าเริ่มทำงานไม่ได้ |

---

## 2.9 สารอินทรีย์ระเหยง่ายรวม (TVOC)

Mølhave (1987) เป็นผู้วางนิยามอาการ Sick Building Syndrome (SBS) โดยระบุว่า
อาการระคายเคืองทางประสาทสัมผัสต้องเป็นอาการเด่น อาการหลักที่พบประกอบด้วย
**อ่อนเพลีย ระคายเคืองเยื่อเมือก ผิวหนังและตา ปวดศีรษะ เจ็บคอ ไอแห้ง ล้า
และปัญหาด้านการรับรู้ (cognitive problems)**

Nakaoka et al. (2014) ศึกษาความสัมพันธ์ระหว่างอาการ SBS กับความเข้มข้นของ VOC
ภายในอาคารและกลิ่น และพบความสัมพันธ์ที่มีนัยสำคัญ

Allen et al. (2016) เป็นหนึ่งในไม่กี่งานที่วัด TVOC ควบคู่กับคะแนนการทำงานของสมองโดยตรง
ดังปรากฏในชื่อเต็มของงานที่ระบุ "Ventilation, and Volatile Organic Compound Exposures"

### ⚠️ ข้อจำกัดของ SGP30

1. ค่า TVOC เป็น**สัญญาณเชิงเปรียบเทียบ ไม่ใช่ความเข้มข้นสัมบูรณ์** เพราะใช้
   dynamic baseline ที่ปรับตัวตามสภาพแวดล้อม
2. **แยกชนิดสารไม่ได้** — น้ำหอมกับฟอร์มาลดีไฮด์ให้สัญญาณคล้ายกันทั้งที่อันตรายต่างกันมาก
3. ค่า **eCO₂ ไม่ใช่ CO₂** เป็นค่าประมาณที่คำนวณจากสัญญาณ VOC จึงไม่ควรใช้แทน SCD40

**เกณฑ์ที่ใช้** อ้างอิงแนวทางของหน่วยงานสิ่งแวดล้อมเยอรมนี (Umweltbundesamt)
ซึ่งเป็นเกณฑ์ TVOC ที่ถูกอ้างอิงแพร่หลายที่สุด: ดีเยี่ยม 0–65 ppb · ดี 65–220 ppb ·
ปานกลาง 220–660 ppb · แย่ 660–2,200 ppb

---

## 2.10 ช่องว่างของงานวิจัย (Research Gap)

จากการทบทวนวรรณกรรมข้างต้น พบช่องว่างสำคัญสี่ประการ

| # | ช่องว่าง | รายละเอียด | โครงงานนี้ตอบสนองอย่างไร |
|---|---|---|---|
| **1** | **ศึกษาทีละตัวแปร** | งานวิจัยส่วนใหญ่ควบคุมตัวแปรอื่นให้คงที่แล้วเปลี่ยนทีละตัวในห้องปฏิบัติการ แต่สภาพจริงตัวแปรเกิดพร้อมกันและอาจเสริมกัน เช่น CO₂ สูงมักมาพร้อมอุณหภูมิสูง | วัด 8 ค่าพร้อมกันแบบต่อเนื่องทุก 5 วินาที |
| **2** | **วัดสมรรถนะเป็นครั้งคราว** | ต้องหยุดให้ผู้เข้าร่วมทำแบบทดสอบ ซึ่งรบกวนงานจริงและได้ข้อมูลเป็นจุด ๆ | ใช้ตัวชี้วัดพฤติกรรมจากกล้อง (EAR · อัตราการกะพริบ · การหันหน้า) ที่วัดต่อเนื่องโดยไม่รบกวน |
| **3** | **บริบทเขตอบอุ่น** | งานวิจัยส่วนใหญ่ทำในยุโรปและอเมริกาเหนือ เกณฑ์อุณหภูมิและการระบายอากาศจึงอาจไม่ตรงกับภูมิอากาศร้อนชื้นและฤดูฝุ่นของไทย | เก็บข้อมูลในบริบทไทย พร้อมเชื่อมข้อมูลจากกรมอุตุนิยมวิทยาและกรมควบคุมมลพิษ |
| **4** | **ต้นทุนสูง** | เครื่องมือวัดระดับงานวิจัยมีราคาสูงมาก ทำให้ทำซ้ำในโรงเรียนหรือบ้านได้ยาก | ใช้เซนเซอร์ราคาเข้าถึงได้ (~3,400–5,500 บาท) พร้อมเอกสารและโค้ดที่ทำซ้ำได้ |

---

## 2.11 กรอบแนวคิดการวิจัย (Conceptual Framework)

### ตัวแปรต้น — สภาพแวดล้อม (วัดทุก 5 วินาที)

| กลุ่ม | ตัวแปร | หน่วย | เซนเซอร์ |
|---|---|---|---|
| **คุณภาพอากาศ** | CO₂ | ppm | SCD40 |
| | PM1.0 · PM2.5 · PM10 | µg/m³ | PMS7003 |
| | TVOC | ppb | SGP30 |
| **สภาวะทางกายภาพ** | อุณหภูมิ | °C | SCD40 |
| | ความชื้นสัมพัทธ์ | %RH | SCD40 |
| | ความสว่าง | lx | BH1750 |
| | ระดับเสียง | dB | ไมโครโฟน USB |

**↓ ตัวแปรควบคุมที่ต้องบันทึกควบคู่:** ช่วงเวลาของวัน · จำนวนคนในห้อง · ประเภทงานที่ทำ

### ตัวแปรตาม — พฤติกรรมความจดจ่อ (สรุปทุก 15 วินาที)

| ตัวแปร | หน่วย | ที่มา | ตีความอย่างไร |
|---|---|---|---|
| อัตราการหันหน้า | ครั้ง/นาที | กล้อง + MediaPipe | สูง = เสียสมาธิบ่อย |
| Eye Aspect Ratio (EAR) | สัดส่วน | กล้อง + MediaPipe | ต่ำ = ตาปรือ/ง่วง |
| อัตราการกะพริบตา | ครั้ง/นาที | กล้อง + MediaPipe | นอกช่วง 8–21 = ผิดปกติ |
| ระยะเวลาหลับตาต่อเนื่อง | วินาที | กล้อง + MediaPipe | > 1.2 วินาที = ง่วง |

> ⚠️ **ความสัมพันธ์ระหว่างสองกลุ่มนี้เป็นเพียง "ความสัมพันธ์ที่ตั้งสมมติฐาน"**
> การออกแบบเชิงสังเกตแบบนี้**ยืนยันความสัมพันธ์เชิงสาเหตุไม่ได้**
> การจะสรุปว่าเป็นเหตุเป็นผลต้องออกแบบการทดลองที่มีการสุ่มและกลุ่มควบคุม

---

## 2.12 สมมติฐานการวิจัย

สมมติฐานต่อไปนี้**ทดสอบได้ทางสถิติ**จากข้อมูลที่ระบบเก็บได้ หากขยายโครงงานเป็นงานวิจัยเต็มรูปแบบ

| สมมติฐาน | ข้อความ | ฐานจากวรรณกรรม | วิธีทดสอบที่เสนอ |
|---|---|---|---|
| **H1** | เมื่อ CO₂ เกิน 1,000 ppm อัตราการหันหน้าต่อนาทีจะสูงกว่าช่วงที่ CO₂ ต่ำกว่า 800 ppm อย่างมีนัยสำคัญ | Satish et al. (2012) · meta-analysis (2023) | เปรียบเทียบค่าเฉลี่ยสองกลุ่มด้วย independent t-test หรือ Mann–Whitney U |
| **H2** | อุณหภูมิที่สูงกว่า 26 °C สัมพันธ์กับอัตราการหันหน้าที่สูงขึ้น โดยความสัมพันธ์เป็นแบบไม่เชิงเส้น | Seppänen et al. (2006) | Polynomial regression กำลังสอง เทียบกับ linear model ด้วยค่า R² |
| **H3** | ระดับเสียงเกิน 55 dB สัมพันธ์กับอัตราการหันหน้าที่สูงขึ้นภายในหน้าต่างเวลา 15 วินาทีถัดไป | Jahncke et al. (2011) | Cross-correlation แบบมี time lag |
| **H4** | ความสว่างต่ำกว่า 300 lx สัมพันธ์กับค่า EAR เฉลี่ยที่ต่ำลง (สัญญาณความง่วง) | EN 12464-1 · งานวิจัย mel-EDI | Pearson correlation พร้อมควบคุมช่วงเวลาของวัน |
| **H5** | เมื่อรวมตัวแปรแวดล้อมหลายตัวเข้าด้วยกัน จะทำนายอัตราการหันหน้าได้ดีกว่าใช้ตัวแปรเดียว | ช่องว่างงานวิจัยข้อ 1 | Multiple regression เทียบ adjusted R² กับ simple regression |

> **ขนาดตัวอย่างขั้นต่ำที่แนะนำ:** เก็บข้อมูลต่อเนื่องอย่างน้อย 14 วัน ครอบคลุมทั้งวันทำงาน
> และวันหยุด เพื่อให้มีความแปรปรวนของสภาพแวดล้อมเพียงพอต่อการวิเคราะห์

---

## 2.13 ข้อจำกัดของโครงงาน

| ข้อจำกัด | รายละเอียด | ผลต่อการตีความ |
|---|---|---|
| **ความสัมพันธ์ ≠ สาเหตุ** | เป็นการศึกษาเชิงสังเกต ไม่มีการสุ่มและไม่มีกลุ่มควบคุม | สรุปได้เพียงว่า "สัมพันธ์กัน" ไม่ใช่ "เป็นสาเหตุ" |
| **ตัวชี้วัดเป็น proxy** | EAR และการหันหน้าเป็นตัวแทนของความจดจ่อ ไม่ใช่การวัดสมรรถนะการคิดโดยตรง | ต้องเพิ่มแบบทดสอบ เช่น Stroop test จึงจะเทียบกับงานวิจัยที่อ้างอิงได้โดยตรง |
| **กลุ่มตัวอย่างเล็ก** | ใช้กับผู้ใช้จำนวนน้อย | สรุปเป็นข้อค้นพบทั่วไปไม่ได้ |
| **ไม่มีเครื่องมืออ้างอิง** | ไม่ได้สอบเทียบกับเครื่องมือมาตรฐาน | ควรเทียบกับสถานีตรวจวัดของกรมควบคุมมลพิษที่ใกล้ที่สุดเป็นอย่างน้อย |
| **หน่วยแสงไม่ตรงกับงานวิจัยล่าสุด** | วัด photopic lux ไม่ใช่ melanopic EDI | ข้อสรุปเรื่องแสงกับความตื่นตัวทำได้จำกัด |
| **แยกประเภทเสียงไม่ได้** | วัดเฉพาะระดับ dB | ไม่สามารถแยกผลของ irrelevant speech ออกจากเสียงคงที่ |
| **หลักฐาน CO₂ ยังถกเถียง** | ดูหัวข้อ 2.4.2 | ควรนำเสนอ CO₂ ในฐานะตัวบ่งชี้การระบายอากาศ |

---

## 2.14 รายการอ้างอิง

| # | รายการ |
|---|---|
| 1 | Allen, J. G., MacNaughton, P., Satish, U., Santanam, S., Vallarino, J., & Spengler, J. D. (2016). Associations of cognitive function scores with carbon dioxide, ventilation, and volatile organic compound exposures in office workers: A controlled exposure study of green and conventional office environments. *Environmental Health Perspectives, 124*(6), 805–812. |
| 2 | Cedeño-Laurent, J. G., Williams, A., MacNaughton, P., Cao, X., Eitland, E., Spengler, J., & Allen, J. (2021). Associations between acute exposures to PM2.5 and carbon dioxide indoors and cognitive function in office workers: A multicountry longitudinal prospective observational study. *Environmental Research Letters.* |
| 3 | Du, B., Tandoc, M. C., Mack, M. L., & Siegel, J. A. (2020). Indoor CO₂ concentrations and cognitive function: A critical review. *Indoor Air.* |
| 4 | European Committee for Standardization. *EN 12464-1: Light and lighting — Lighting of work places — Part 1: Indoor work places.* |
| 5 | Jahncke, H., Hongisto, V., & Virjonen, P. (2013). Cognitive performance during irrelevant speech: Effects of speech intelligibility and office-task characteristics. *Applied Acoustics.* |
| 6 | Jahncke, H., Hygge, S., Halin, N., Green, A. M., & Dimberg, K. (2011). Open-plan office noise: Cognitive performance and restoration. *Journal of Environmental Psychology.* |
| 7 | Mølhave, L. (1987). The sick buildings — A sub-population among the problem buildings? *Indoor Air.* |
| 8 | Nakaoka, H., Todaka, E., Seto, H., Saito, I., Hanazato, M., Watanabe, M., & Mori, C. (2014). Correlating the symptoms of sick-building syndrome to indoor VOCs concentration levels and odour. *Indoor and Built Environment.* |
| 9 | Satish, U., Mendell, M. J., Shekhar, K., Hotchi, T., Sullivan, D., Streufert, S., & Fisk, W. J. (2012). Is CO₂ an indoor pollutant? Direct effects of low-to-moderate CO₂ concentrations on human decision-making performance. *Environmental Health Perspectives.* |
| 10 | Seppänen, O., Fisk, W. J., & Lei, Q. H. (2006). *Room temperature and productivity in office work* (LBNL-60952). Lawrence Berkeley National Laboratory. |
| 11 | Shehab, M. A., & Pope, F. D. (2019). Effects of short-term exposure to particulate matter air pollution on cognitive performance. *Scientific Reports.* |
| 12 | Zhang, X., Wargocki, P., Lian, Z., & Thyregod, C. (2017). Effects of exposure to carbon dioxide and bioeffluents on perceived air quality, self-assessed acute health symptoms, and cognitive performance. *Indoor Air.* |
| 13 | *Short-term exposure to indoor carbon dioxide and cognitive task performance: A systematic review and meta-analysis.* (2023). *Building and Environment.* |
| 14 | World Health Organization. (2021). *WHO global air quality guidelines.* |
| 15 | คณะกรรมการสิ่งแวดล้อมแห่งชาติ. (2566). *ประกาศเรื่อง กำหนดมาตรฐานฝุ่นละอองขนาดไม่เกิน 2.5 ไมครอน ในบรรยากาศโดยทั่วไป* (บังคับใช้ 1 มิถุนายน 2566). |
| 16 | กรมควบคุมมลพิษ. (2566). *ประกาศดัชนีคุณภาพอากาศของประเทศไทย พ.ศ. 2566.* |

> ⚠️ **ก่อนส่งรายงานฉบับจริง**
>
> 1. **เปิดเปเปอร์ต้นฉบับอ่านเองอย่างน้อยรายการที่ 1, 6, 9 และ 10** — เป็นงานที่ใช้อ้างเกณฑ์โดยตรง
>    และกรรมการมักถามรายละเอียดระเบียบวิธี
> 2. **เติมเลขเล่ม เลขฉบับ เลขหน้า และ DOI ให้ครบ** — รายการที่ยังไม่มีข้อมูลครบ
>    (2, 3, 5, 6, 7, 8, 9, 11, 12, 13) ต้องเปิดจากวารสารต้นทางเพื่อเติม
> 3. **ตรวจรูปแบบให้ตรงกับที่สถาบันกำหนด** — บทนี้ใช้ APA 7 หากสถาบันใช้ IEEE
>    ต้องแปลงเป็นเลขในวงเล็บเหลี่ยมและเรียงตามลำดับการอ้างถึง
