Randomperson123324/enviroment-monitor/docs/02-wiring.md

# 02 — การต่อสายและ pinout

[← กลับสารบัญ](README.md)

---

## 1. ตาราง pinout รวม (Raspberry Pi 5 — หัวต่อ 40 ขา)

ขาที่ใช้ทั้งหมด เรียงตามหมายเลขขาจริงบนบอร์ด:

| ขา | ชื่อสัญญาณ | ต่อไปที่ | อุปกรณ์ | หมายเหตุ |
|---|---|---|---|---|
| 1 | 3V3 | VCC | SCD40 · BH1750 · ADS1115 | ⚠️ SCD40 **ห้ามใช้ 5V** |
| 2 | 5V | VIN | SGP30 breakout *(หรือ 3V3 ก็ได้)* | breakout มี LDO ในตัว |
| 3 | GPIO2 / SDA1 | SDA | อุปกรณ์ I2C ทุกตัว | บัสเดียวใช้ร่วมกัน |
| 4 | 5V | VCC (ขา 1, 2) | PMS7003 | พัดลมต้องการ 5V |
| 5 | GPIO3 / SCL1 | SCL | อุปกรณ์ I2C ทุกตัว | บัสเดียวใช้ร่วมกัน |
| 6 | GND | GND | กราวด์รวม | |
| 8 | GPIO14 / TXD0 | **RX** (ขา 7) | PMS7003 | ไขว้กัน: TX ของ Pi → RX ของเซนเซอร์ |
| 9 | GND | GND (ขา 3, 4) | PMS7003 | |
| 10 | GPIO15 / RXD0 | **TX** (ขา 9) | PMS7003 | ไขว้กัน: RX ของ Pi → TX ของเซนเซอร์ |
| 11 | GPIO17 | SET (ขา 10) | PMS7003 | *ทางเลือก* — ใช้สั่ง sleep/wake |
| 13 | GPIO27 | RESET (ขา 5) | PMS7003 | *ทางเลือก* — active low |
| 14 | GND | GND | SGP30 · BH1750 | |
| 17 | 3V3 | VDD | *สำรอง* | |
| 20 | GND | GND | SCD40 · ADS1115 | |
| 25 | GND | GND | MQ-2 · กราวด์อนาล็อก | แยกทางเดินกราวด์อนาล็อกออกจากดิจิทัลถ้าทำได้ |
| 34 | GND | GND | *สำรอง* | |

**ขาที่ต้องเว้นไว้ ห้ามใช้:**

- ขา 27, 28 (GPIO0 / GPIO1, `ID_SD`/`ID_SC`) — สงวนสำหรับ HAT EEPROM
- ขา 12 (GPIO18) — ถ้าอนาคตจะเพิ่มไมค์ I2S ต้องใช้ขานี้เป็น BCLK
- ขา 19, 21, 23 (SPI0) — เว้นไว้เผื่อจอ/อุปกรณ์ SPI

### ตรวจว่าไม่มี pin ชนกัน

| ขา | ใช้โดย | ชนไหม |
|---|---|---|
| GPIO2, GPIO3 | I2C-1 (SCD40, SGP30, BH1750, ADS1115) | ✅ ไม่ชน — I2C แชร์บัสได้ตราบใดที่ address ต่างกัน |
| GPIO14, GPIO15 | UART0 (PMS7003) | ✅ ไม่ชน — ไม่มีอุปกรณ์อื่นใช้ UART |
| GPIO17, GPIO27 | PMS7003 SET / RESET (ทางเลือก) | ✅ ไม่ชน — GPIO ธรรมดา ไม่มี alt function ที่ใช้อยู่ |
| USB | ไมโครโฟน (+ webcam ถ้าใช้ USB) | ✅ ไม่ชน — ดูงบกระแส USB ใน [03-power-budget.md](03-power-budget.md) |
| CSI-2 | Camera Module 3 (ถ้าใช้) | ✅ ไม่ชน — ขั้วต่อแยกต่างหาก |

---

## 2. ตารางที่อยู่ I2C

| ที่อยู่ | อุปกรณ์ | ตั้งค่าได้ไหม | หมายเหตุ |
|---|---|---|---|
| `0x23` | BH1750 | ✅ → `0x5C` ถ้าดึง ADDR ขึ้น HIGH | ค่าเริ่มต้นคือ ADDR ต่อลง GND หรือปล่อยลอย |
| `0x48` | ADS1115 | ✅ → `0x49` / `0x4A` / `0x4B` | ต่อขา ADDR ไป GND / VDD / SDA / SCL ตามลำดับ |
| `0x58` | SGP30 | ❌ ตายตัว | |
| `0x62` | SCD40 | ❌ ตายตัว | |

**ไม่มีที่อยู่ชนกัน** — บัสเดียวรองรับได้ทั้งหมด

ตรวจสอบหลังต่อสายเสร็จ:

```bash
sudo apt install -y i2c-tools
i2cdetect -y 1
```

ผลลัพธ์ที่ถูกต้องต้องเห็นครบทั้ง 4 ที่อยู่:

```
     0  1  2  3  4  5  6  7  8  9  a  b  c  d  e  f
20: -- -- -- 23 -- -- -- -- -- -- -- -- -- -- -- --
40: -- -- -- -- -- -- -- -- 48 -- -- -- -- -- -- --
50: -- -- -- -- -- -- -- -- 58 -- -- -- -- -- -- --
60: -- 62 -- -- -- -- -- -- -- -- -- -- -- -- -- --
```

> ถ้าเจอไม่ครบ ให้ตรวจตามลำดับ: กราวด์ร่วมกันหรือยัง → ไฟเลี้ยงถูกรางไหม → สาย SDA/SCL สลับกันหรือเปล่า → ตัวต้านทาน pull-up

---

## 3. ตัวต้านทาน pull-up ของบัส I2C

Raspberry Pi มี pull-up **1.8 kΩ** ไปที่ 3.3V บนขา SDA/SCL อยู่แล้วบนบอร์ด
และบอร์ด breakout ส่วนใหญ่ (SCD40, SGP30, BH1750, ADS1115) **ก็มี pull-up ของตัวเองมาให้อีก**
โดยทั่วไป 10 kΩ ต่อบอร์ด (บางรุ่น เช่น GY-302 บางล็อต ใช้ 4.7 kΩ)

เมื่อต่อครบทั้ง 4 บอร์ด ตัวต้านทานทุกตัวจะขนานกันบนสายเดียวกัน:

```
R_รวม = 1 / (1/1.8k + 1/10k + 1/10k + 1/10k + 1/10k)
      = 1 / (0.556 + 0.400)  mS
      ≈ 1.05 kΩ

กระแสซิงก์ = 3.3V / 1.05 kΩ ≈ 3.1 mA
```

### ⚠️ 3.1 mA เกินเงื่อนไขทดสอบใน datasheet

| อุปกรณ์ | เงื่อนไข V<sub>OL</sub> ที่ระบุใน datasheet |
|---|---|
| SGP30 | V<sub>OL</sub> ≤ 0.2 × VDD ที่กระแสซิงก์ **2 mA** |
| SCD40 | V<sub>OL</sub> ≤ 0.66V ที่กระแสซิงก์ **3 mA** |

ที่ 3.1 mA เซนเซอร์ยังดึงสายลงได้ แต่ V<sub>OL</sub> จะสูงกว่าที่ระบุไว้ ทำให้ **margin ลดลง**
ในทางปฏิบัติมักยังทำงานได้ แต่จะเปราะต่อสายยาวและสัญญาณรบกวน

### สิ่งที่ควรทำ

| กรณี | ทำอย่างไร |
|---|---|
| ต่อครบ 4 บอร์ด สายสั้น (< 15 cm) | ✅ ลองใช้เลย · ตรวจด้วย `i2cdetect` ซ้ำหลายรอบ |
| ต่อครบ 4 บอร์ด สายยาว หรือเจออุปกรณ์ไม่ครบเป็นบางครั้ง | 🔧 **ถอด pull-up ออกจากบอร์ด 2–3 ตัว** (บัดกรีออกหรือตัดรอย) เหลือไว้ 1 ตัว |
| ถอด pull-up ไม่ได้ | ลดความเร็วบัสเป็น 50 kHz + ลดความยาวสาย |
| ตัดสินใจไม่ใช้ MQ-2 (ไม่มี ADS1115) | เหลือ 3 บอร์ด → R_รวม ≈ 1.17 kΩ · 2.8 mA — ดีขึ้นเล็กน้อย |

> 💡 **จุดที่ควรตรวจก่อนประกอบจริง:** วัดความต้านทานระหว่าง SDA กับ 3V3 ด้วยมัลติมิเตอร์
> ขณะยังไม่จ่ายไฟ **ควรได้ไม่ต่ำกว่า ~1.5 kΩ** ถ้าต่ำกว่านั้นแปลว่ามี pull-up มากเกินไป
> ให้ถอดออกจากบอร์ดบางตัว

---

## 4. เปิดใช้งานบัส

แก้ไฟล์ `/boot/firmware/config.txt`

```ini
# ── I2C-1 บน GPIO2/GPIO3 ─────────────────────────────
# 100 kHz คือ standard mode — เสถียรที่สุดสำหรับสายยาวและอุปกรณ์หลายตัว
# ทุกตัวรองรับ 400 kHz แต่ไม่มีเหตุผลต้องเร่ง เพราะข้อมูลน้อยมาก
dtparam=i2c_arm=on
dtparam=i2c_arm_baudrate=100000

# ── UART0 บน GPIO14/GPIO15 สำหรับ PMS7003 ────────────
# บน Pi 5 ต้องใช้ dtparam=uart0 เพื่อ map ttyAMA0 มาที่ GPIO14/15
# (ต่างจาก Pi รุ่นก่อนที่ ttyAMA0 อยู่ที่ขานี้อยู่แล้ว)
dtparam=uart0=on

# ── ปิด Bluetooth ถ้าไม่ได้ใช้ (ลด IRQ รบกวน UART) ────
# dtoverlay=disable-bt
```

จากนั้นปิด serial console ไม่ให้ยึด `/dev/ttyAMA0`:

```bash
sudo raspi-config nonint do_serial_hw 0   # เปิด serial hardware
sudo raspi-config nonint do_serial_cons 1 # ปิด serial console (login shell)
sudo reboot
```

ตรวจสอบหลังรีบูต:

```bash
ls -l /dev/i2c-1 /dev/ttyAMA0
groups $USER | grep -E 'i2c|dialout|audio'   # ต้องเห็นครบทั้งสามกลุ่ม
```

ถ้ายังไม่อยู่ในกลุ่ม:

```bash
sudo usermod -aG i2c,dialout,audio,video $USER
# ต้อง logout/login ใหม่ถึงจะมีผล
```

> **หมายเหตุ Pi 5:** ขั้วต่อ debug UART 3 ขาที่อยู่ข้างพอร์ต USB-C เป็นคนละตัวกับ UART0 บน GPIO14/15
> การเปิด serial console จาก `raspi-config` บน Pi 5 จะไปเปิดที่ขั้วต่อ debug นั้น ไม่ใช่ที่ขา GPIO
> ดังนั้นถ้าอยากได้ console ไว้ debug ก็ยังใช้ขั้วต่อนั้นได้พร้อมกับ PMS7003 บน GPIO14/15

---

## 5. ผังต่อสายรายอุปกรณ์

### 5.1 PMS7003 (UART)

| PMS7003 | ชื่อ | → Pi 5 (ขา) | หมายเหตุ |
|---|---|---|---|
| 1, 2 | VCC | 5V (ขา 4) | ต่อทั้งสองขา — พัดลมกินกระแสสูง |
| 3, 4 | GND | GND (ขา 9) | ต่อทั้งสองขา |
| 5 | RESET | GPIO27 (ขา 13) *ทางเลือก* | active low · มี pull-up ในตัว ปล่อยลอยได้ |
| 6 | NC | — | **ห้ามต่อ** |
| 7 | RX | GPIO14 / TXD (ขา 8) | |
| 8 | NC | — | **ห้ามต่อ** |
| 9 | TX | GPIO15 / RXD (ขา 10) | |
| 10 | SET | GPIO17 (ขา 11) *ทางเลือก* | HIGH หรือปล่อยลอย = ทำงานปกติ · LOW = sleep |

> ✅ **ไม่ต้องใช้ level shifter** — datasheet ระบุลอจิกเป็น 3.3V (L < 0.8V, H > 2.7V) ตรงกับ Pi พอดี
> level shifter จำเป็นเฉพาะกรณีต่อกับ MCU ที่ใช้ไฟ 5V เท่านั้น

### 5.2 อุปกรณ์ I2C ทุกตัว

| อุปกรณ์ | VCC | GND | SDA | SCL | ขาอื่น |
|---|---|---|---|---|---|
| SCD40 | **3V3** (ขา 1) | ขา 20 | ขา 3 | ขา 5 | — |
| SGP30 breakout | 3V3 หรือ 5V (ขา 2) | ขา 14 | ขา 3 | ขา 5 | — |
| BH1750 | 3V3 (ขา 1) | ขา 14 | ขา 3 | ขา 5 | ADDR → ปล่อยลอย |
| ADS1115 | 3V3 (ขา 1) | ขา 20 | ขา 3 | ขา 5 | ADDR → GND · A0 ← MQ-2 (ผ่าน divider) |

### 5.3 ตำแหน่งวางเซนเซอร์

| อุปกรณ์ | ข้อกำหนดการวาง | เหตุผล |
|---|---|---|
| SCD40 | ห่างจากบอร์ด Pi ≥ 10 cm · อากาศถ่ายเทได้ · ห่างจากช่องระบายอากาศพัดลม | ความร้อนจาก SoC ทำให้อ่านอุณหภูมิเพี้ยน และกระทบค่า RH ตามไปด้วย |
| SCD40 | ห่างจากตำแหน่งที่คนหายใจใส่โดยตรง | ลมหายใจมี CO₂ ~40,000 ppm ทำให้ค่ากระโดด |
| PMS7003 | สูงจากพื้น ≥ 20 cm · ช่องลมเข้า-ออกไม่ถูกบัง · ไม่วางในทางลมของเครื่องฟอกอากาศ | ตาม datasheet — กันฝุ่นหยาบอุดและกันวัดลมวน |
| SGP30 | ห่างจากตัวทำละลาย กาว น้ำหอม ซิลิโคน | สารเหล่านี้ทำให้เซนเซอร์เสื่อมถาวร |
| BH1750 | หันหน้าไปทางแหล่งแสงที่ต้องการวัด · ไม่มีเงาของสายหรือฝาครอบบัง | |
| ไมโครโฟน | ห่างจากพัดลม PMS7003 และพัดลม Pi ≥ 30 cm | เสียงพัดลมยกค่า noise floor ขึ้น |
| MQ-2 | อากาศถ่ายเท · **ห้ามอยู่ในกล่องปิดร่วมกับ SGP30** | ฮีตเตอร์ร้อนและปล่อยความร้อนรบกวนตัวอื่น |

---

## 6. ข้อควรระวังตอนต่อสาย

1. **ปิดไฟและถอดสาย USB-C ทุกครั้งก่อนต่อ/ถอดเซนเซอร์** — ห้าม hot-plug บัส I2C
2. **ต่อ GND ก่อนเสมอ แล้วค่อยต่อ VCC** — กัน latch-up
3. **ตรวจ SCD40 ว่าอยู่ราง 3V3 ก่อนเสียบไฟครั้งแรก** — จ่าย 5V ผิดเพียงครั้งเดียวก็ทำ GPIO ของ Pi เสียหายได้
4. **สาย I2C ยาวไม่เกิน 30 cm** ถ้าใช้สายจัมเปอร์ธรรมดา — ถ้าจำเป็นต้องยาวกว่านั้นให้ใช้สายบิดเกลียวหรือ I2C extender
5. **อย่าจ่ายไฟให้เซนเซอร์จากแหล่งอื่นโดยไม่ต่อกราวด์ร่วมกับ Pi** — ต่างศักย์กราวด์ทำให้สื่อสารเพี้ยนและอาจพัง

---

[← ก่อนหน้า: สถาปัตยกรรม](01-architecture.md) · [ถัดไป: งบกำลังไฟ →](03-power-budget.md)
