Randomperson123324/enviroment-monitor/pi-vision/modes.py

"""
โหมดการทำงานของ pi-vision

โหมดไม่ใช่ไปป์ไลน์คนละเส้น — เป็นแค่ **นโยบาย** ที่ทับค่าตั้งบางตัวของไปป์ไลน์เดิม
ทำแบบนี้เพื่อไม่ให้มีโค้ดวิเคราะห์ใบหน้าสองชุดที่ต้องคอยแก้ให้ตรงกัน

ตอนนี้มีสี่โหมด — สามโหมดอยู่ในเมนู อีกหนึ่งเรียกผ่านค่าตั้งเท่านั้น

  activity — เห็นคนได้ไกลด้วยโมเดล full-range · ซูมเข้าใบหน้าเพื่อคง id ตอนคนเดิน
             · บอกกิจกรรม (ยืน/นั่ง/เดิน/วิ่ง/กวาดสายตา)          ← เมนูข้อ 1
  person   — ติดตามทีละคนพร้อม re-ID (โหมดเดิม)
  known    — รู้จักเฉพาะคนที่มีรูปใน faces/ · ไม่จำใครนอกเหนือจากนั้น
  room     — วัดภาพรวมของห้อง ไม่แยกรายบุคคล ไม่เก็บลายเซ็นโครงหน้า
             **ไม่อยู่ในเมนูแล้ว** — ตั้ง VISION_MODE=room หรือ --mode room เพื่อใช้

`ORDER` คือสิ่งที่เมนูแสดง · `MODES` คือทุกโหมดที่เรียกใช้ได้ · โหมดที่หลุดจาก ORDER
ยังทำงานได้ครบและยังถูกเทสอยู่ทุกข้อ แค่ไม่ถูกเสนอให้คนที่เพิ่งเปิดโปรแกรมครั้งแรก
— การเอาออกจากเมนูกับการลบโค้ดทิ้งเป็นคนละเรื่องกัน และอย่างหลังจะพา to_room_row()
occupancy() attention_ratio() กับ test_room_smoke.py หายไปด้วยทั้งที่ยังทำงานได้ดี

ถ้าจะเพิ่มโหมดใหม่ ให้เพิ่ม Mode เข้า MODES แล้วโมดูลอื่นจะรับไปเองทั้งหมด
"""

from __future__ import annotations

from dataclasses import dataclass

ROOM = "room"
PERSON = "person"
KNOWN = "known"
ACTIVITY = "activity"


@dataclass(frozen=True)
class Mode:
    """นโยบายหนึ่งชุด — อ่านอย่างเดียว ไม่มีใครแก้ระหว่างรันได้"""

    key: str
    label: str
    summary: str                 # อธิบายสั้น ๆ ตอนถามผู้ใช้ให้เลือก
    signatures: bool             # คำนวณลายเซ็นโครงหน้าไหม (ข้อมูลชีวมิติแบบอ่อน)
    reid: bool                   # คืน id เดิมเมื่อคนออกไปแล้วกลับมาไหม
    report_person: bool          # ใส่คอลัมน์ person ลงตาราง focus ไหม
    per_person_hud: bool         # HUD แสดงทีละคน หรือแสดงภาพรวมห้อง
    eyes: bool                   # วัดการกะพริบตา · EAR · ความง่วง ไหม
    gallery: bool = False        # อ่านรูปใน faces/ มาเทียบชื่อไหม
    known_only: bool = False     # รายงานเฉพาะคนที่จับคู่รูปได้ · คนอื่นไม่มีแถวของตัวเอง

    # ── ความสามารถของโหมดติดตามกิจกรรม ────────────────────────
    # แยกเป็นธงทีละอย่าง **ไม่ใช่ให้โมดูลอื่นเช็คชื่อโหมด** — โมดูลอื่นจึงไม่ต้องรู้จัก
    # ชื่อโหมดเลย และวันหนึ่งถ้าอยากเปิดทีละอย่างให้โหมดอื่นก็ทำได้โดยไม่ต้องแก้ที่อื่น
    # ทั้งสี่ค่าเป็น False ในโหมดเดิมทั้งสาม = โหมดเดิมทำงานเหมือนเดิมทุกอย่าง
    full_range: bool = False     # ใช้โมเดลตรวจใบหน้าระยะไกล (full-range) นำหน้าไปป์ไลน์
    roi_zoom: bool = False       # ครอปซูมเข้าที่ใบหน้าแล้วอ่าน landmark ซ้ำจากภาพครอป
    activity: bool = False       # บอกว่ากำลังยืนขึ้น/นั่งลง/เดิน/วิ่ง/กวาดสายตา
    zoom_panel: bool = False     # แผงภาพซูมมุมจอ + การ์ดข้อมูลของคนที่กำลังขยับ

    def apply_to_tracker(self, tracker_cfg: dict) -> dict:
        """คืน tracker config ชุดใหม่ที่ผ่านนโยบายของโหมดนี้แล้ว (ไม่แก้ของเดิม)"""
        cfg = dict(tracker_cfg)
        if not self.reid:
            cfg["reid_enabled"] = False
        # การ**เฉลี่ยลายเซ็นข้ามเฟรม** กับการ**จำคนที่ออกจากเฟรม** เป็นสองเรื่อง
        # โหมด known ต้องมีอย่างแรก (ไม่งั้นไม่มีลายเซ็นที่นิ่งพอไปเทียบกับรูป)
        # แต่ต้องไม่มีอย่างหลัง (ไม่เก็บ pool ของคนที่ไม่มีรูป) — ถ้าผูกสองเรื่องนี้ไว้
        # ด้วยธงเดียว โหมด known จะเงียบสนิทโดยไม่มีใครรู้ว่าเพราะอะไร
        cfg["learn_signatures"] = self.reid or self.gallery
        if self.roi_zoom:
            # เกณฑ์ "ใบหน้าต้องใหญ่เท่านี้ถึงเชื่อลายเซ็นได้" ตั้งไว้สำหรับ landmark
            # ที่อ่านจาก**ภาพเต็ม** ซึ่งใบหน้าเล็ก = landmark หยาบ = ลายเซ็นมั่ว
            # โหมดที่ซูมอ่าน landmark จากภาพครอปที่ขยายแล้ว ใบหน้าที่กินพื้นที่ 3%
            # ของเฟรมจึงให้ landmark ละเอียดพอ ๆ กับใบหน้าที่กิน 12% ในโหมดอื่น
            # ถ้าไม่ลดเกณฑ์ตรงนี้ การซูมจะไม่ให้ประโยชน์อะไรเลย — ได้ landmark ดี ๆ
            # มาแล้วถูกทิ้งที่ประตูบานเดิม
            cfg["reid_min_size"] = min(cfg["reid_min_size"], ZOOMED_MIN_SIZE)
        return cfg

    def apply_to_faces(self, faces_cfg: dict) -> dict:
        """คืน faces config ที่ผ่านนโยบายของโหมดนี้แล้ว — เหตุผลเดียวกับ apply_to_tracker"""
        cfg = dict(faces_cfg)
        if self.roi_zoom:
            cfg["min_size"] = min(cfg["min_size"], ZOOMED_MIN_SIZE)
        return cfg


# ใบหน้าต้องกินพื้นที่อย่างน้อยเท่านี้ของเฟรม ถึงจะเชื่อลายเซ็นได้ **เมื่อซูมแล้ว**
# 0.03 ของเฟรมกว้าง 640 = กรอบราว 19 px ซึ่งพอให้ครอปแล้วขยายเป็น 256 px ได้ผลจริง
# ต่ำกว่านี้คือขยายสัญญาณรบกวน ไม่ใช่ขยายรายละเอียด
ZOOMED_MIN_SIZE = 0.03


MODES: dict[str, Mode] = {
    ACTIVITY: Mode(
        key=ACTIVITY,
        label="ติดตามกิจกรรม",
        summary=("เห็นคนได้ไกลขึ้นด้วยโมเดล full-range · ซูมเข้าใบหน้าเพื่อคงชื่อไว้ตอนคนเดินไปมา"
                 " · รู้จักเฉพาะคนที่มีรูปใน faces/ ไม่แจกหมายเลขให้ใครใหม่"
                 " · บอกว่ากำลังยืนขึ้น/เดิน/วิ่ง/กวาดสายตา"),
        # ต้องคำนวณลายเซ็นถึงจะเทียบกับรูปในแกลเลอรีได้
        signatures=True,
        # **ตัวตนมาจากโฟลเดอร์ faces/ อย่างเดียว ไม่แจกหมายเลขให้ใครใหม่**
        #
        # จึงไม่เก็บ pool ลายเซ็นของคนที่ไม่มีรูปไว้จำ (reid=False) — pool นั้นมีไว้
        # คืน "หมายเลขเดิม" ให้คนที่เดินออกไปแล้วกลับมา ซึ่งเป็นตัวตนคนละชนิดกับชื่อ
        # และเป็นชนิดที่โหมดนี้ไม่ใช้ · คนที่มีรูปได้ชื่อเดิมกลับมาเองอยู่แล้วจากการเทียบรูป
        # โดยไม่ต้องจำอะไรเกี่ยวกับเขาไว้ระหว่างที่เขาไม่อยู่ในเฟรม
        reid=False,
        known_only=True,
        report_person=True,
        per_person_hud=True,
        eyes=True,
        gallery=True,
        full_range=True,
        roi_zoom=True,
        activity=True,
        zoom_panel=True,
    ),
    ROOM: Mode(
        key=ROOM,
        label="ห้องรวม",
        summary="นับคน + การหันหน้ารวมของห้อง ไม่แยกรายบุคคล ไม่วัดตา ไม่เก็บลายเซ็นใบหน้า",
        signatures=False,
        reid=False,
        report_person=False,
        per_person_hud=False,
        # ไม่วัดตาเลย — ระดับห้องต้องการแค่ "มีกี่คน" กับ "หันหน้ากันแค่ไหน"
        # การกะพริบตาและความง่วงเป็นสภาวะของร่างกายรายบุคคล ไม่ใช่ค่าของห้อง
        # และการหาค่า EAR ต้องซูมเข้าไปที่ตาแต่ละคน ซึ่งเกินกว่าที่โหมดนี้ควรทำ
        eyes=False,
    ),
    PERSON: Mode(
        key=PERSON,
        label="รายบุคคล",
        summary="ติดตามแยกทีละคนด้วย id · วัดการกะพริบตาและความง่วง · จำ id ได้เมื่อกลับมา",
        signatures=True,
        reid=True,
        report_person=True,
        per_person_hud=True,
        eyes=True,
        gallery=True,
        known_only=False,
    ),
    KNOWN: Mode(
        key=KNOWN,
        label="เฉพาะคนในรูป",
        summary="รู้จักแค่คนที่มีรูปใน faces/ · ไม่เก็บลายเซ็นของคนอื่นไว้จำ · คนที่ไม่มีรูปไม่ถูกบันทึก",
        # ต้องคำนวณลายเซ็นเพื่อเทียบกับรูป แต่ไม่เอาไปสะสมเป็น pool ของคนแปลกหน้า
        signatures=True,
        reid=False,
        report_person=True,
        per_person_hud=True,
        eyes=True,
        gallery=True,
        known_only=True,
    ),
}

# ทุกโหมดที่เรียกใช้ได้ — รวมโหมดที่ไม่อยู่ในเมนู
# ใช้กับ --mode เพื่อให้ --mode room ยังใช้ได้ (ถ้าผูกกับ ORDER จะหายไปเงียบ ๆ)
ALL = tuple(MODES)

# ลำดับที่แสดงในเมนู — known อยู่ท้ายเพราะต้องเตรียมรูปก่อนจึงจะใช้ได้
# ห้องรวมไม่อยู่ในลิสต์นี้แล้ว แต่ยังอยู่ใน MODES (ดูหัวไฟล์)
ORDER = (ACTIVITY, PERSON, KNOWN)

# ค่าเริ่มต้นของ**เมนู** — กด Enter เฉย ๆ ได้ข้อ 1
DEFAULT = ACTIVITY

# ค่าเริ่มต้นเมื่อ**ไม่มีใครให้ถาม** (cron · systemd · ท่อ) — คนละค่ากับข้างบนโดยตั้งใจ
#
# เดิมสองอย่างนี้เป็นค่าเดียวกันได้เพราะข้อ 1 คือห้องรวมซึ่งไม่ระบุตัวบุคคลอยู่แล้ว
# พอข้อ 1 กลายเป็นโหมดที่จำหน้า ติดชื่อจริง และวาดภาพใบหน้าขยายขึ้นจอ การใช้ค่าเดียวกัน
# แปลว่าเครื่องที่บูตขึ้นมาเองโดยไม่มีใครอยู่ตรงนั้น จะเริ่มทำสิ่งเหล่านั้นทันทีโดยไม่มีใครเลือก
# — จึงให้ทางที่ไม่มีคนตัดสินใจตกไปที่โหมดที่ไม่ผูกกับตัวบุคคลตามเดิม
# อยากให้เครื่องขึ้นมาเป็นโหมดติดตามกิจกรรมเสมอ: ตั้ง VISION_MODE=activity ใน .env
# (ระบุไว้ชัด ๆ ดีกว่าเปลี่ยนค่านี้ เพราะค่านี้คือทางที่ "ไม่มีใครเลือก")
HEADLESS_DEFAULT = ROOM


def get(key: str | None) -> Mode:
    """แปลงชื่อโหมดเป็น Mode — ชื่อที่ไม่รู้จักถือเป็นความผิดพลาดของค่าตั้ง ไม่เดาให้"""
    if key is None:
        return MODES[DEFAULT]
    normalized = key.strip().lower()
    if normalized not in MODES:
        # ลิสต์จาก ALL ไม่ใช่ ORDER — ไม่งั้นคนที่พิมพ์ผิดจะไม่มีทางรู้ว่า room ยังมีอยู่
        raise ValueError(
            f"ไม่รู้จักโหมด {key!r} — ที่มีคือ {', '.join(ALL)}"
        )
    return MODES[normalized]


def menu_lines() -> list[str]:
    """ข้อความเมนูสำหรับถามผู้ใช้ — แยกจากการพิมพ์เพื่อให้เทสตรวจได้"""
    lines = ["", "  เลือกโหมดการทำงาน"]
    for i, key in enumerate(ORDER, start=1):
        mode = MODES[key]
        star = " (ค่าเริ่มต้น)" if key == DEFAULT else ""
        lines.append(f"    {i}) {mode.label:<10}{star}")
        lines.append(f"       {mode.summary}")
    # โหมดที่ไม่อยู่ในเมนูยังพิมพ์ชื่อเรียกได้ — ต้องบอกไว้ ไม่งั้นมันหายไปเงียบ ๆ
    # และคนที่เคยใช้อยู่จะคิดว่าถูกถอดออกแล้ว
    hidden = [k for k in ALL if k not in ORDER]
    if hidden:
        lines.append(f"       (พิมพ์ {' หรือ '.join(hidden)} เพื่อใช้โหมดที่ไม่อยู่ในลิสต์)")
    lines.append("")
    return lines


def parse_choice(raw: str) -> Mode | None:
    """
    ตีความสิ่งที่ผู้ใช้พิมพ์ — รับได้ทั้งเลขข้อและชื่อโหมด
    คืน None เมื่อพิมพ์อะไรที่ตีความไม่ได้ (ผู้เรียกควรถามซ้ำ ไม่ใช่เดา)
    """
    text = raw.strip().lower()
    if not text:
        return MODES[DEFAULT]        # กด Enter เฉย ๆ = เอาค่าเริ่มต้น
    if text.isdigit():
        index = int(text) - 1
        return MODES[ORDER[index]] if 0 <= index < len(ORDER) else None
    # เทียบกับ MODES ไม่ใช่ ORDER — พิมพ์ "room" ที่หน้าเมนูยังใช้ได้ทั้งที่ไม่มีข้อให้กด
    return MODES.get(text)
