Randomperson123324/enviroment-monitor/(commit log)

2026-07-23 Overhaul dashboard UI/UX and remove hardcoded config
    - Redesign sensor tiles with a flood-card-style current-value bar
    - Fix header glass blur (drop hand-written -webkit-backdrop-filter,
    which Lightning CSS was deduping against the standard property)
    and add a mobile hamburger menu
    - Introduce a shared SectionHeader component so every dashboard
    section (Environment/Focus/Hydro) reads consistently
    - Replace the stat-chip row with a proper StatsTable (latest/min/avg/max)
    and collapse the system log into a diagnostics bar by default
    - Centralize remaining hardcoded thresholds/fallbacks into config/client.js
    and config/sensors.js, single-source STAT_KEYS and score-band colors,
    and do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
2026-08-08 Add pi-vision face-detection module with in-UI camera chooser
    MediaPipe face-landmark focus monitor for Raspberry Pi (CSI via
    Picamera2, USB via OpenCV), with room and per-person modes that feed
    the Focus dashboard.
    Camera chooser (press v in the display window): switch cameras live
    without freezing the render loop. Enumeration is fast and non-blocking
    — v4l2 QUERYCAP on Linux (skips UVC metadata nodes that hang when
    opened for capture), and a background-threaded OpenCV probe elsewhere.
    Claude-Session: https://claude.ai/code/session_01DGowgzebZjPeb7tA4YhVcV
    [analyzer.py, bench_reid.py, camera.py, config.py, fixtures.py, landmarks.py, main.py, modes.py]
2026-08-08 Gov data: fetch TMD/ThaiWater/RID feeds directly
    Replace the StreeFlood gov-proxy path with direct fetches to the
    government sources (TMD weather, ThaiWater, RID reservoirs) in lib/gov.js,
    configured via config/index.js and documented in .env.example. StreeFlood
    is now referenced only for the redirect button.
    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
2026-08-08 Add hardware and device documentation
    Architecture, wiring, power budget, calibration, and data-schema notes
    plus per-device references (SCD40, SGP30, MQ2/ADS1115, PMS7003, BH1750,
    USB mic) and a PDF build tool under docs/.
    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
2026-08-08 Add EN/TH language support; move disease panel to Safety & Health; remove header clock
    - i18n: LanguageProvider + useLang hook (hooks/useLang.jsx) and a TH/EN
    string catalogue (config/i18n.js); a header toggle switches language and
    persists it. Every dashboard component now renders via t(); sensor status,
    disease name/reason/prevention, flood/gov labels moved to translation keys.
    Server-generated text (AI analysis, recommendations, chat, gov feed values)
    stays in the language the source produced it.
    - Move the environmental disease-risk panel from Environment to the
    Safety & Health tab.
    - Remove the live clock from the header (the data-age indicator remains).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
2026-08-09 Add multi-provider AI: local OpenAI-compatible endpoint first, Gemini fallback
    Replaces the single Gemini client with a provider chain tried in order
    (local -> gemini by default), falling back to the rule engine in
    lib/analysis.js when every provider fails.
    - lib/ai/providers/openai-compat.js: llama-swap / llama.cpp / LM Studio /
    Ollama over POST /v1/chat/completions
    - lib/ai/providers/gemini.js: REST generateContent, now sending the key as
    the x-goog-api-key header and rejecting unusable finishReason /
    promptFeedback.blockReason responses
    - lib/ai/{index,discovery,relay}.js: chain orchestration, runtime model
    discovery, and the relay hop
    No model id is hardcoded. AI_LOCAL_MODEL de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
2026-08-09 Add per-tab AI summaries; rebuild gov data on StreeFlood's layout
    Each tab now leads with an AI summary generated server-side at most once
    every 30 minutes (AI_SUMMARY_TTL_MS) and served from cache in between, so
    switching tabs costs no model call. Failures are cached too, so a dead
    endpoint isn't retried on every tab switch.
    - Environment: the rule-engine text on the score card is replaced by the AI
    summary, with a freshness stamp and a refresh control. The score ring
    stays rule-derived — it has to move with every reading, not every 30 min.
    - Focus: pinned to the on-device provider. The pin ignores the configured
    order outright, so "on-device only" holds even when Dev Settings is s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
2026-08-09 Add a desktop sidebar, ported from StreeFlood's navigation rail
    From 1024px up (StreeFlood's `lg`), a fixed floating glass column replaces
    the top bar and the standalone tab strip: brand, divider, nav taking the free
    space, divider, controls pinned to the bottom edge. Below 1024px the existing
    top bar and its burger panel take over, so the two are never both visible.
    The rail also carries the device picker and the freshness stamp — they have
    to live somewhere once the top bar is gone, and between brand and nav is the
    natural spot. DataAge and DeviceSelect move into their own components so the
    bar and the rail render the same code instead of duplicated markup, the same
    reason TabMenu was e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
2026-08-10 Add PM1/PM2.5/PM10, and let sensors declare their own threshold shape
    The dashboard was built for three sensors and the analysis engine picked
    wording and scoring formulas by sensor id, so every new sensor meant another
    branch in lib/analysis.js. Sensors now declare a threshold shape instead:
    band - two-sided comfort range (temp, humidity)
    rising - one-sided "more is worse" (gas, PM)
    healthScore(), buildIssues() and buildRecommendations() dispatch on the shape
    and read wording from tables keyed by sensor id, so a new rising sensor is one
    risingSensor({...}) call plus its strings.
    On top of that, the three particulate channels:
    - Thresholds from the Thai 24-hour ambient standard (WH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
2026-08-10 Rework the dashboard chrome: honest data state, one home per control, QoL
    The layout looked healthy while telling the user almost nothing about whether
    what they were reading was true. Same visual language (StreeFlood glass, the
    CVD-validated palette); the information architecture and the states are new.
    Data honesty
    - Freshness is now three states, not a minute count: live / stale / offline,
    from useDataStatus(). The sidebar used to render "31376 นาทีที่แล้ว" for a
    device that had been down three weeks; lib/format.js already knew how to say
    "22 วัน" and nothing called it.
    - A notice under the top bar says outright when the page is history rather than
    the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
2026-08-10 Drop the MQ-2, and give every colour exactly one meaning
    Colour was doing two jobs at once. Each sensor had an identity colour (its chart
    line) and the tile meter filled with it, while amber/red also meant "warning" /
    "danger" — so the MQ-2's amber identity made a perfectly normal gas reading look
    like a warning next to a humidity bar that was amber because it really was one.
    fill — status only: green / amber / red / grey for no reading
    band — the healthy range, neutral: scale furniture, not a state
    dot — the sensor's identity, next to its name, where identity belongs
    The two green threshold ticks became one neutral band drawn above the fill, so
    where the value sits relat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
2026-08-10 Fold PM1/PM2.5/PM10 into one sliding "air quality" card
    Three separate tiles spent half the row on a distinction most readers do not act
    on differently: PM1, PM2.5 and PM10 are one story about the dust in the room.
    They now share a card headed "คุณภาพอากาศ" that slides between the channels, so
    the row is back to three cards — temperature, humidity, air — with no orphan
    second row.
    Auto-advancing content can take control away from the reader, so it is built to
    give it back: the rotation pauses while the pointer is over the card or focus is
    inside it, the channel labels double as a picker and a position indicator, and a
    reduced-motion preference stops the rotation en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
2026-08-10 Apply the same colour and number rules to the gov and focus screens
    The sensor tiles were not the only place where a series colour was standing in
    for a status. Both remaining data-heavy screens had the same confusion:
    - Gov rows drew 24-hour rainfall and any reservoir below the "high" mark in
    var(--c-hum) — the humidity series colour — so a plain measurement was tinted
    as if it carried a state. Measurements are neutral ink now; danger and warning
    stay for the two thresholds that mean something. The leftover `.info` tone
    points at the status palette instead of a series colour.
    - The focus panel painted "one face detected" in that same humidity blue and
    "no face" in danger red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
2026-08-10 Add one script that starts the local model and its tunnel
    scripts/start-local-ai.ps1 brings up Ollama, opens a Cloudflare quick tunnel and
    prints the URL to paste into Settings (also copying it to the clipboard).
    It exists for one flag. cloudflared forwards the public hostname as the Host
    header, and Ollama refuses any request whose Host is not local — its guard
    against a web page you have open driving your model — so it answers 403 with an
    empty body, which Cloudflare relays verbatim and which therefore reads as
    "Cloudflare blocked me". Reproduced without a tunnel at all:
    curl http://127.0.0.1:11434/v1/models -> 200
    curl -H 'Host: x.trycloudflare.com' http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
2026-08-10 Make the assistant chat-only, and dress it in the app's accent
    The floating assistant opened on an "analysis" tab that re-ran the analysis the
    page already shows: the score card carries the rule engine's recommendations and
    every tab has its own cached AI summary above the content. Two routes to the same
    paragraph, one of them spending a model call on demand. It is chat now — the one
    thing nothing else on the page does.
    Gone with it: the tab strip, the analyze button and its provider hint, and the
    ten strings only that pane used. /api/gemini-analyze stays: it is a documented
    route and the relay hop targets it.
    Colour, same rule as everywhere else this week — status colours mean state,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
2026-08-10 Grow the assistant out of its button instead of fading in beside it
    The panel slid up 14px and faded, which read as "a box appeared near the button"
    rather than the button opening. It now scales up from the button's own centre,
    and folds back into it on close.
    Getting the origin right needs the button's geometry, so that geometry now lives
    in three variables the panel reads: it positions itself at
    inset + size + gap above the bottom edge, and sets its transform origin half a
    button left of its right edge and half a button plus the gap below its bottom
    edge. Measured in the browser: the origin lands exactly on the button's centre
    (dx 0, dy 0) and the resting panel clears the button by the fu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
2026-08-10 Turn the assistant into a window on desktop: dock, drag out, snap, resize
    On desktop the assistant now opens snapped to the right edge and behaves like a
    window: drag its title bar to pull it out, drop it back near that edge to snap it
    in, resize it in either mode. Geometry is remembered per browser.
    Docked shares the screen rather than covering it. useAiWindow publishes the
    current width as --ai-dock-w and stamps data-ai-docked on <html>, so the shell
    reserves the space and the floating button steps aside without the value being
    threaded through every component in between. Verified in the browser: content
    ends at 1093 and the panel starts at 1121.
    Nothing changes below 1024px. Dragging a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
2026-08-10 Fix the dock button, fold the rail away when space is tight, seam the dock
    Three things, all in the assistant-as-a-window work:
    The dock/undock button did nothing on a real click. Pressing anywhere on the
    title bar started a drag, and a drag claims pointer capture — which retargets the
    following *click* to the capturing element, so the buttons never received it.
    A press that lands on a control is now left alone. While there: a press only
    becomes a drag after 4px of movement, so a click that jitters no longer undocks
    the window, and a press that never moved does not run the snap check on release.
    The nav rail folds away when a wide docked assistant leaves the dashboard too
    little room (un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
2026-08-10 Group the assistant's window controls, and stop the rail flickering on hover
    Title bar: it is a space-between row, and with four children that spread them
    across the whole width — the provider tag floated in the middle of the bar with
    the two buttons far apart. The title takes the slack now, so the tag and the
    controls group at the right where window controls belong, the tag truncates
    instead of pushing them off, and the two buttons sit closer to each other than to
    the tag so they read as one group.
    Rail hover: parked at the very screen edge, the peek strip sat to the *left* of
    where the revealed rail starts (the rail floats 16px in). So revealing it moved
    the rail out from under the poin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
2026-08-10 Give the assistant a centred greeting and a glow at its bottom edge
    Until a conversation exists the panel is one large empty surface, so the empty
    state now carries the whole thing: a marked bot icon, a greeting, and the two
    hint lines, dead centre of the message area. Measured centre of the greeting
    block matches the centre of the list on both axes.
    Behind the input row, an accent gradient rises 190px from the bottom edge. It is
    a pseudo-element on the panel, which already clips its own overflow, and the
    header, list and input row are lifted above it so nothing the user reads or types
    sits inside the wash. A conversation long enough to scroll now fades into that
    glow rather than being cut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
2026-08-10 Survive a retired model and a hanging provider, and pin Gemini 3.5 Flash Lite
    "Cloud AI doesn't work" was not the key. Production reported gemini_enabled with
    a valid key and Google returned a 36-model list; generation answered 404 —
    "models/gemini-2.5-flash is no longer available to new users". The list endpoint
    still advertises that name, so everything looked configured right up to the point
    of asking it for text. GEMINI_MODEL is gemini-3.5-flash-lite now, verified
    against the production key through a header override before changing anything:
    a real reply in 1.5s.
    Two holes that let a working provider look broken, both now closed:
    A rejected model recovers itself. On a 404/400 that men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
2026-08-10 Name the open section on the page, in Thai, and split the safety tab in two
    Each section now carries its own heading with a dotted leader running the full
    width beneath it. The rail was the only thing naming the current section, and on
    a wide screen the active pill sits far from the content it labels.
    The tab names were English string literals in config/client.js, so they stayed
    English with the interface switched to Thai. They live in the string catalogue
    now — สภาพแวดล้อม · การจดจ่อ · ความปลอดภัยและเหตุฉุกเฉิน — which also means the
    shortcut sheet can name the real tabs instead of repeating them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
2026-08-10 Make the page heading a hairline and a size larger, and settle on Safety & Health
    The dotted leader under each heading is one thin line now, and the heading itself
    goes 22px → 28px (19 → 23 on a phone) so it reads as the page's name rather than
    another section label.
    The rule is a background gradient rather than a border, which lets it fade out at
    the far end instead of stopping dead against the edge of the content.
    The safety tab keeps its original name in both languages: Safety & Health /
    ความปลอดภัยและสุขภาพ.
2026-08-10 Set the interface face to Noto Serif Thai
    Loaded through next/font/google with both the thai and latin subsets, so one
    family covers both languages and the interface does not change character when the
    language toggle flips.
    The CSS variable keeps its name, --font-sans: every rule downstream is asking for
    "the UI font" rather than for a sans specifically, and renaming it would touch the
    whole stylesheet to say the same thing.
    Numeric readouts stay on IBM Plex Mono. They are the one place where the family
    is load-bearing rather than decorative — tabular figures are what keep a value
    from shifting sideways as it ticks, and the tile, table and meter alignment is
    built on that.
    Verified in t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
2026-08-10 Float the snapped assistant instead of welding it to the screen edge
    Docked, it now gets the same treatment as the nav rail on the other side: inset
    from the top, right and bottom, fully rounded, its own border and shadow. Flush to
    the edge it read as part of the browser chrome and the page looked like it ran
    underneath — the gap is what makes it a separate surface.
    The page and the floating button clear the inset as well as the panel width, or
    content would slide into the gap. Measured: 16px above and below, 24px radius, and
    the tiles stop 28px short of the panel's edge.
2026-08-10 Treat a quota-zero model the same as a retired one
    Production still could not reach Gemini after the deploy, now with 429 "You
    exceeded your current quota" rather than 404. Same cause: a model name Google has
    retired for new keys has a quota of zero for them, so the refusal arrives dressed
    as a rate limit. The recovery only looked for 404/400, so it stood aside.
    429 now counts as "this model is unusable" — but only when a model was pinned. If
    the name came from the provider's own list there is nothing to escape to, and a
    429 there is a real rate limit that a retry would only make worse for whoever
    shares the quota.
    Both branches exercised against a fake provider that lists a model it ans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
2026-08-10 Walk the model list on recovery instead of trusting its first entry
    The recovery shipped in the last deploy fired correctly in production and was
    refused again: it asked Google for a replacement model and took the first one
    listed, which for a new key is another retired name. A provider's list order is
    not usefulness order.
    So recovery now tries several, best first, bounded by AI_MODEL_RETRY_MAX and the
    chain budget. "Best" puts `-latest` aliases ahead of everything else — a provider
    publishes those to mean "the current one", which is precisely the question being
    asked when a pinned name has just been refused — and then prefers a model the
    endpoint reports as loaded over one it would co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
2026-08-10 Read expression from blendshapes, and name people from photos you drop in
    Two things pi-vision could not do: it never reported how anyone looked, and it
    handed out a fresh number every time somebody walked back into frame.
    **Emotion** (emotion.py) reports happy / sad / surprised / angry / neutral from
    the blendshapes the pipeline already computes for blink detection — no extra
    model, no second inference, no more CPU on the Pi. Each expression is scored from
    the muscles that have to move together, not one blendshape alone, because a lone
    one fires from talking or turning the head. A majority vote over 12 frames stops
    the value jumping while somebody speaks. "neutral" is an answer, not a fa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
2026-08-10 Send each window to Supabase, and add the two columns it needs
    The focus table now has name and emotion (nullable text, existing rows NULL), and
    pi-vision can finally reach it: uploader.py posts every 15-second window through
    the Supabase REST API. Until now to_focus_row() had no destination — the README
    listed the uploader as a to-do.
    Two constraints shaped it:
    The camera loop must never wait on the network. A POST that hangs for ten seconds
    costs 150 frames, and a gap in the landmark stream corrupts the movement count
    the whole feature exists to measure. So send() drops a row on a queue and returns;
    a background thread does the talking.
    Losing the network must not lose data. The queue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
2026-08-10 Stop the test scripts from dying on a Windows console
    Every test prints its findings in Thai, and a default Windows console encodes
    stdout as cp1252, which has no Thai characters. The first print raised
    UnicodeEncodeError and the run ended with a traceback — so all four suites looked
    broken on a machine where the logic was entirely fine. That is the worst kind of
    failure: it points the reader at the code instead of at the console.
    Each script now forces its own stdout to UTF-8 before printing. Verified by
    running all four in a plain cp1252 shell with no PYTHONIOENCODING set: four
    passes, no traceback.
    [test_faces_emotion.py, test_logic.py, test_room_smoke.py, test_uploader.py]
2026-08-10 Show the expression on screen, and add a mode that knows only the photos
    Two things, both stemming from the same report: the emotion reading appeared to
    do nothing.
    It was running. Every display path hid "neutral", so a person sitting with a
    relaxed face — which is most of the time — saw no emotion text anywhere, and had
    no way to tell the feature apart from one that was off or broken. Hiding the
    common case to reduce clutter cost the feature its only evidence of existing.
    It now prints the expression always, neutral included, so an empty slot means one
    thing only: no blendshapes, feature off. It is also announced at startup like
    re-ID is, and appears in the console summary line — whi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
    [analyzer.py, config.py, main.py, modes.py, overlay.py, test_faces_emotion.py, test_logic.py, test_room_smoke.py]
2026-08-10 Ask which camera at startup, and always name the nearest face
    Two requests.
    The camera is now chosen before anything else happens — before the model download
    and before the capture device is opened, so the question does not arrive after a
    wait. It only asks when there is something to decide: one camera found is selected
    silently, because a question with a single answer is not a choice, and no cameras
    found asks nothing either, letting Camera.open() report the real problem rather
    than showing an empty list. --source still skips it, CAMERA_ASK=false turns it off
    permanently, and no TTY means no prompt at all — systemd and cron must never block
    on stdin. The `v` menu still switches cameras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
    [analyzer.py, config.py, faces.py, main.py, overlay.py, test_faces_emotion.py, test_logic.py, test_room_smoke.py]
2026-08-11 Let the assistant fetch what it needs, and answer as it types
    The chat used to carry one pre-rendered sentence of the latest reading, so it
    could only answer questions about that sentence. Asked about last night's
    humidity or the rainfall upstream it had to guess or decline, with the data one
    call away and nothing able to ask for it. Now it gets tools instead: sensors,
    history, government water data, flood gauges, health risks, camera focus, and
    web search.
    Camera data is the exception, enforced three times over. Providers outside
    AI_FOCUS_PROVIDERS are never offered the focus tool, are told in their system
    prompt that they cannot reach it, and are refused by runTool() if they call it
    anywa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
2026-08-11 Run the model in the browser, and give Settings a table of contents
    Ports StreeFlood's on-device assistant — its GPU path only. The model downloads
    once and runs here on WebGPU through @mlc-ai/web-llm, so a conversation can stay
    on this machine entirely. The CPU (wllama/WASM) path is deliberately left behind:
    it needs cross-origin isolation and a second engine to keep working.
    Three details carried over because each of them is a bug someone already had:
    - A GPU without shader-f16 cannot compile the q4f16 shaders, and only finds out
    once the whole 2.5 GB has downloaded. So the adapter is asked first and every
    id, size and cache check follows the answer.
    - The engine runs on the main t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
2026-08-11 Drop the engine button from the composer
    Where the model runs is not a per-question switch. The two buttons left beside
    the input — search, show thinking — change what this one question does; the
    engine choice is a preference, and it now lives only in Settings. Which engine
    answered is still on screen, in the assistant's title bar.
    Takes the plumbing with it: the onOpenSettings prop, the settingsSection state
    and SettingsModal's initialSection existed only to let that button jump to its
    pane, and the three i18n strings only labelled it.
2026-08-11 Centre the icon in the send button
    The button laid its icon out as text, so the SVG sat on the baseline: 4.4px above
    the circle's centre. The arrow nearly got away with it; the stop state's small
    square did not. Placed with grid now, like the FAB and the composer's toggles
    already are — measured at 0,0 offset in the 40px circle.
2026-08-11 Give Gemini back the thought signature it issued
    Gemini 3 attaches a thoughtSignature — an encrypted digest of the reasoning — to
    each functionCall part, and refuses the next request unless it comes back
    untouched. appendToolRound rebuilt the model's turn from the call's name and args
    alone, so the signature was dropped and the turn died at the second round with
    "Function call is missing a thought_signature in functionCall parts". Clicking
    search was the way to hit it, being the case where the model really does call a
    tool.
    That also explains the thinking button appearing to do nothing. The retry added
    in the last commit fired on *any* 400, so the missing-signature error was quietly
    ret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
2026-08-12 Tell Gemini how hard to think, not just to show its thoughts
    The brain button did nothing on gemini-3.5-flash-lite, the default model, and
    nothing was refused: includeThoughts asks for a summary of whatever thinking
    happened, and every Flash-Lite in the Gemini 3 family thinks at `minimal` unless
    told otherwise. The turn streamed a normal answer with no thought parts in it.
    The level is a second dial whose name changed with the family — 3.x takes
    thinkingLevel (minimal/low/medium/high), 2.5 takes thinkingBudget in tokens, and
    sending both at once is a 400. The provider now reads the family off the model id
    and sends the matching shape, keeping the others behind it: an uppercase level
    (the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
2026-08-12 Say when the model came back with no thoughts
    Gemini 3 leaves the thought text empty on most turns where it calls a tool — the
    reasoning goes back as an encrypted thoughtSignature instead — and every question
    about this room calls one. Measured on gemini-3.5-flash-lite: thoughts on 1 of 4
    identical tool-calling turns, and on every turn that needed no tool.
    gemini-3.5-flash returned them 3 times out of 3, so this is the small model, not
    the request. It is a known Google-side bug, patched once and still intermittent.
    So the brain button's real failure mode is silence, which is indistinguishable
    from a broken button. The block now appears either way: with the reasoning when
    there is any, a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
2026-08-12 Choose the AI with three buttons, arrange it with three boxes
    The assistant's engine used to be a dropdown of two ("on the server" / "in this
    browser") sitting above a second dropdown of five canned priority orders, and the
    two contradicted each other often enough that the priority list had to be greyed
    out to explain itself. Neither said what it meant.
    Now there are three engines with names — Cloud AI, Local, In this browser — as
    three buttons for the ordinary choice, and as a lane of boxes for arranging a
    fallback. Left to right is the order they are tried; an engine dragged out is not
    used at all; the lane takes one box or all three and never zero, since something
    has to answer. Each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
2026-08-12 Pick the on-device model from Hugging Face, not from a list of two
    The browser engine shipped with two Qwen3 builds hardcoded, which is a fine
    recommendation and a poor catalogue. Settings → In this browser now searches
    Hugging Face's mlc-ai account, with download counts, VRAM, context window and the
    real download size measured from the repo's own file tree.
    The listing is a join, and both halves matter. Hugging Face is the index: it is
    where the MLC conversions live, and it knows which are popular. web-llm's
    prebuiltAppConfig is the gate: running a model in a browser takes more than
    weights — it takes a WebGPU shader library compiled for that architecture and
    quantisation and pinned to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
2026-08-12 Move the assistant into the rail, where the rest of the navigation lives
    The floating button sat over the page's bottom-right corner, which is the one
    place a docked assistant panel also wants, and it was the only control on screen
    with no home — every other button lives in the top bar or the rail. It is now a
    row at the foot of the sidebar, under a divider so it does not read as a fourth
    section: pressing it opens a panel, it does not navigate.
    The floating copy stays below 1024px, because that is exactly where the rail is
    display:none and it would otherwise be the only way in. The two rules are mirrors
    on the same breakpoint, so there is one entry point at every width and never two.
    Th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
2026-08-12 Stop shipping a model name in the source
    Two Qwen3 builds were hardcoded in lib/ai/browser/models.js with hand-copied
    labels, sizes and VRAM figures, and one of them was the default the browser engine
    loaded. That list could only ever drift: the numbers came from a web-llm release
    read by hand, and the catalogue they claimed to summarise is 163 builds long and
    moves with every upgrade. Now that the picker searches Hugging Face, keeping two
    of them nailed down in the source bought nothing.
    So the file names no models at all — it holds id arithmetic and nothing else — and
    "no model chosen" becomes a real state rather than an impossible one. The pane
    opens straight into the search and says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
2026-08-12 Make the settings dialog reachable on a phone
    On a 390px screen the dialog laid itself out at its full 760px and hung off the
    right edge, with Save among the parts you could not reach — and nothing scrolled,
    because a fixed overlay does not extend the document. The cause was the overlay's
    grid: with no explicit track it used `auto`, which sizes to the item's
    min-content, so a dialog with a fixed `width` sized the track to itself and
    `max-width: 100%` measured against that track rather than the screen. One
    `minmax(0, 1fr)` fixes every dialog in the app; the settings one now lays out at
    352px on a 387px viewport, footer included.
    The rest is what a phone needs once it can see the thing:
    -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
2026-08-12 Call them On-device AI and Self-hosted AI
    "In this browser" described the container rather than the promise, and "Local"
    was the worst name in the app: it read as the on-device model to anyone who had
    not learned that the browser engine was the *other* one, and the two sat next to
    each other in the same picker. They are now On-device AI and Self-hosted AI in
    both languages, everywhere they surface — the engine buttons, the priority lane,
    the settings sections, the field labels, the download question, and the panel's
    title chip.
    Display only: the ids stay `browser` and `local`, so stored chains, the
    x-ai-order header and every provider lookup are untouched.
    Two strings followed rather tha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
2026-08-12 Give the engines icons that match where they run
    Self-hosted AI takes lucide's Server, On-device AI takes Cpu — a rack for the box
    we run, a chip for the machine in front of you. On-device was MonitorSmartphone,
    which said "a screen" rather than "your hardware", and Self-hosted was Cpu, which
    said the opposite of what it meant. Both the engine picker and the settings
    section list follow the same map, since they name the same three things.
2026-08-12 Call the cloud provider Cloud AI in the settings too
    The engine picker had said Cloud AI since the three-button rewrite while the
    settings section, the key field, the base URL and the model picker all still said
    Gemini — the same engine under two names, one of them the vendor's. They now all
    say Cloud AI, as does the focus tab's promise that camera data never leaves the
    building.
    The engine's own hint still names Google's Gemini, and deliberately: it is the
    one line that says what is actually being called, and the key you paste into the
    field above comes from Google AI Studio. A rename that hid that would cost more
    than it bought.
2026-08-12 Default to Self-hosted AI on gemma4:e2b
    The deployment now ships its own answer: AI_LOCAL_MODEL defaults to gemma4:e2b,
    the model this endpoint actually runs, with the chain still local first and the
    cloud behind it. The pin is not a promise — a name the endpoint refuses sends
    runChain back to ask what it does have — and AI_LOCAL_MODEL= (empty) restores the
    old always-ask behaviour. The self-hosted model field names the pinned model as
    its placeholder now, the way the cloud pane already did: "automatic" stopped
    being the whole truth once there was a default to be automatic about.
    Fixes a hole the chain rewrite left, and the reason this needed testing rather
    than believing: a browser tha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
2026-08-12 Give settings their own pages, and move Cloud AI to /dev-setting
    Settings were a modal over the dashboard. They are now two routes: /setting for
    what someone using the dashboard adjusts — which AI answers, the on-device model,
    the endpoint we host, the poll interval — and /dev-setting for the cloud account:
    key, base URL, model. Sending the room's data to Google is a deployment decision
    rather than a reader's, so it lives behind a URL you have to know, linked once
    from the top of /setting.
    A page is what these always were. You can link to them, reload them, and come
    back from them, and the on-device model download — minutes long — no longer lives
    in a dialog that a stray click on th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
2026-08-12 Let the settings pages have the whole window
    They were a 760px card floating in the middle of an empty screen — a dialog
    wearing a page's clothes. The card is gone: the bar spans the top, the section
    rail runs down the left at full height, the pane is the only thing that scrolls,
    and Save sits on the bottom edge where it stays put.
    Full-bleed, but the fields stop at 680px. A text input 1200px wide is not more
    usable than one at 640; it just puts more distance between a label and the box it
    belongs to. So the pane goes edge to edge and its contents are capped.
    Checked at 1536px and at 387px: no horizontal scroll at either, the phone keeps
    its chip strip and its pinned footer, and the sing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
2026-08-12 Put the settings in the assistant's panel, as its second tab
    Settings were a full-screen page a moment ago and a dialog before that. They
    belong beside the thing they configure: which AI answers, on what model, with
    what endpoint — all of it is about the panel it now lives in. Two tabs in the
    title bar, one face at a time. Not a split: the dock is ~400px wide, and dividing
    that between a conversation and a form leaves neither usable.
    The form's narrow layout is now a container query, not a media query. It renders
    at three very different widths inside the same viewport — a full-screen page, a
    ~400px dock, a phone — and only the box it sits in knows which. `container:
    settings / inline-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
2026-08-12 Open settings as a tab, the way a browser does
    The settings tab sat in the panel's title bar at all times, taking half a narrow
    bar for something looked at once a week — and naming a second face the assistant
    mostly does not have. It is opened now, by the gear in the header, and closed by
    the × on the tab itself. With it closed there is one tab, which reads as the
    title it replaced.
    Browser semantics throughout: the gear opens the tab if it is missing and focuses
    it if it is already there; switching to the conversation leaves the tab open
    where you left it; the × closes it and lands back on the conversation, as does
    Save, since saving is the end of the errand the gear started.
    The tab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
2026-08-12 Close the assistant tab too, and fill the screen on the gestures that ask for it
    Both tabs carry a ×. Closing one moves focus to whichever is left; closing the
    last one closes the window, which is the only answer that makes sense — a panel
    with no tabs has nothing to show — and reopening starts from a fresh strip, since
    a window that comes back with the tabs you closed is not a window you closed.
    Two drops now fill the screen: dragging the window more than 60% of the way
    across (`AI_WINDOW.fullDragRatio`, measured on the pointer) or up against the top
    edge, as window managers have taught everyone to expect. Filling wins over
    docking where the two zones meet in the top-right corner: som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
2026-08-12 Open settings on their own, and light the button that opened them
    The gear used to open the conversation as well, because the panel came with the
    chat tab already there. Someone reaching for the gear asked to change a setting,
    not to start a chat, so on a closed panel it now opens settings alone. On a panel
    already open the conversation stays put and settings join it as a second tab —
    closing something nobody asked to close would be the worse mistake.
    The gear also lights up while its tab is open, the accent fill the rail's
    assistant button wears: a button holding a panel open should say so.
    And the rail's button now tracks the *conversation's* tab rather than the window.
    It glowed for a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
2026-08-14 Show who each person is on the focus page, and what they were doing
    pi-vision already recognised faces from the photo gallery and worked out
    whether someone was standing or sitting, but only the movement counts ever
    reached the dashboard. focus rows now carry posture and posture_confident
    next to the name and emotion that were already being written, and the page
    shows all three: the name leads each legend chip, and the detail card gained
    posture and expression cells.
    The chart groups its lines by name rather than by track number. The activity
    mode sets reid=False deliberately — identity comes from faces/ alone — so a
    person who leaves the frame and comes back is issued a fresh number, a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
    [analyzer.py, body.py, camera.py, config.py, detect.py, faces.py]
2026-08-15 Give the ESP32-S3 firmware its own Supabase upload, and fix the dashboard's stale-device fallback
    The multi-sensor sketch now runs SCD40/SGP30 on separate I2C buses, drives
    BH1750 over bit-banged I2C, connects to WiFi, and POSTs readings straight to
    Supabase's REST API instead of only printing to Serial.
    buildDashboard() never actually fell back to a known device when the
    requested/cached device_id didn't exist anymore — it kept re-resolving to the
    stale id, so a browser with an old device_id in localStorage would show no
    data forever even once a real device was reporting.
    [multi_sensor_esp32s3.ino]
2026-08-15 Wire CO2 and eCO2 end to end (ingest, scoring, tiles, chart, stats, docs)
    Both already had columns in Supabase and the firmware already sends them —
    only the app-side wiring (config/sensors.js, ingest aliases, i18n/messages,
    a CO2/eCO2 chart) was missing. eCO2 (SGP30, a VOC-derived estimate) reports
    and shows on its own tile but never scores or advises, the same way PM1
    stays out of scoring so it doesn't double-count PM2.5's dust.
    Colors for the two new tiles/series were picked and verified with the
    dataviz skill's CVD validator against the existing 6-color palette (which
    itself already has pre-existing adjacent-pair failures — out of scope here,
    noted in config/client.js for whoever to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
2026-08-15 Wire TVOC end to end, in its own ppb chart alongside CO2/eCO2
    Same pattern as CO2/eCO2: ingest alias, tile, stats row, i18n/messages.
    It gets its own chart group ('voc', not 'gas') because it's ppb while
    CO2/eCO2 are ppm — sharing an axis would repeat the old MQ-2 divisor
    mistake. Unscored (advise: false) for the same reason eCO2 is: TVOC and
    eCO2 are both derived from the SGP30's one raw VOC signal, so scoring
    both would penalize that signal twice.
    Color picked and CVD-validated against the full existing palette with the
    dataviz skill; no green was left that also clears the health-score ring's
    green, so TVOC reuses it — acceptable since the two never sit in the same
    chart/legend, but n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
2026-08-15 Split temp/humidity onto their own charts and even out the environment grid
    Temperature and humidity now get separate charts instead of sharing one axis,
    and sit alongside the air-quality meter as the first row; score, CO2/eCO2,
    and TVOC fill a second even three-up row instead of squeezing into a narrow
    side column.
2026-08-15 Swap the AQI meter for the real PM chart in the environment top row
    The third slot in the temp/humidity row now shows the actual PM1/PM2.5/PM10
    line chart instead of the PM2.5 bands meter, so all three top charts are
    real graphs. Drops the now-unused AQI meter widget and its bands config.
2026-08-15 Reorder the sensor tiles: temp/humidity/air quality lead, rest fill their own row
    The tile grid was one flat auto-fit row, so 7 tiles at 4-across left the
    second row three wide with a dangling gap. Split it into two grids: temp,
    humidity, and the air-quality tile up front, then CO2/eCO2/TVOC/light in
    their own row that fills its width independently.
2026-08-15 Expand any sensor tile into a full-screen history
    Clicking a tile opens that sensor over the page: a full chart with real axes
    and tooltips, the ideal range shaded straight onto the plot, min/avg/max for
    the window, and range pills. The whole card is the target (Enter/Space work
    too), Esc or the backdrop closes it, and focus returns to the tile.
    The pills drive the dashboard's own window rather than a local copy, so
    closing the view never snaps the tiles to a different range than the one
    just being read. On the air card the channel dots still switch PM1/2.5/10
    without opening anything; the rest of the card expands whichever is showing.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
2026-08-16 Slide a changed reading in digit by digit
    A readout that ticks used to blink straight to its new value. Now the old
    digit rises out of frame shrinking and blurring while the new one arrives
    from below, overshoots once, and settles.
    Only the characters that actually changed move: 26.6 -> 26.9 animates the
    last digit and leaves "26." sitting still. Positions are matched from the
    right so decimals stay aligned when the integer part gains or loses a digit.
    That relies on the tabular figures every readout here already uses.
    Wired into the sensor tiles (so the air card's channel rotation gets it
    too), the expanded sensor view, the score ring, the AQI meter, the flood
    station level, and the stats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
2026-08-16 Give the project a front page
    The repo had no README at its root -- only the hardware doc index under
    docs/ and the camera notes in pi-vision/, both scoped to their own corner.
    Anyone landing on the repo had nothing that said what this is.
    Written as a project overview rather than a setup guide: why indoor
    environment matters to attention, what the system measures, how the four
    parts fit together, and what the AI is allowed to touch. Install shrinks to
    one section near the end.
    Section 7 states the real status -- dBA is designed but not wired in, and
    the move to a Raspberry Pi 5 station is still design-only while ESP32-S3 is
    what actually runs.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
2026-08-16 Watch the room for phones, and ask whether the air is why it fidgets
    Three things that lean on each other: the Pi learns to tell a phone in a
    hand from a phone on a desk, the dashboard shows what it found, and the
    assistant can finally line the camera up against the sensors on one clock.
    ── The assistant can correlate now ──────────────────────────────────────
    "ช่วงที่ CO₂ สูงขึ้น การมีส่วนร่วมของห้องลดลงหรือไม่" used to get an answer
    assembled from two summaries that never touched. The model has no way to
    join two tables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
2026-08-16 Name who is on their phone, and stop renaming them first
    The card answered "how many", which is never the question. It names them
    now, with the chart's own swatch so a name here can be found on a line
    there, and the trailing ? it carries everywhere else — distance match
    rather than a phone seen in a hand.
    ── The card was also naming the wrong people ────────────────────────────
    Seeding rows for Donut and Im put "Pun" on the card. Rows were grouped by
    each track's majority name, and in the activity mode this Pi runs re-ID is
    off by design, so track numbers get reissued constantly: real rows seconds
    apart read person:1 for Nicha, t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
2026-08-17 Call it classroom engagement, not focus
    The camera tab measured how often heads turn away from a resting pose, but
    naming that "การจดจ่อ" claimed something the metric cannot see — whether a
    person is concentrating. Renaming it to การมีส่วนร่วมในห้องเรียน (classroom
    engagement) describes what the number actually is: how much the room is
    participating rather than what any individual is thinking.
    Renamed across both locales, plus the glossary lines and the AI prompts, so a
    summary does not answer in the old vocabulary while the tab beside it uses the
    new one.
2026-08-18 Score the whole session, not just the newest minute
    The focus tab could say how the room looked in the last minute and nothing
    about how the lesson had gone. This adds the counterpart of the room-health
    score: one 0-100 ring over the window the chart draws, built the same way —
    start at 100, subtract a penalty per signal, clamp, then read the band off
    the *same* SCORE_BANDS cutoffs, so a 62 here means what a 62 on the
    environment ring means and paints in the same colours.
    Movement (55), phone use (35) and lying posture (20) are the signals, and a
    signal nothing measured is skipped rather than scored as clean — a Pi
    without PHONE_ENABLED scores on the other two, exactly as a sensor that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
2026-08-18 Send Gemini variables where the names used to be
    A real name is not a measurement. "ปุณณ์ ขยับ 12 ครั้ง/นาที" and
    "{{NAME_1}} ขยับ 12 ครั้ง/นาที" ask a cloud model exactly the same question,
    and only one of them tells Google who was in the room. So every identifier
    leaving this machine is swapped for a variable on the way out and swapped
    back on the way in: the model reasons about the same data, the provider
    never sees a name, and the user reads real names throughout.
    Nothing here knows a single name. The map is built per request from
    identifier-shaped fields in whatever is being sent (matched on field name,
    so a tool added later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
2026-08-18 Drop the meteorological feeds from safety & health
    The TMD card carried nationwide weather — announcements and a regional daily
    forecast — on a page about this room's water and health. It was the one
    section nobody could act on: knowing the north will have scattered showers
    does not change anything a person reading their own room's disease risk and
    their own district's river level would do next.
    Removed the whole path rather than hiding the card: both TMD fetchers, the
    XML helpers that existed only for them, the uid/ukey (a key with nothing to
    call is another secret to look after), the four CSS rules, and the strings
    in both languages. What is left is measured water — ThaiWater's warn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
2026-08-18 Cut the water half; the tab is about health now
    The safety tab answered two unrelated questions behind a switch: the water
    situation across the country, and what this room's air is doing to the
    people in it. Only the second is something the person reading it can act on
    — and it was the half hidden behind a toggle.
    So the tab is now just Health, and everything that served the water half is
    gone rather than hidden: the flood-gauge bridge and its Supabase tables, the
    ThaiWater and RID feeds, both API routes, the hero, the panels, the
    StreeFlood link button, the view switch and the storage key that remembered
    which half you were on, their strings in both languages, and ~700 lines of
    CSS. Two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
2026-08-18 Light the AI card from behind while the model writes
    Waiting for a summary looked like nothing happening. Worse on a refresh with
    a summary already on screen: the button did nothing visible for the several
    seconds a model takes, so the only way to tell it had registered the press
    was that the timestamp eventually changed.
    So the card now lights from behind while it works — three soft colour blobs
    drifting under the glass the panel already has, on 11s / 14s / 26s periods
    that take minutes to line up again, so the motion never resolves into a loop
    the eye can lock onto. Not a spinner: the wait has no fraction to be a
    fraction of, and a light that simply keeps moving says "still working"
    wit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
2026-08-18 Let the on-device engine write the summaries too
    Choosing on-device AI in settings used to move only the chat. The summary
    cards kept asking the server for a summary of the same readings, which
    quietly undoes the one thing that switch is for — so they now follow it, and
    the server hooks are disabled outright in that mode rather than left running
    as a fallback that would send the very request being avoided.
    **It never runs on its own.** A server summary is a cached HTTP call; this
    one is somebody's GPU for anywhere from seconds to minutes, and a first run
    downloads gigabytes. So there is no poll, no run on mount, no run on a tab
    switch — an un-analyzed card shows an Analyze button and wa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
2026-08-19 Let the cloud read the camera data, as variables
    The focus tools were closed to every provider but the on-device engines, so
    asking Gemini about the classroom got a refusal even though the alias layer
    already existed to make the question answerable.
    Split the gate in two. AI_FOCUS_PROVIDERS still means "may hold real
    identities"; AI_FOCUS_VIA_ALIAS (new, on) means "everyone else may read it
    pseudonymised". mayReadFocus() grants the second only while the masking is
    actually enabled, so the unsafe combination cannot be configured — turning off
    AI_ALIAS_ENABLED closes the cloud out of camera data rather than sending names.
    The summary path needed one more thing: it builds its own prose, and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
2026-08-20 Say what each reading is worth to the room score
    The ring is one number built from six sensors at different weights, and nothing
    on screen said so — watching 34 °C you could not tell whether the 62 was mostly
    the heat or mostly the dust.
    Each tile gets a "?" that answers both halves: the ceiling (what this sensor can
    ever cost) and the live figure (what it is costing right now). `scoreWeight()`
    runs the same SCORE_PENALTY table through the same shape functions healthScore()
    uses, so the explanation cannot drift from the arithmetic it describes — a unit
    test reconciles the parts against the score for five readings.
    The three sensors the score leaves out say so outright and give the rea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
2026-08-20 Put the date in the focus chart's tooltip
    Every other chart's tooltip led with "20/08 21:08:25"; this one led with the
    axis label, which is the clock alone. A time on an unknown day is not something
    anyone can check later — and this is the chart most likely to end up
    screenshotted into a report.
    The bucket timestamps were already being handed to the tooltip, so it just uses
    them. Seconds stay off here: these bars fold four 15-second rows into a minute,
    and a seconds figure would name an instant the point does not stand for.
2026-08-20 Order the charts by their timestamps instead of assuming
    buildHistView walked the row array backwards because the API answers
    newest-first. That is an assumption about the caller, not a property of the
    data — and when it does not hold the chart draws right-to-left with nothing on
    screen to say so. It was the only chart builder that trusted its input;
    bucketize and buildPersonSeries both sort.
    Now it sorts on the parsed timestamp, so newest-first, oldest-first and
    shuffled input all render the same chart. A row whose created_at will not parse
    is dropped rather than pinned to whichever end it happened to sit at — it has
    no position on a time axis at all.
    trailingMean (the PM tiles' rolli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
